lizlarkin/highland/client/src/Components/GeneralJumbotron/Images/Search.png

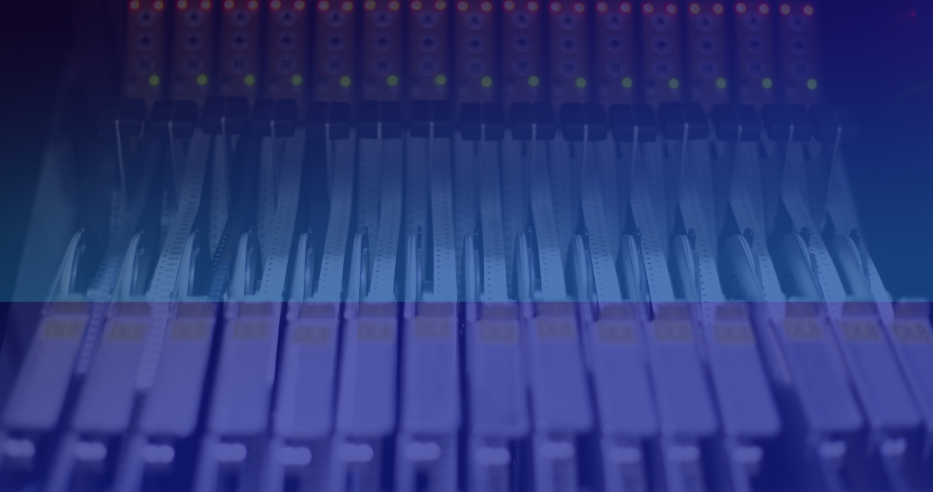
client/src/Components/GeneralJumbotron/Images/Search.png
