lizlarkin/highland/client/src/Components/CategoryJumbotron/img/Laser_Drivers_Controllers.png

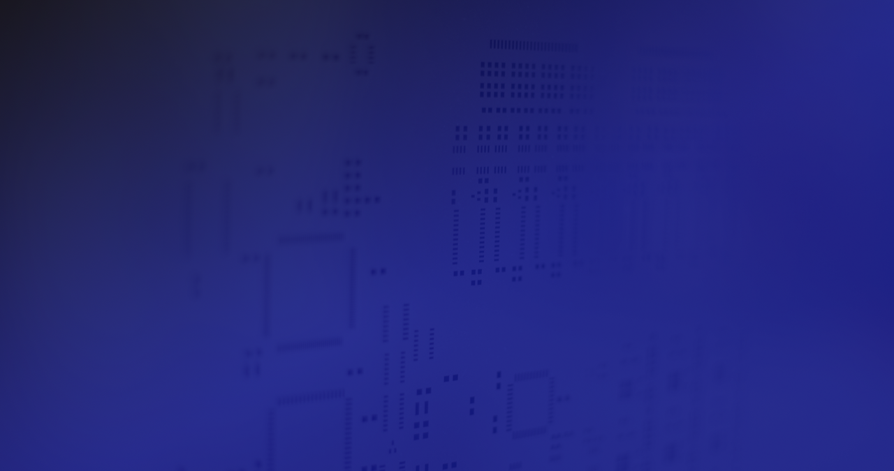
client/src/Components/CategoryJumbotron/img/Laser_Drivers_Controllers.png
