lizlarkin/highland/client/src/Pages/About/img/About_Products.png

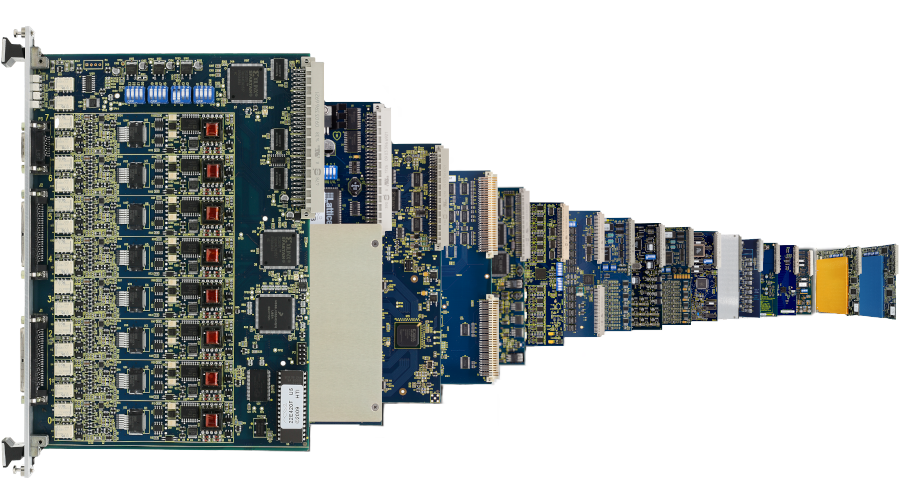
client/src/Pages/About/img/About_Products.png
