lizlarkin/highland/client/src/Pages/About/img/Highland_Front.png

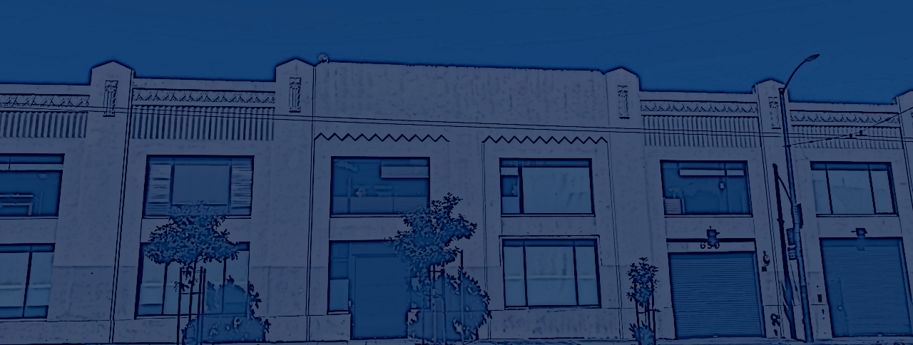
client/src/Pages/About/img/Highland_Front.png
