lizlarkin/highland/client/src/Pages/About/img/JohnLarkin.png

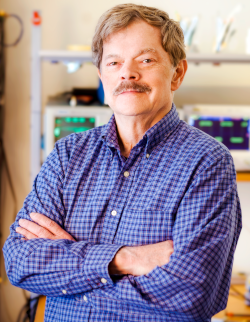
client/src/Pages/About/img/JohnLarkin.png
