lizlarkin/highland/client/src/Pages/About/img/Mission.jpeg

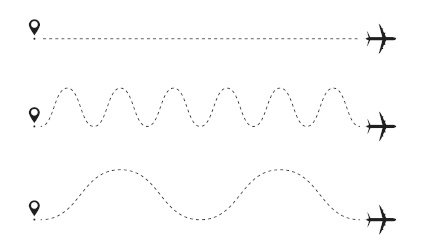
client/src/Pages/About/img/Mission.jpeg
