lizlarkin/highland/client/src/Pages/About/img/Our_Business.png

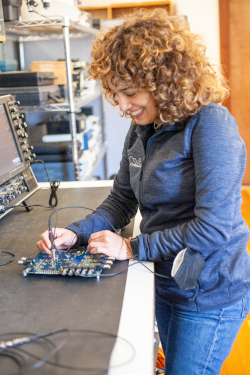
client/src/Pages/About/img/Our_Business.png
