lizlarkin/highland/client/src/Pages/About/img/Products.png

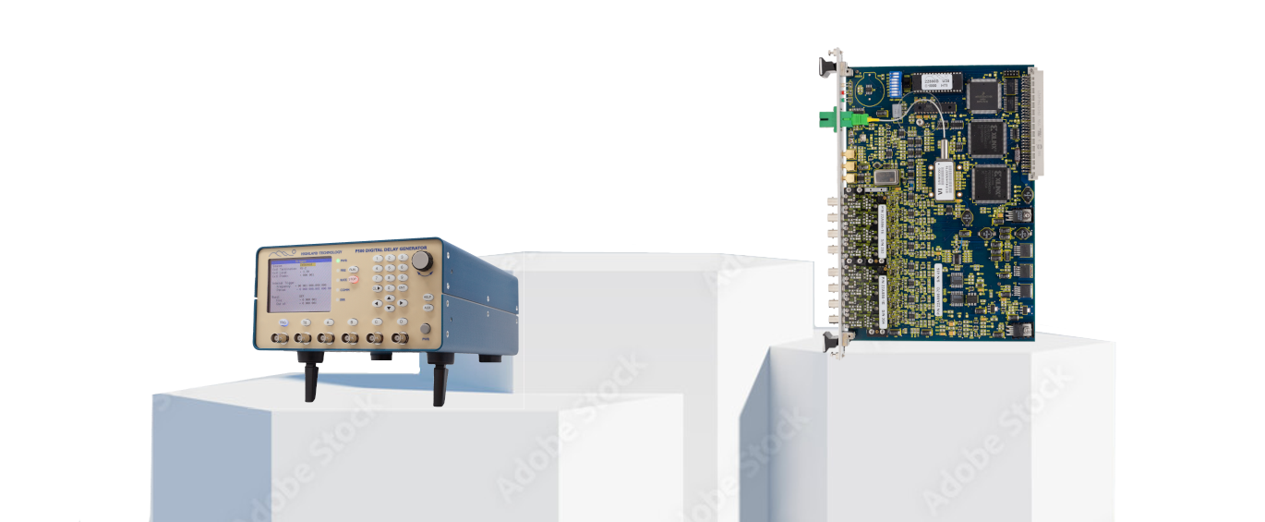
client/src/Pages/About/img/Products.png
