lizlarkin/highland/client/src/Pages/Customers/Images/Agilent.png

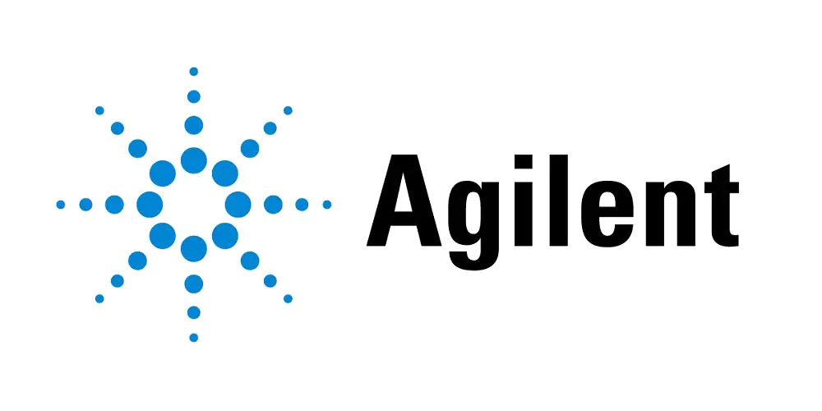
client/src/Pages/Customers/Images/Agilent.png
