lizlarkin/highland/client/src/Pages/Customers/Images/Andor.png

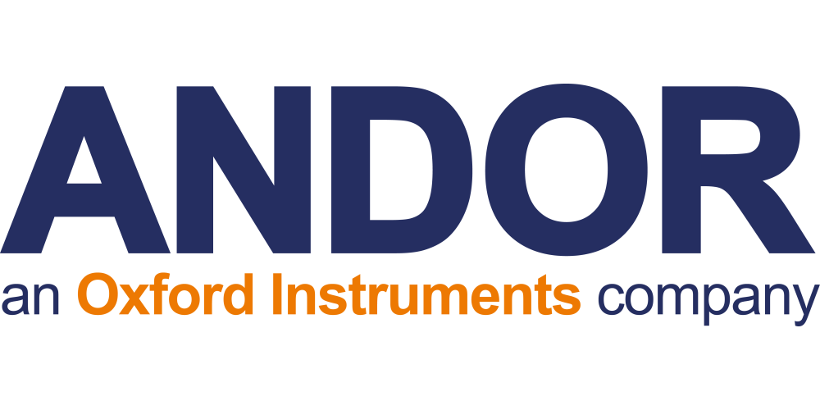
client/src/Pages/Customers/Images/Andor.png
