lizlarkin/highland/client/src/Pages/Customers/Images/BAE.png

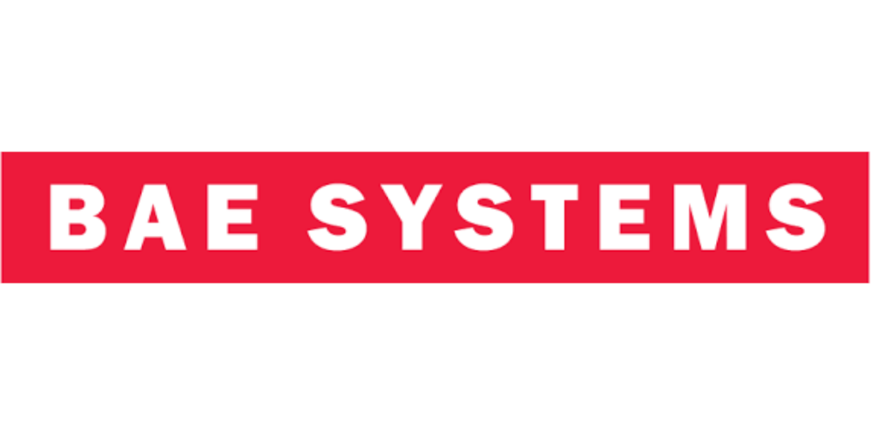
client/src/Pages/Customers/Images/BAE.png
