lizlarkin/highland/client/src/Pages/Customers/Images/Boeing.png

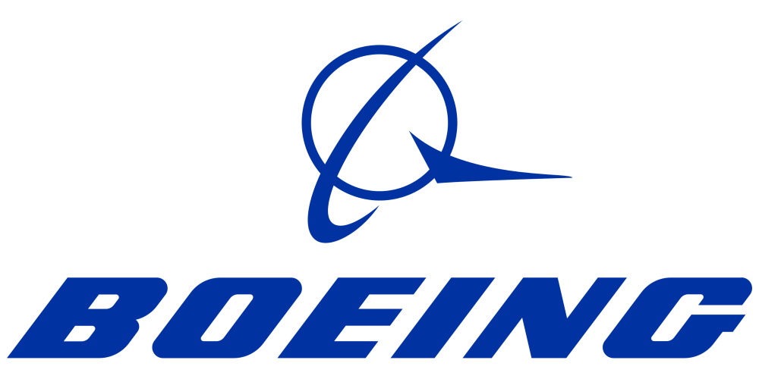
client/src/Pages/Customers/Images/Boeing.png
