lizlarkin/highland/client/src/Pages/Customers/Images/CERN.png

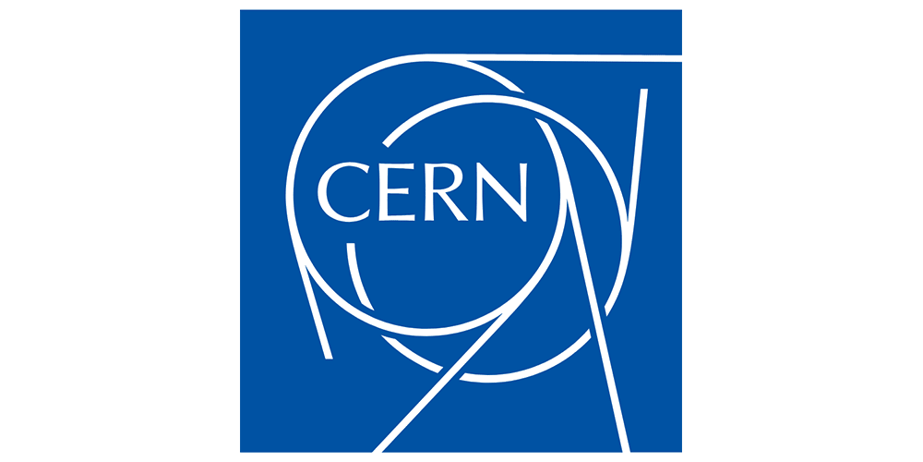
client/src/Pages/Customers/Images/CERN.png
