lizlarkin/highland/client/src/Pages/Customers/Images/EADS.png

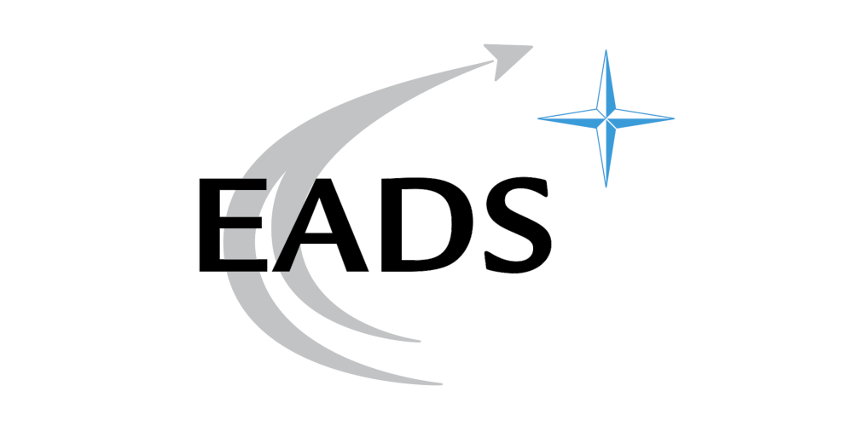
client/src/Pages/Customers/Images/EADS.png
