lizlarkin/highland/client/src/Pages/Customers/Images/General_Atomics.png

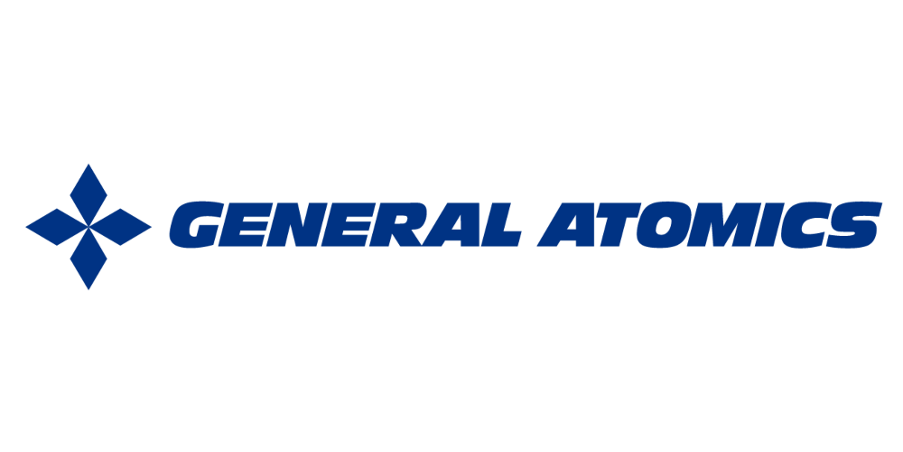
client/src/Pages/Customers/Images/General_Atomics.png
