lizlarkin/highland/client/src/Pages/Customers/Images/General_Dynamics.png

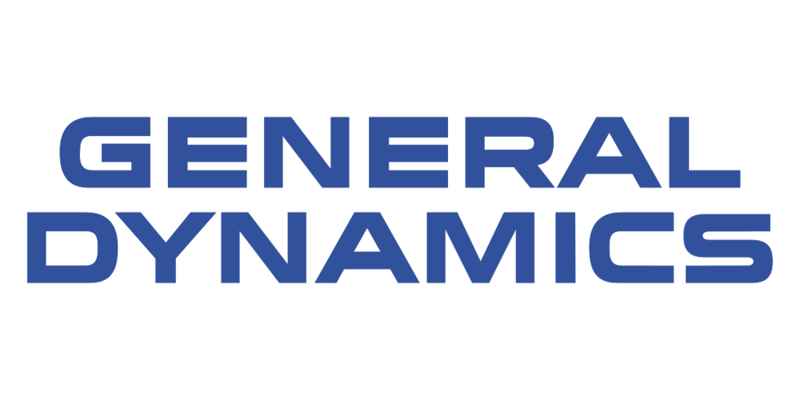
client/src/Pages/Customers/Images/General_Dynamics.png
