lizlarkin/highland/client/src/Pages/Customers/Images/General_Electric.png

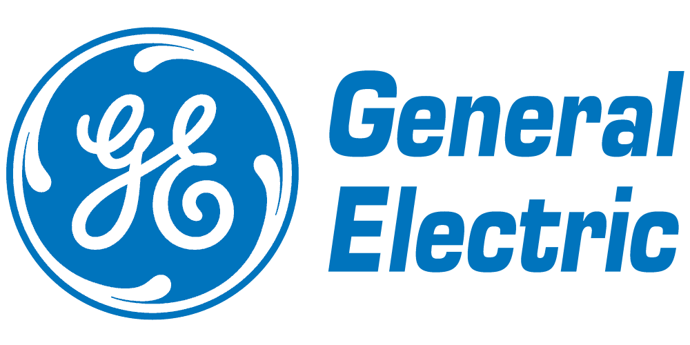
client/src/Pages/Customers/Images/General_Electric.png
