lizlarkin/highland/client/src/Pages/Customers/Images/Hamamatsu.png

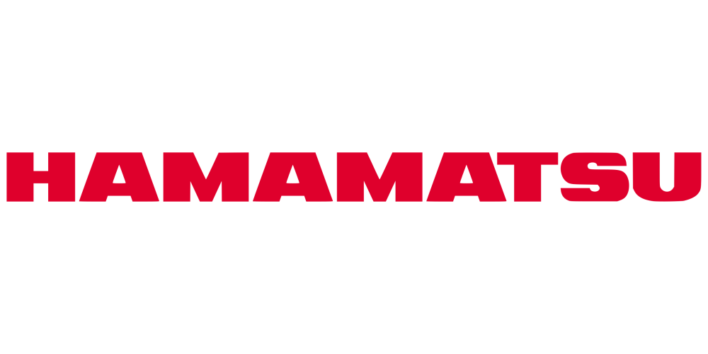
client/src/Pages/Customers/Images/Hamamatsu.png
