lizlarkin/highland/client/src/Pages/Customers/Images/Hamilton_Sundstrand.png

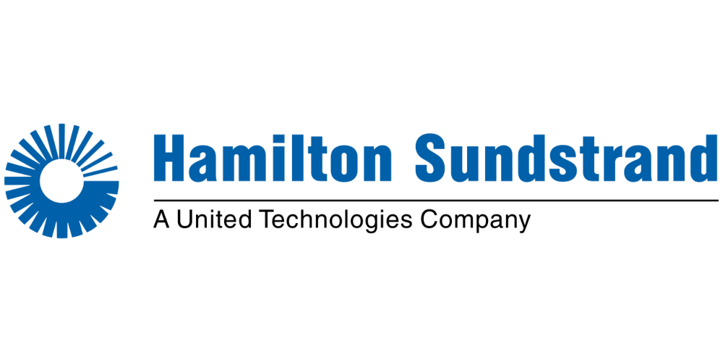
client/src/Pages/Customers/Images/Hamilton_Sundstrand.png
