lizlarkin/highland/client/src/Pages/Customers/Images/Honeywell.png

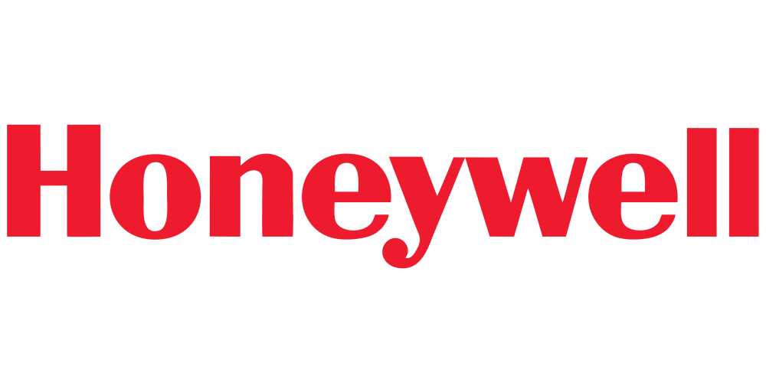
client/src/Pages/Customers/Images/Honeywell.png
