lizlarkin/highland/client/src/Pages/Customers/Images/Jefferson_Lab.png

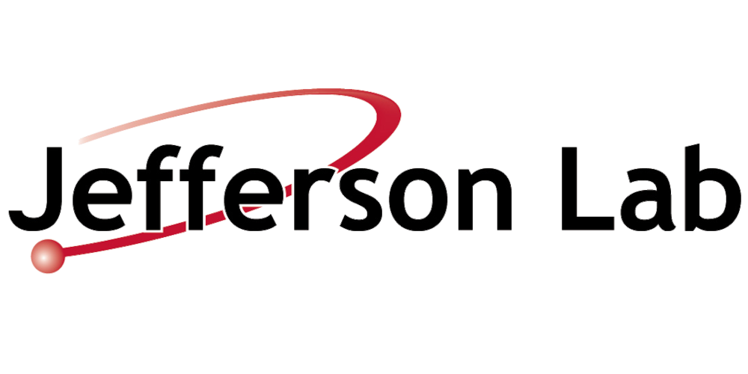
client/src/Pages/Customers/Images/Jefferson_Lab.png
