lizlarkin/highland/client/src/Pages/Customers/Images/Johns_Hopkins.png

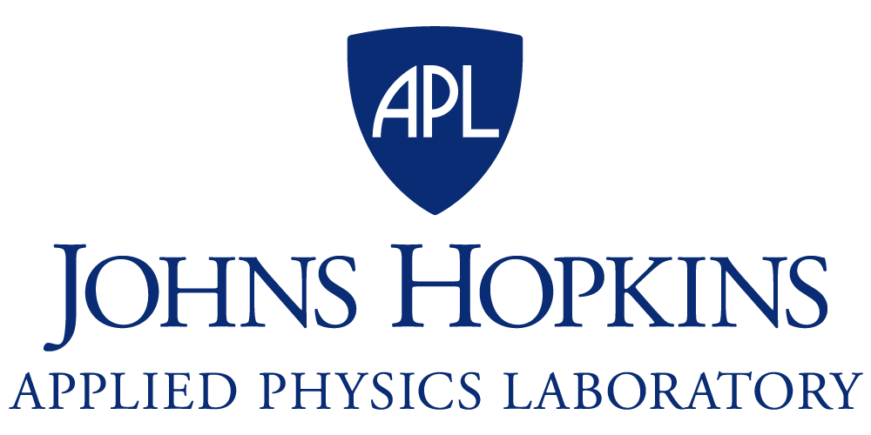
client/src/Pages/Customers/Images/Johns_Hopkins.png
