lizlarkin/highland/client/src/Pages/Customers/Images/L3Harris.png

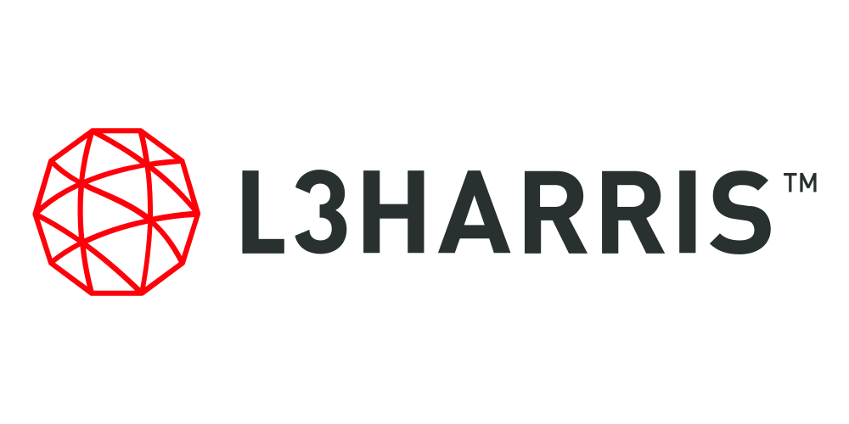
client/src/Pages/Customers/Images/L3Harris.png
