lizlarkin/highland/client/src/Pages/Customers/Images/LANL.png

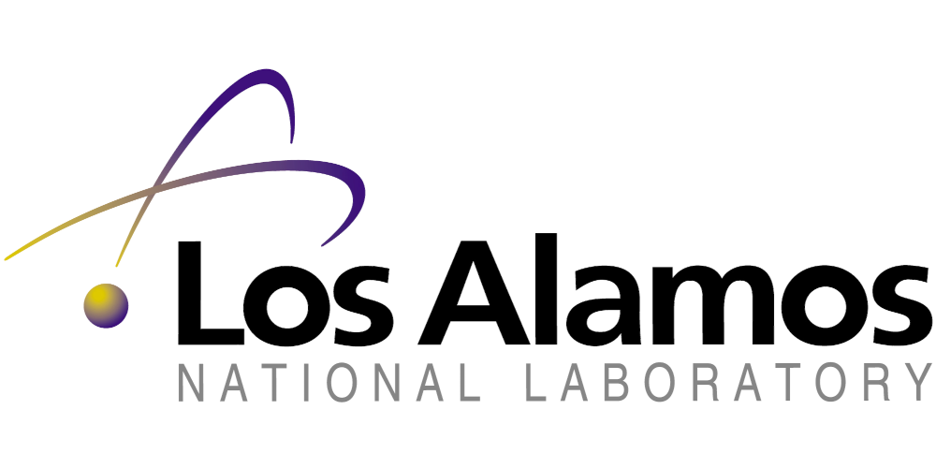
client/src/Pages/Customers/Images/LANL.png
