lizlarkin/highland/client/src/Pages/Customers/Images/LLNL.png

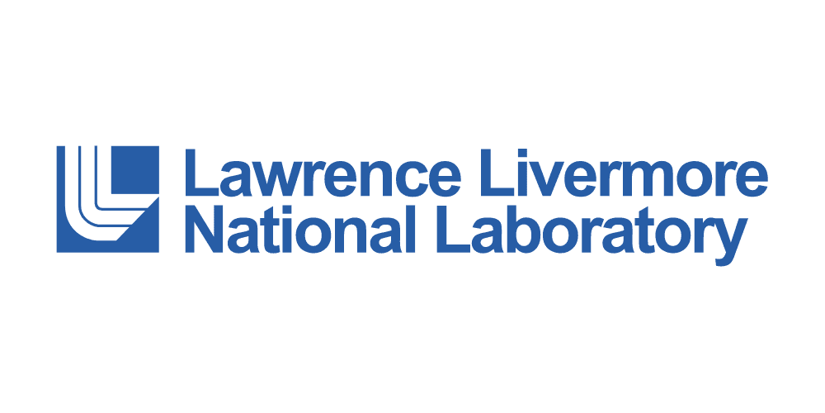
client/src/Pages/Customers/Images/LLNL.png
