lizlarkin/highland/client/src/Pages/Customers/Images/Lockheed_Martin.png

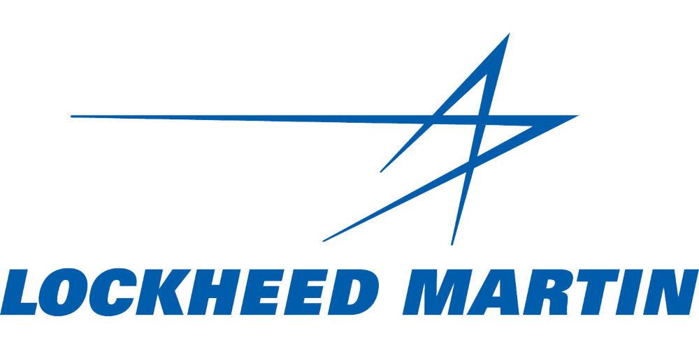
client/src/Pages/Customers/Images/Lockheed_Martin.png
