lizlarkin/highland/client/src/Pages/Customers/Images/MIT_LL.png

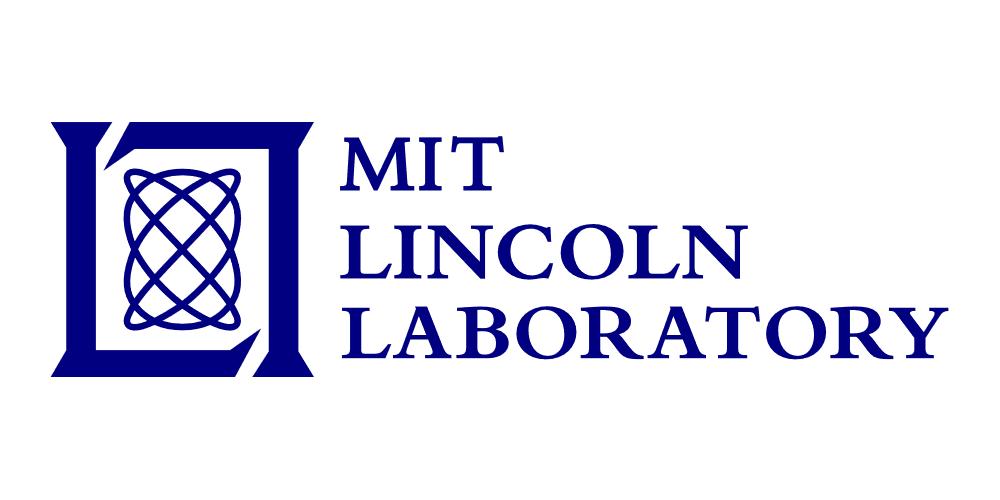
client/src/Pages/Customers/Images/MIT_LL.png
