lizlarkin/highland/client/src/Pages/Customers/Images/NASA_JPL.png

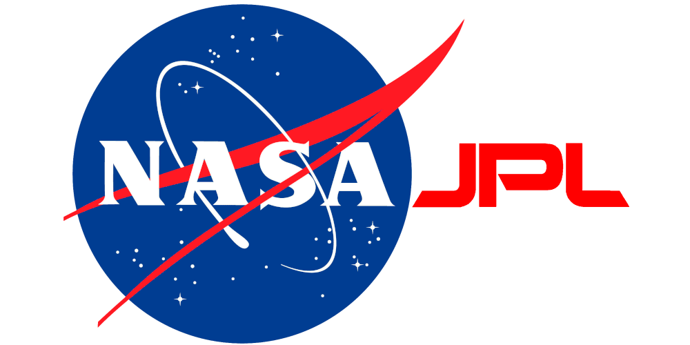
client/src/Pages/Customers/Images/NASA_JPL.png
