lizlarkin/highland/client/src/Pages/Customers/Images/NIST.png

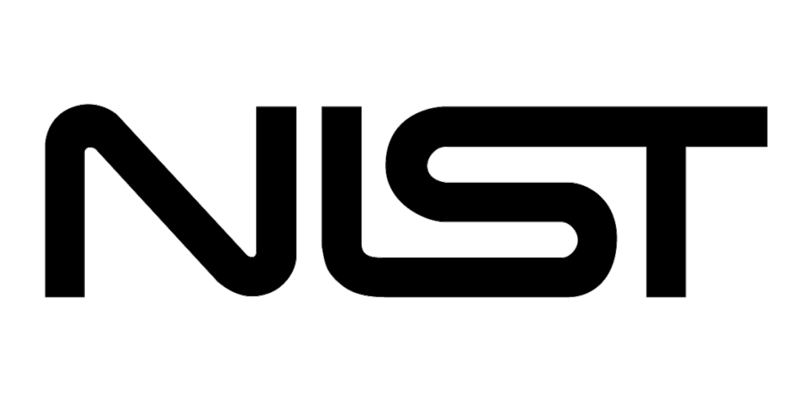
client/src/Pages/Customers/Images/NIST.png
