lizlarkin/highland/client/src/Pages/Customers/Images/Northrop_Grumman.png

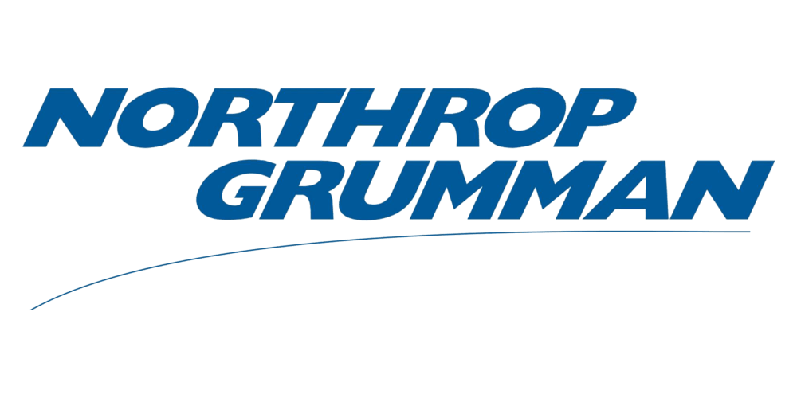
client/src/Pages/Customers/Images/Northrop_Grumman.png
