lizlarkin/highland/client/src/Pages/Customers/Images/Panasonic.png

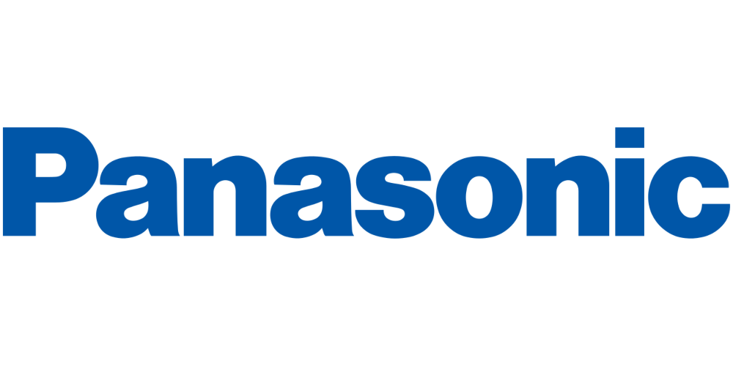
client/src/Pages/Customers/Images/Panasonic.png
