lizlarkin/highland/client/src/Pages/Customers/Images/PNNL_Battelle.png

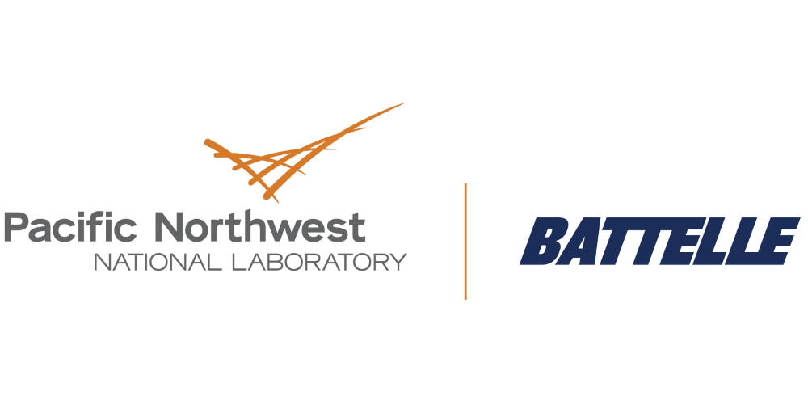
client/src/Pages/Customers/Images/PNNL_Battelle.png
