lizlarkin/highland/client/src/Pages/Customers/Images/Pratt_Whitney.png

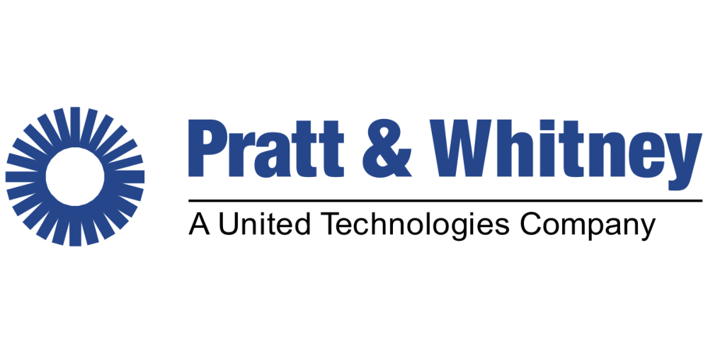
client/src/Pages/Customers/Images/Pratt_Whitney.png
