lizlarkin/highland/client/src/Pages/Customers/Images/Raytheon.png

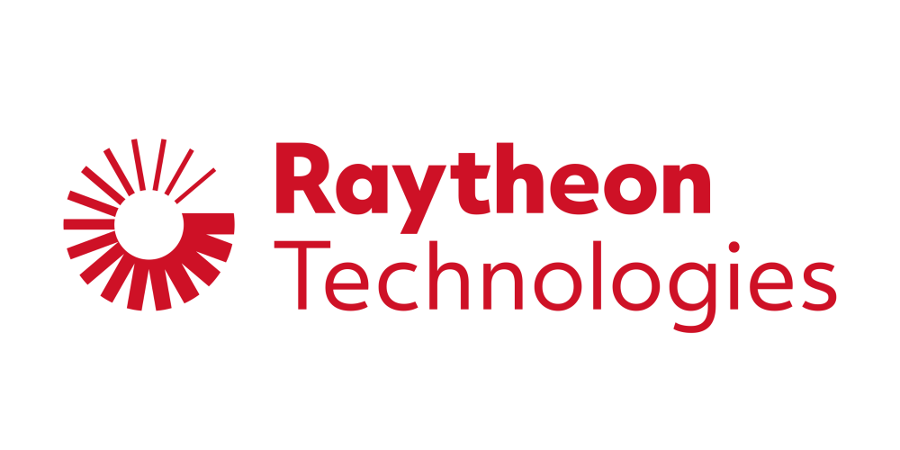
client/src/Pages/Customers/Images/Raytheon.png
