lizlarkin/highland/client/src/Pages/Customers/Images/Rolls_Royce.png

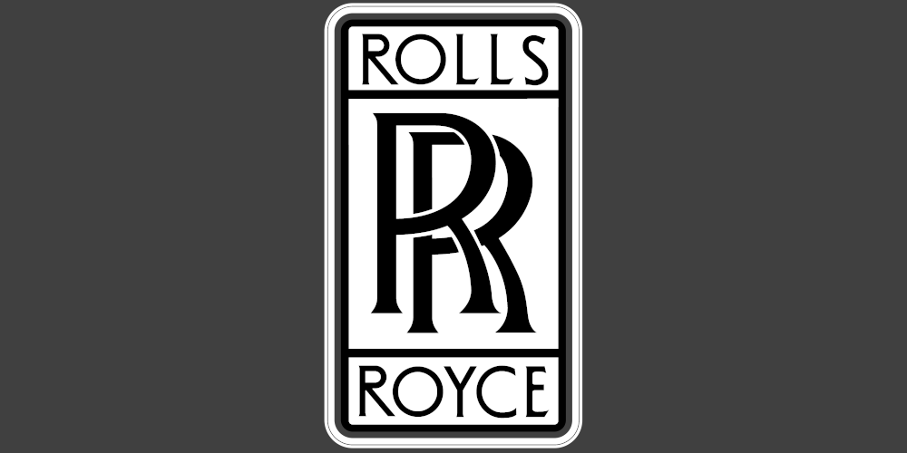
client/src/Pages/Customers/Images/Rolls_Royce.png
