lizlarkin/highland/client/src/Pages/Customers/Images/Saab.png

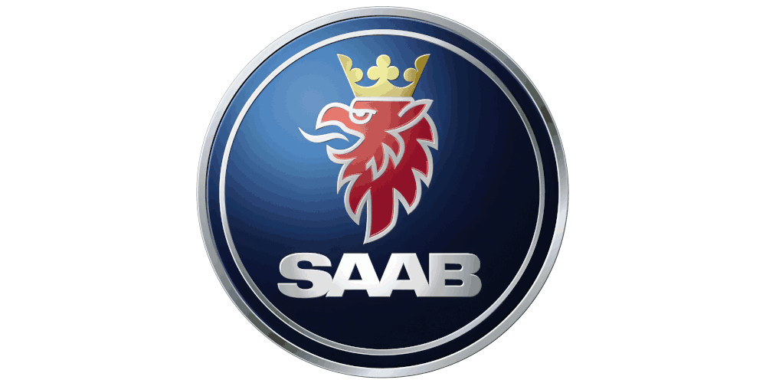
client/src/Pages/Customers/Images/Saab.png
