lizlarkin/highland/client/src/Pages/Customers/Images/SAIC.png

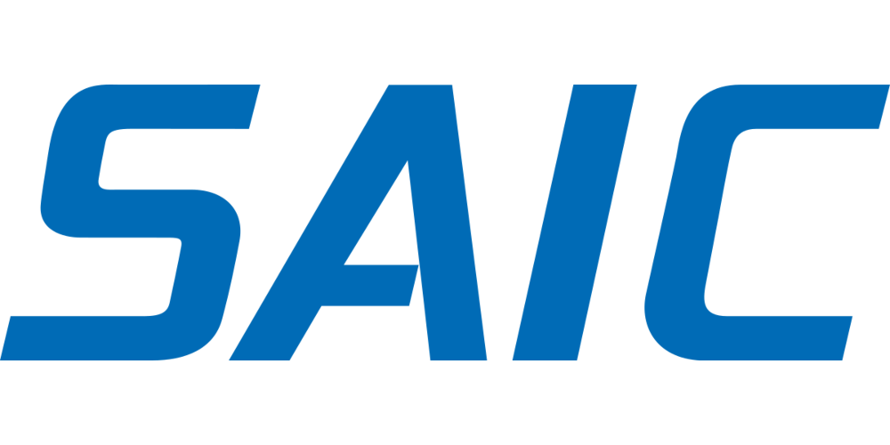
client/src/Pages/Customers/Images/SAIC.png
