lizlarkin/highland/client/src/Pages/Customers/Images/Sandia.png

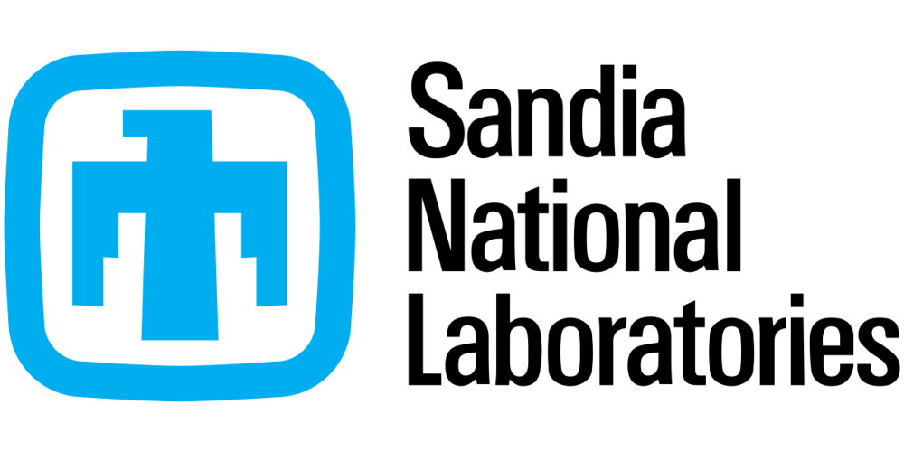
client/src/Pages/Customers/Images/Sandia.png
