lizlarkin/highland/client/src/Pages/Customers/Images/Thales.png

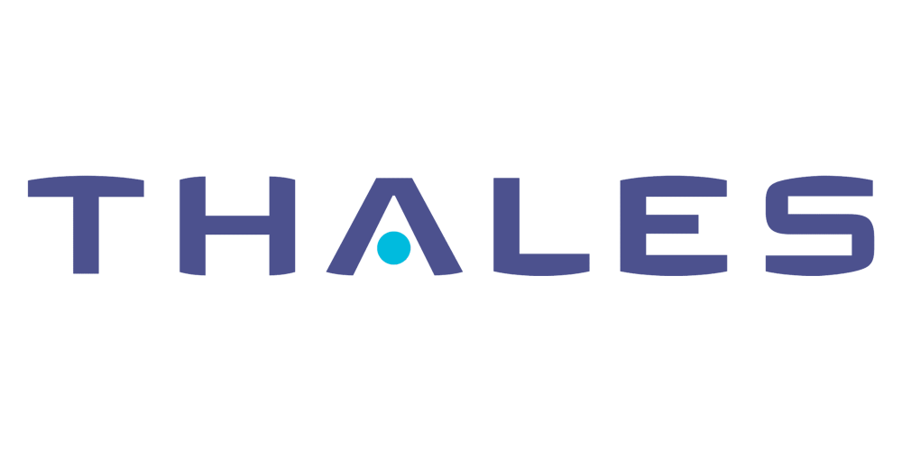
client/src/Pages/Customers/Images/Thales.png
