lizlarkin/highland/client/src/Pages/Customers/Images/Thorlabs.png

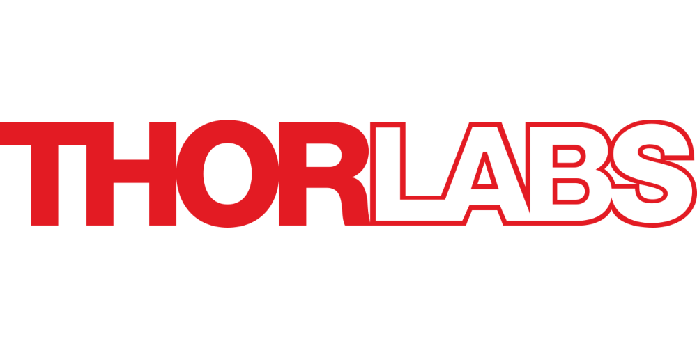
client/src/Pages/Customers/Images/Thorlabs.png
