lizlarkin/highland/client/src/Pages/Customers/Images/Trumpf.png

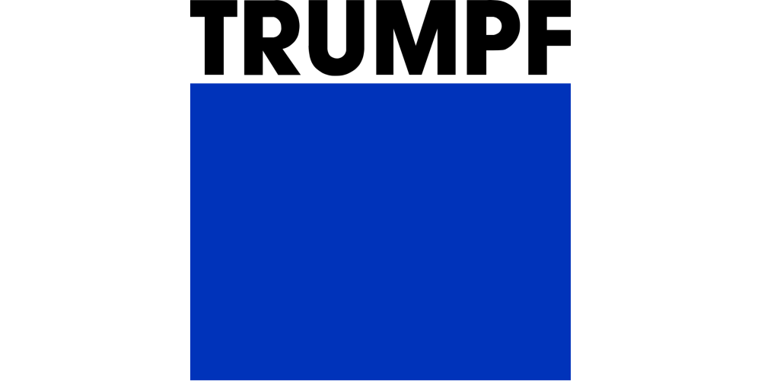
client/src/Pages/Customers/Images/Trumpf.png
