lizlarkin/highland/client/src/Pages/Customers/Images/United.png

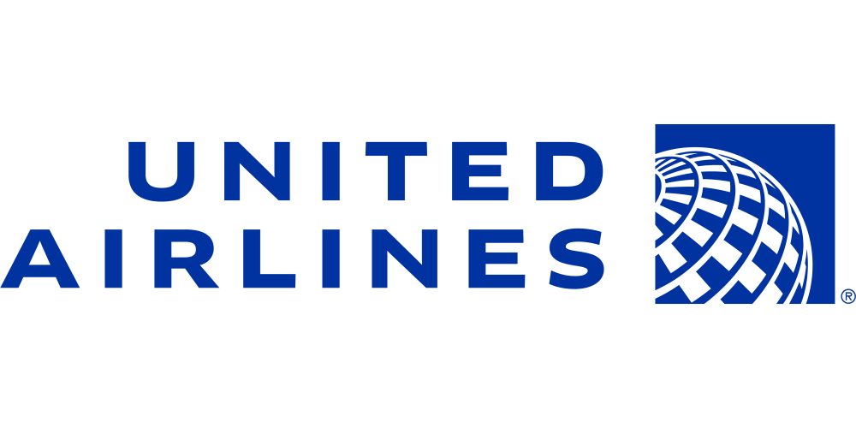
client/src/Pages/Customers/Images/United.png
