lizlarkin/highland/client/src/Pages/Home/assets/Custom_Home.jpeg

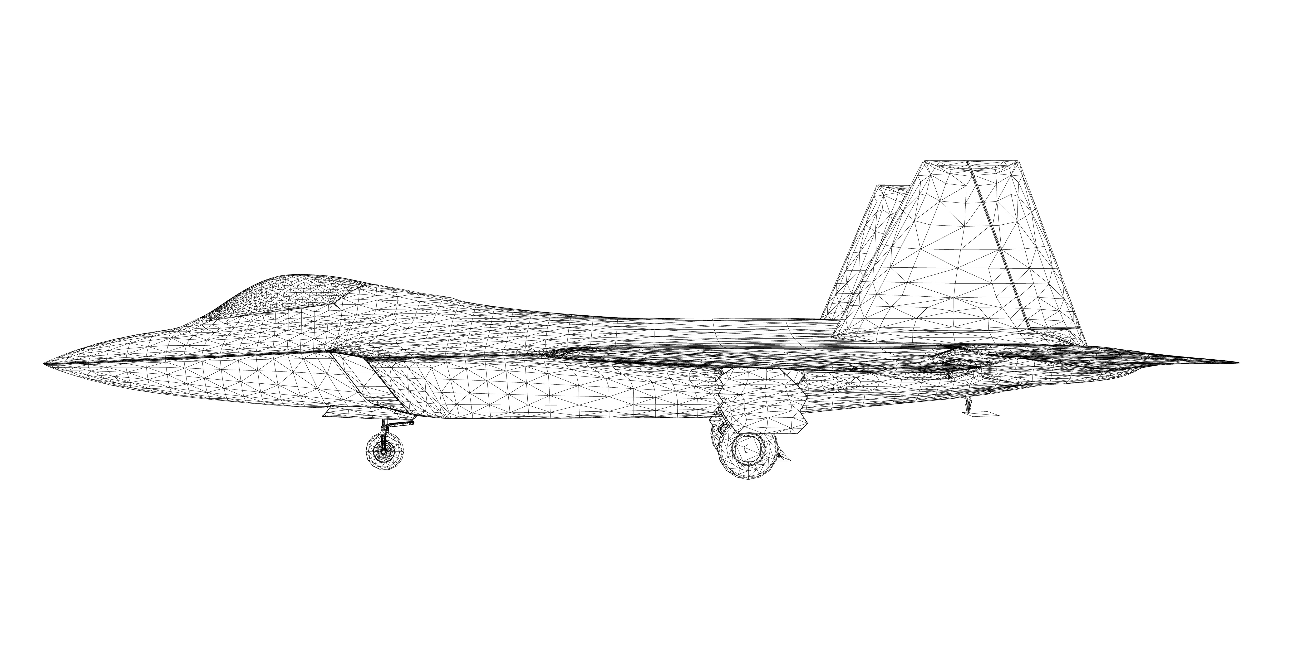
client/src/Pages/Home/assets/Custom_Home.jpeg
