lizlarkin/highland/client/src/Pages/Home/assets/home-background-1.jpeg

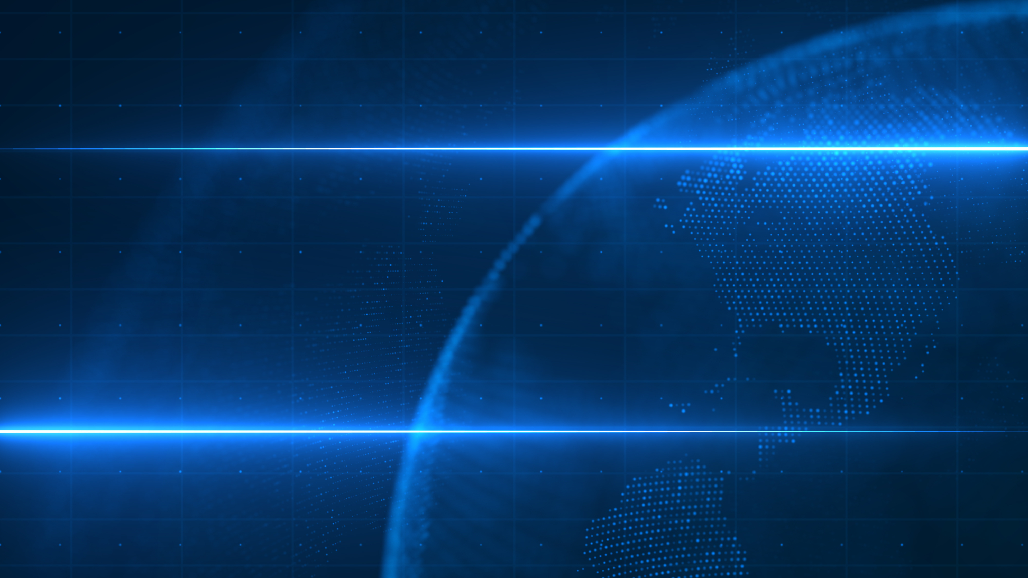
client/src/Pages/Home/assets/home-background-1.jpeg
