lizlarkin/highland/client/src/Pages/Home/assets/home-background-2.jpeg

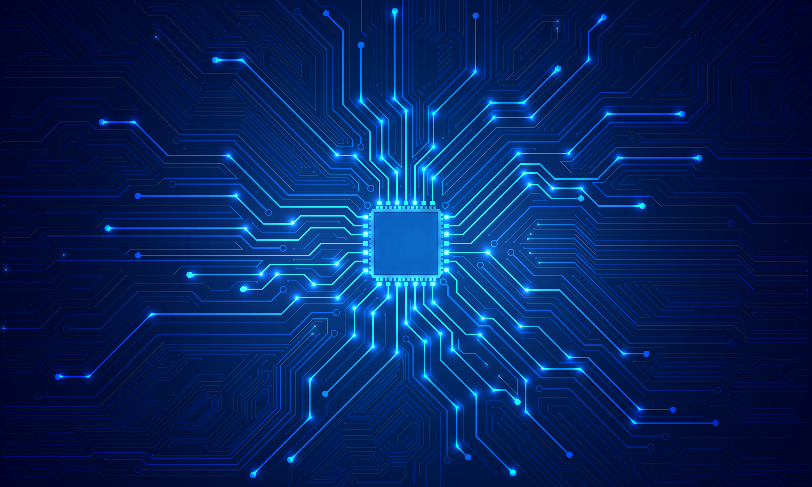
client/src/Pages/Home/assets/home-background-2.jpeg
