lizlarkin/highland/client/src/Pages/Home/assets/T680_Home.png

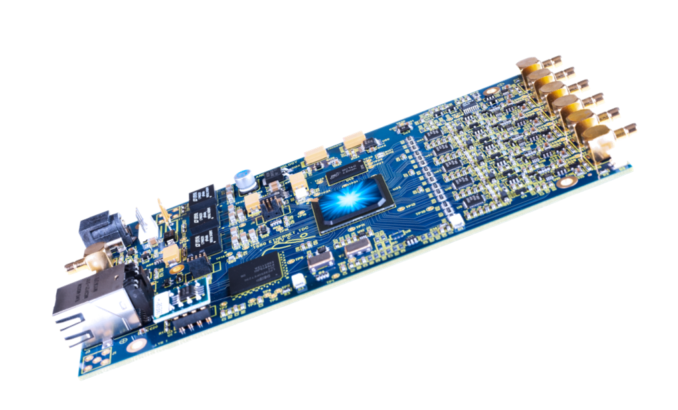
client/src/Pages/Home/assets/T680_Home.png
