lizlarkin/highland/client/src/Pages/Partners/images/DMD2.png

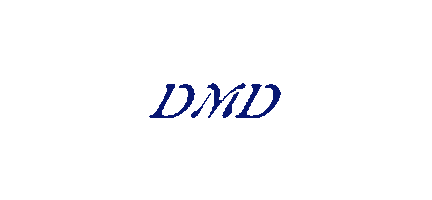
client/src/Pages/Partners/images/DMD2.png
