lizlarkin/highland/client/src/Pages/Partners/images/EEIPL.png

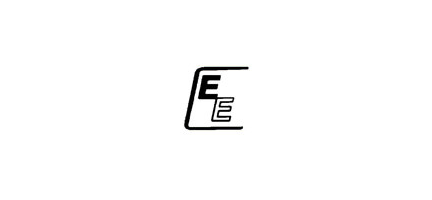
client/src/Pages/Partners/images/EEIPL.png
