lizlarkin/highland/client/src/Pages/Partners/images/Electro_Optical.png

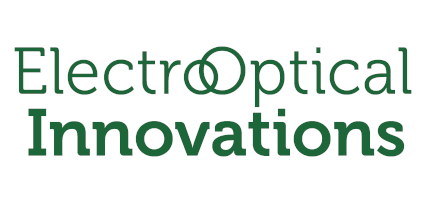
client/src/Pages/Partners/images/Electro_Optical.png
