lizlarkin/highland/client/src/Pages/Partners/images/Photodigm.png

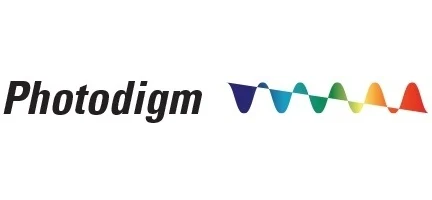
client/src/Pages/Partners/images/Photodigm.png
