lizlarkin/highland/client/src/Pages/Product/AccImages/463-1003_Phoenix_Connector.png

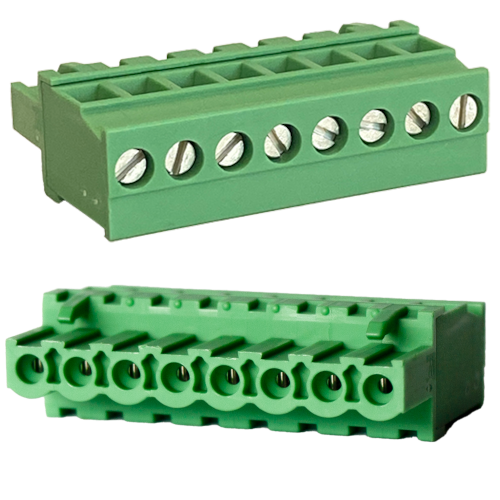
client/src/Pages/Product/AccImages/463-1003_Phoenix_Connector.png
