lizlarkin/highland/client/src/Pages/Product/AccImages/J4_PCIe_Cable.png

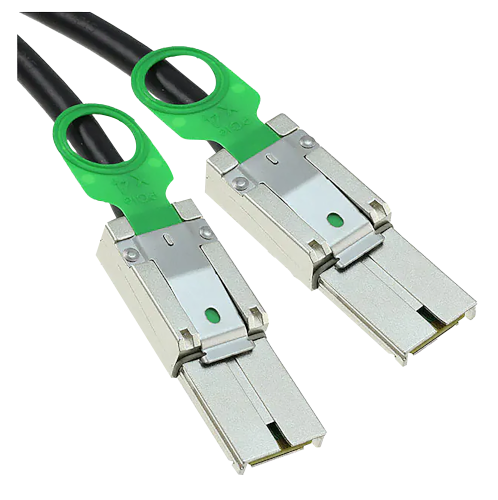
client/src/Pages/Product/AccImages/J4_PCIe_Cable.png
