lizlarkin/highland/client/src/Pages/Product/AccImages/J6_5V_USB_Power_Supply.png

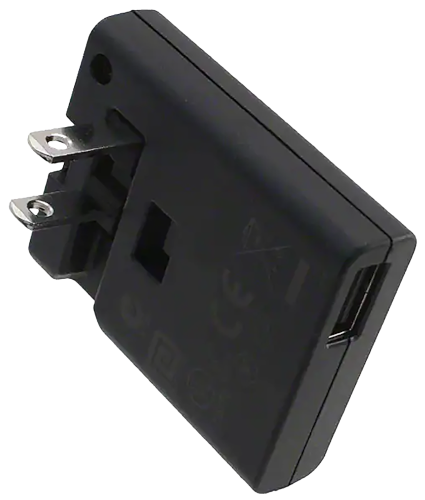
client/src/Pages/Product/AccImages/J6_5V_USB_Power_Supply.png
