lizlarkin/highland/client/src/Pages/Product/AccImages/J12_12V_Power_Supply.png

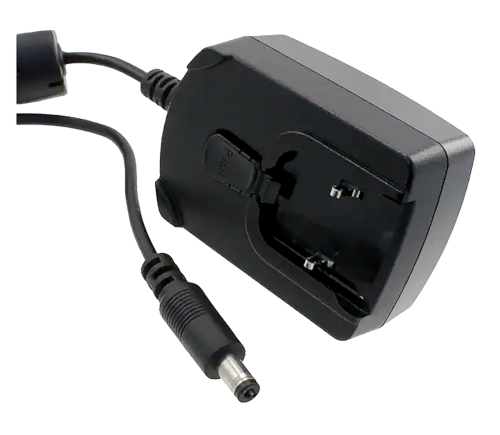
client/src/Pages/Product/AccImages/J12_12V_Power_Supply.png
