lizlarkin/highland/client/src/Pages/Product/AccImages/J25_24V_Power_Supply.png

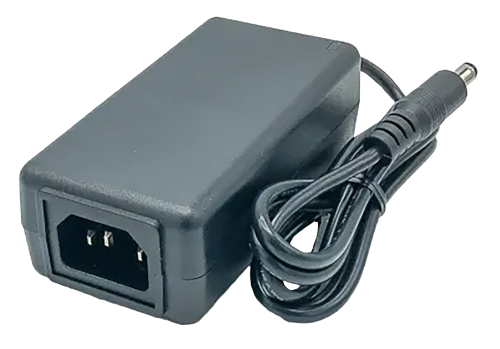
client/src/Pages/Product/AccImages/J25_24V_Power_Supply.png
