lizlarkin/highland/client/src/Pages/Product/AccImages/J27_Pigtail_Power_Cable.png

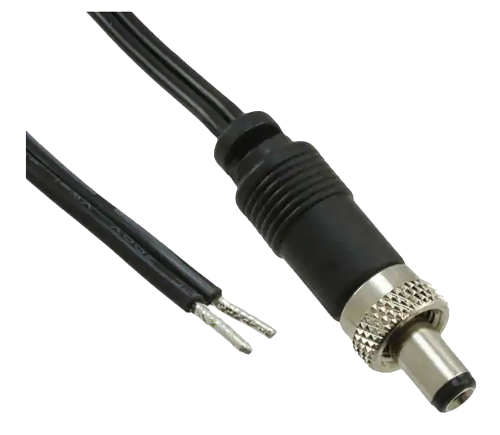
client/src/Pages/Product/AccImages/J27_Pigtail_Power_Cable.png
