lizlarkin/highland/client/src/Pages/Product/AccImages/J40_48V_Power_Supply.png

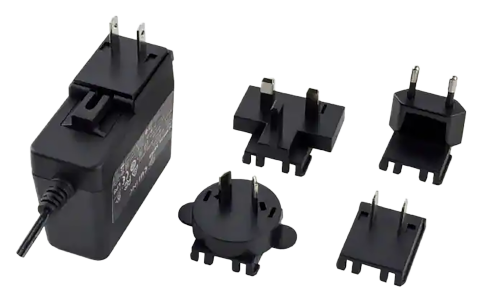
client/src/Pages/Product/AccImages/J40_48V_Power_Supply.png
