lizlarkin/highland/client/src/Pages/Product/AccImages/J41_SMB_SMB_Cable.png

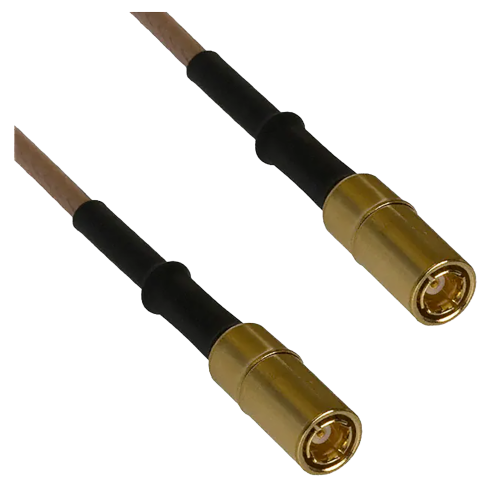
client/src/Pages/Product/AccImages/J41_SMB_SMB_Cable.png
