lizlarkin/highland/client/src/Pages/Product/AccImages/J42_SMB_SMA_Cable.png

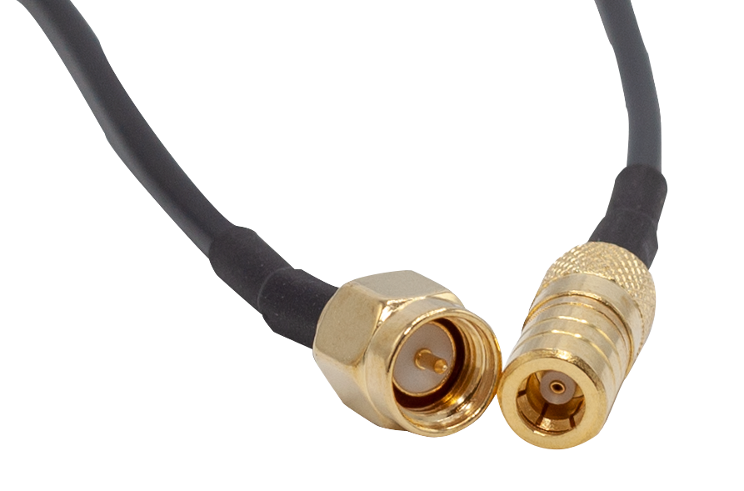
client/src/Pages/Product/AccImages/J42_SMB_SMA_Cable.png
