lizlarkin/highland/client/src/Pages/Product/AccImages/J43_BNC_BNC_Cable.png

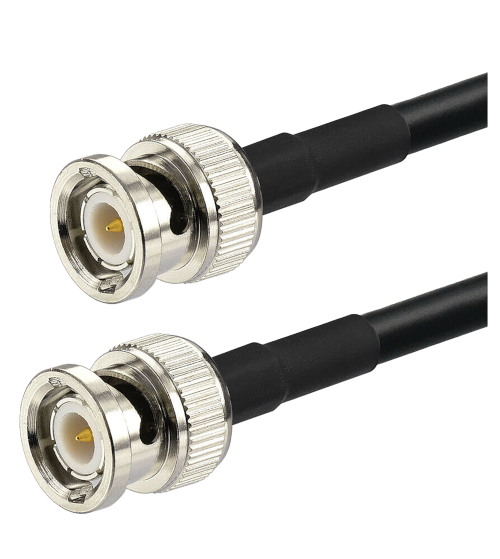
client/src/Pages/Product/AccImages/J43_BNC_BNC_Cable.png
