lizlarkin/highland/client/src/Pages/Product/AccImages/J44_SMA_SMA_Cable.png

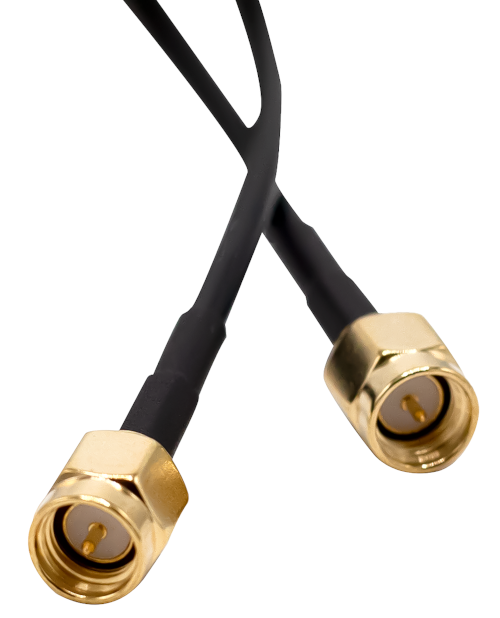
client/src/Pages/Product/AccImages/J44_SMA_SMA_Cable.png
