lizlarkin/highland/client/src/Pages/Product/AccImages/J47_BNC_Terminator.png

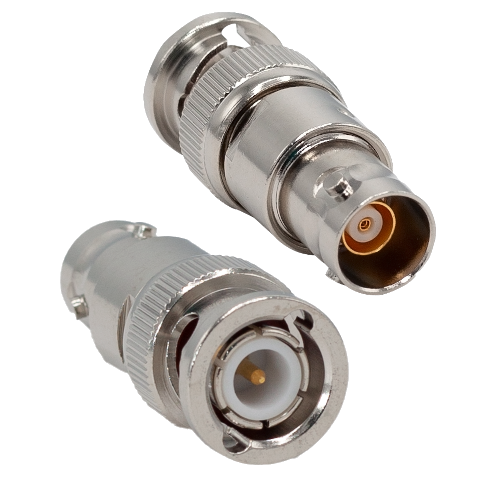
client/src/Pages/Product/AccImages/J47_BNC_Terminator.png
