lizlarkin/highland/client/src/Pages/Product/AccImages/J48_50_Ohm_SMA_Terminator.png

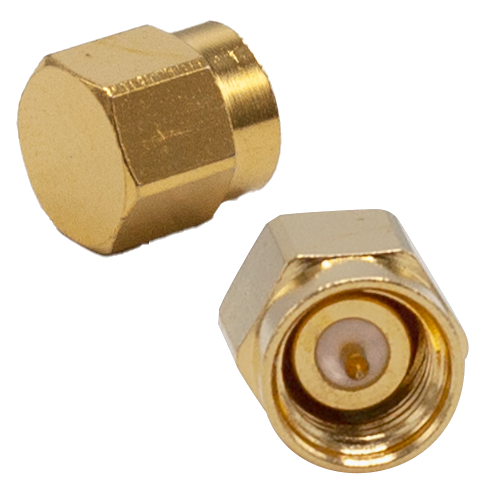
client/src/Pages/Product/AccImages/J48_50_Ohm_SMA_Terminator.png
