lizlarkin/highland/client/src/Pages/Product/AccImages/J50_50_Ohm_SMB_Terminator.png

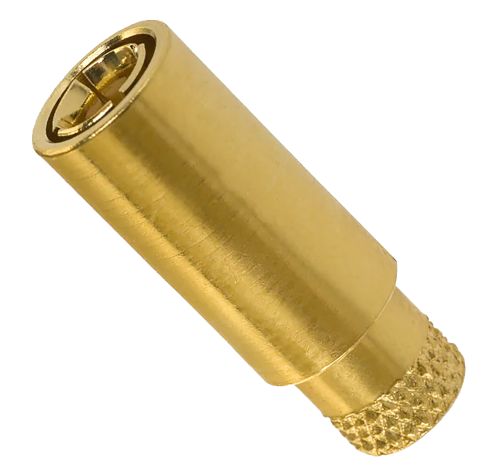
client/src/Pages/Product/AccImages/J50_50_Ohm_SMB_Terminator.png
