lizlarkin/highland/client/src/Pages/Product/AccImages/J51_Shielded_Pair_SCSI_cable.png

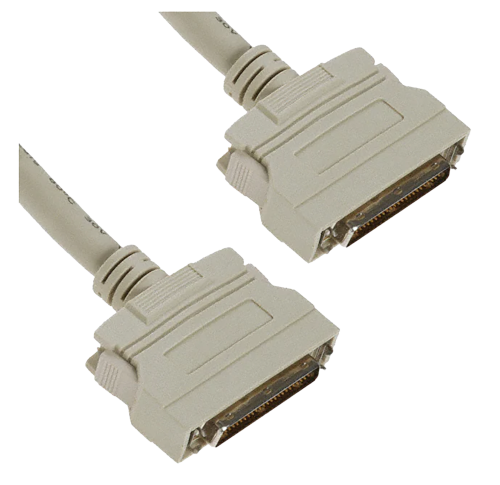
client/src/Pages/Product/AccImages/J51_Shielded_Pair_SCSI_cable.png
