lizlarkin/highland/client/src/Pages/Product/AccImages/J53_SMB_BNC_Cable.png

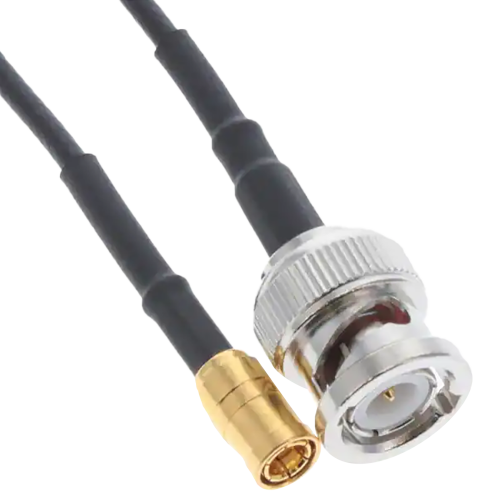
client/src/Pages/Product/AccImages/J53_SMB_BNC_Cable.png
