lizlarkin/highland/client/src/Pages/Product/AccImages/J55_DB25M_DB25M_Cable.png

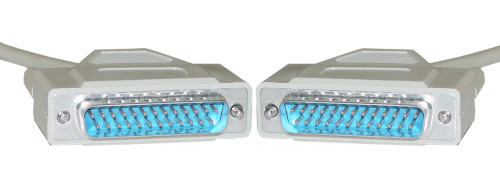
client/src/Pages/Product/AccImages/J55_DB25M_DB25M_Cable.png
