lizlarkin/highland/client/src/Pages/Product/AccImages/J57_D9_RS-232_Cable.png

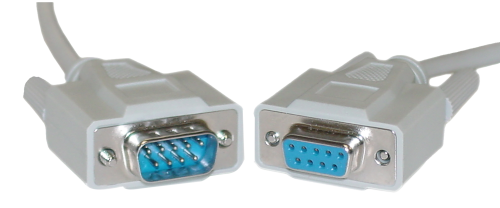
client/src/Pages/Product/AccImages/J57_D9_RS-232_Cable.png
