lizlarkin/highland/client/src/Pages/Product/AccImages/J58_SCSI_SCSI_Cable.png

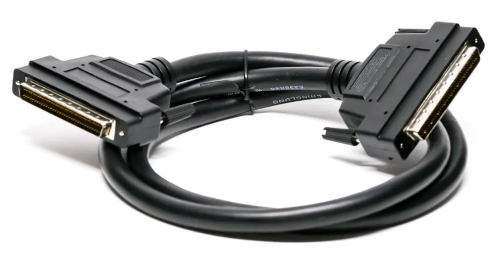
client/src/Pages/Product/AccImages/J58_SCSI_SCSI_Cable.png
