lizlarkin/highland/client/src/Pages/Product/AccImages/J59_ST_ST_Fiberoptic_Cable.png

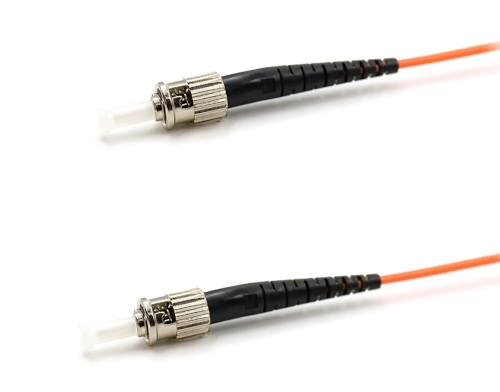
client/src/Pages/Product/AccImages/J59_ST_ST_Fiberoptic_Cable.png
