lizlarkin/highland/client/src/Pages/Product/AccImages/J60_FC_FC_Fiberoptic_Cable.png

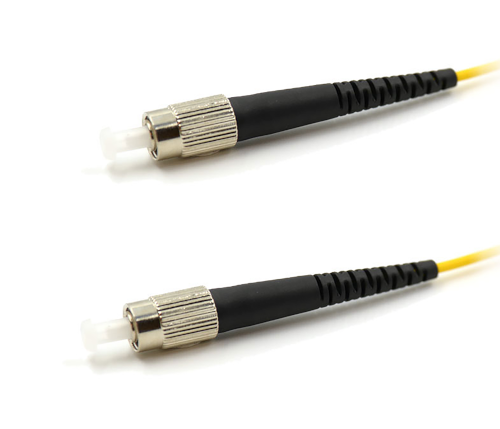
client/src/Pages/Product/AccImages/J60_FC_FC_Fiberoptic_Cable.png
