lizlarkin/highland/client/src/Pages/Product/AccImages/J61_ST_ST_Fiberoptic_Cable.png

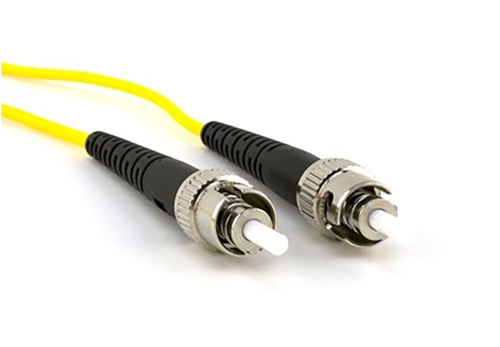
client/src/Pages/Product/AccImages/J61_ST_ST_Fiberoptic_Cable.png
