lizlarkin/highland/client/src/Pages/Product/AccImages/J62_Male_A_Male_B_USB_Cable.png

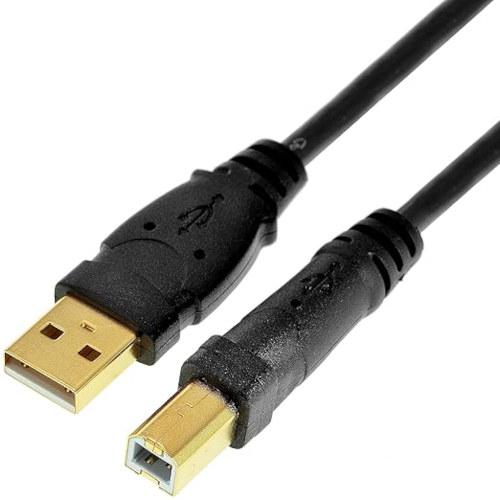
client/src/Pages/Product/AccImages/J62_Male_A_Male_B_USB_Cable.png
