lizlarkin/highland/client/src/Pages/Product/AccImages/J65_V365_Mating_Connector_Set.png

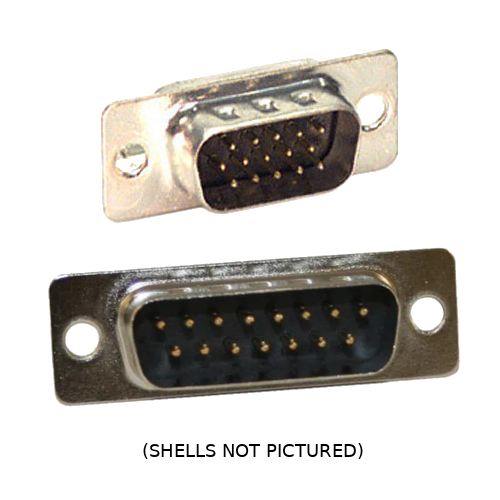
client/src/Pages/Product/AccImages/J65_V365_Mating_Connector_Set.png
