lizlarkin/highland/client/src/Pages/Product/AccImages/J71_Dual_DB9F_Agilent34104A_Cable.png

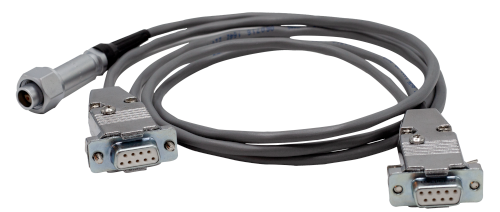
client/src/Pages/Product/AccImages/J71_Dual_DB9F_Agilent34104A_Cable.png
