lizlarkin/highland/client/src/Pages/Product/AccImages/J75_D9_Banana_Cable.png

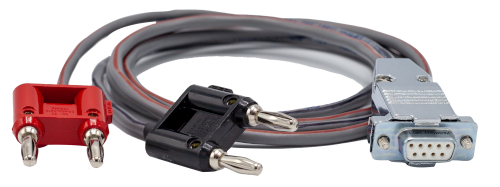
client/src/Pages/Product/AccImages/J75_D9_Banana_Cable.png
