lizlarkin/highland/client/src/Pages/Product/AccImages/J76_D9_OpenCVA_Busing_Cable.png

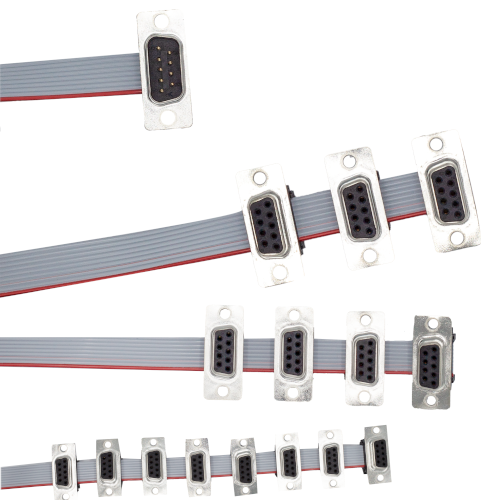
client/src/Pages/Product/AccImages/J76_D9_OpenCVA_Busing_Cable.png
