lizlarkin/highland/client/src/Pages/Product/AccImages/J90_P900_Phoenix_Terminal_Block.png

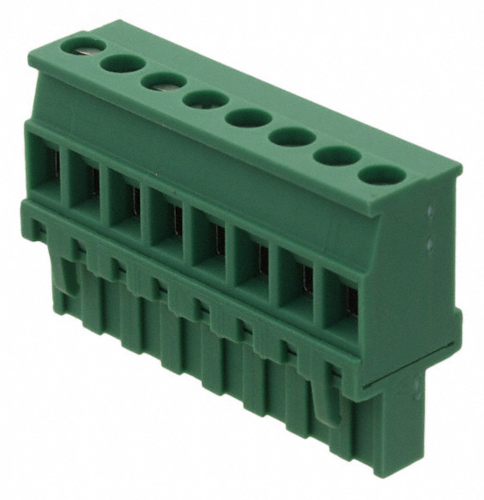
client/src/Pages/Product/AccImages/J90_P900_Phoenix_Terminal_Block.png
