lizlarkin/highland/client/src/Pages/Product/AccImages/J91_P940_Blank_Rear_Panel.png

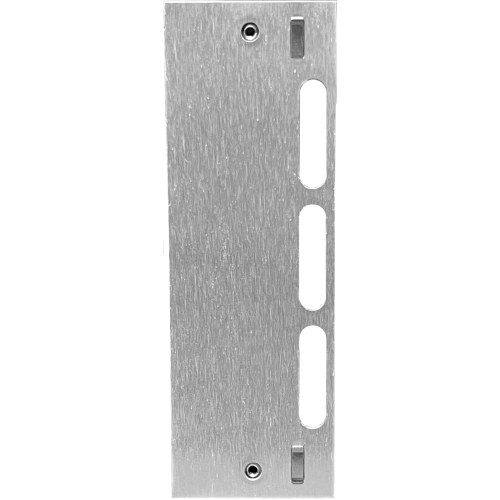
client/src/Pages/Product/AccImages/J91_P940_Blank_Rear_Panel.png
