lizlarkin/highland/client/src/Pages/Product/AccImages/J93_AC_Power_Cord.png

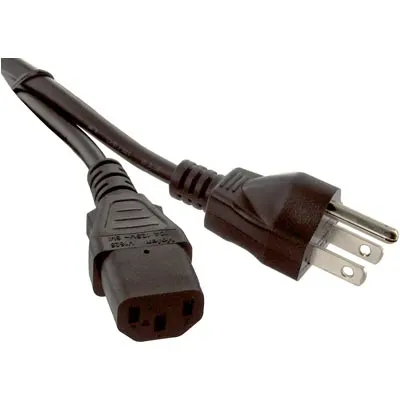
client/src/Pages/Product/AccImages/J93_AC_Power_Cord.png
