lizlarkin/highland/client/src/Pages/Product/AccImages/J94_Phoenix_Contact_Mating_Connector.png

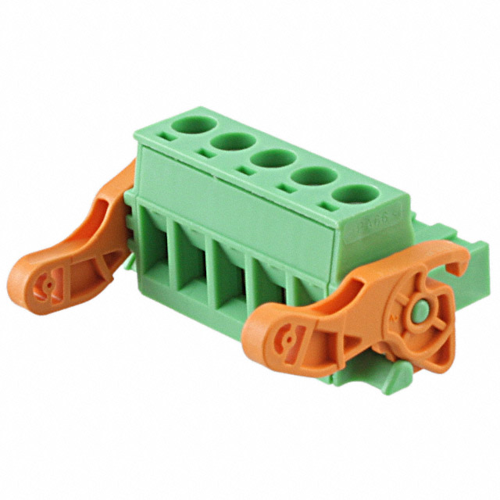
client/src/Pages/Product/AccImages/J94_Phoenix_Contact_Mating_Connector.png
