lizlarkin/highland/client/src/Pages/Product/AccImages/J95_3U_Rack_Slides.png

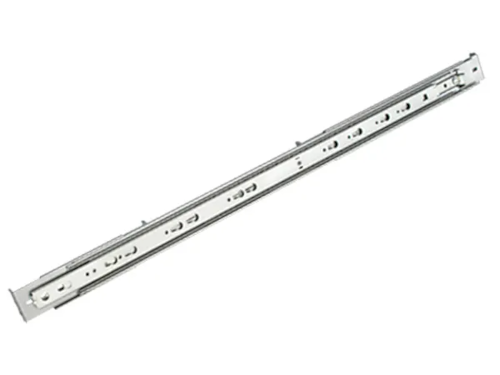
client/src/Pages/Product/AccImages/J95_3U_Rack_Slides.png
