lizlarkin/highland/client/src/Pages/Product/AccImages/J96_P945_Ribbon_Cable.png

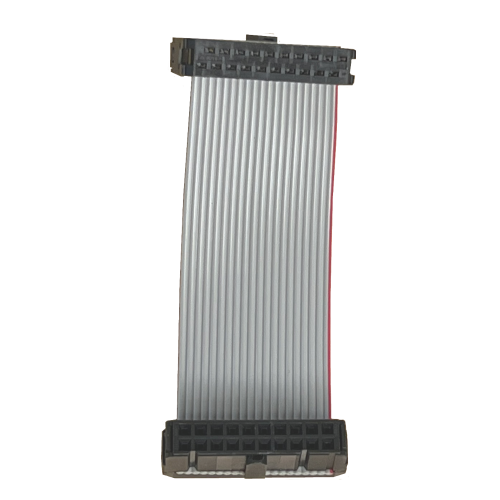
client/src/Pages/Product/AccImages/J96_P945_Ribbon_Cable.png
