lizlarkin/highland/client/src/Pages/Product/AccImages/J97_Slimline_D25_Cable.png

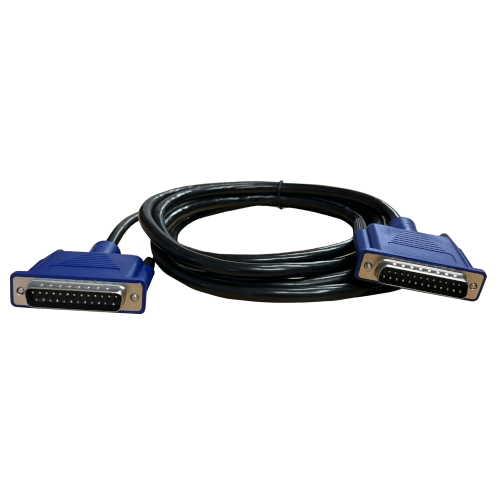
client/src/Pages/Product/AccImages/J97_Slimline_D25_Cable.png
