lizlarkin/highland/client/src/Pages/Product/AccImages/J121_PC_Cable_Driver_Board.png

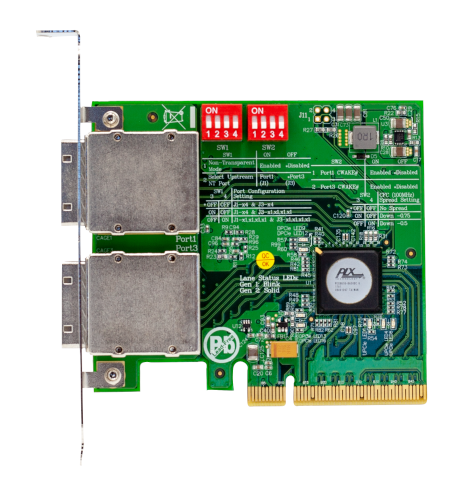
client/src/Pages/Product/AccImages/J121_PC_Cable_Driver_Board.png
