lizlarkin/highland/client/src/Pages/Product/AccImages/J192_Power_Supply.png

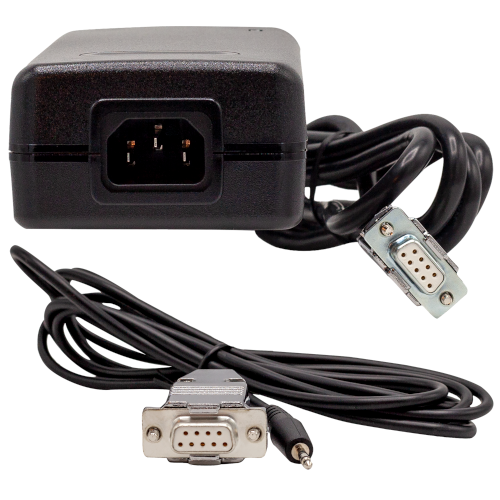
client/src/Pages/Product/AccImages/J192_Power_Supply.png
