lizlarkin/highland/client/src/Pages/Product/AccImages/J206_6V_Power_Supply.png

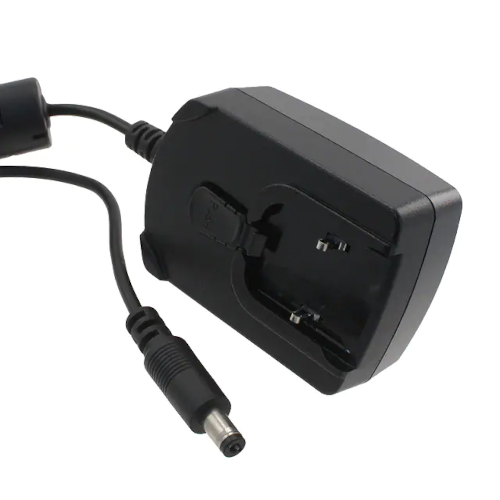
client/src/Pages/Product/AccImages/J206_6V_Power_Supply.png
