lizlarkin/highland/client/src/Pages/Product/AccImages/J280_SCSI_Breakout_Board.png

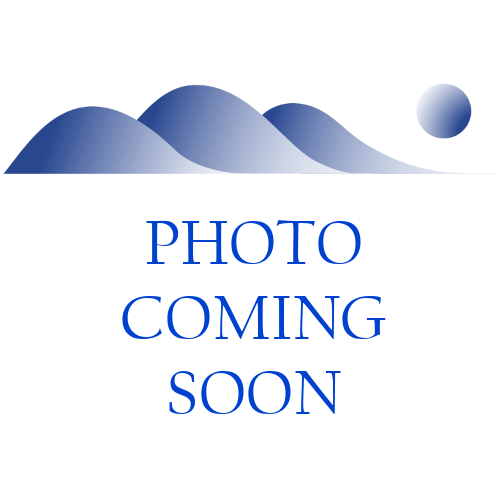
client/src/Pages/Product/AccImages/J280_SCSI_Breakout_Board.png
