lizlarkin/highland/client/src/Pages/Product/AccImages/J340_SCSI_BNC_Termination_Panel.png

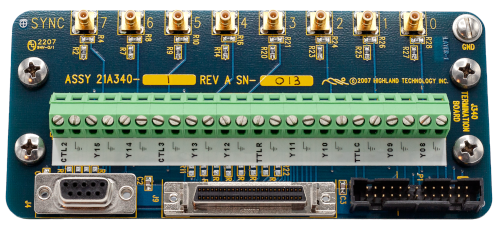
client/src/Pages/Product/AccImages/J340_SCSI_BNC_Termination_Panel.png
