lizlarkin/highland/client/src/Pages/Product/AccImages/J346_SMB_Trigger_Bus_Cable.png

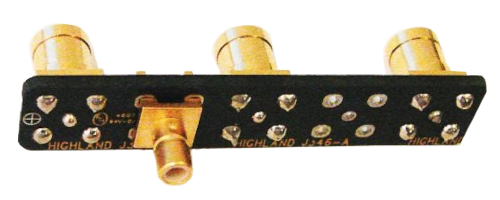
client/src/Pages/Product/AccImages/J346_SMB_Trigger_Bus_Cable.png
