lizlarkin/highland/client/src/Pages/Product/AccImages/J350_15V_Power_Supply.png

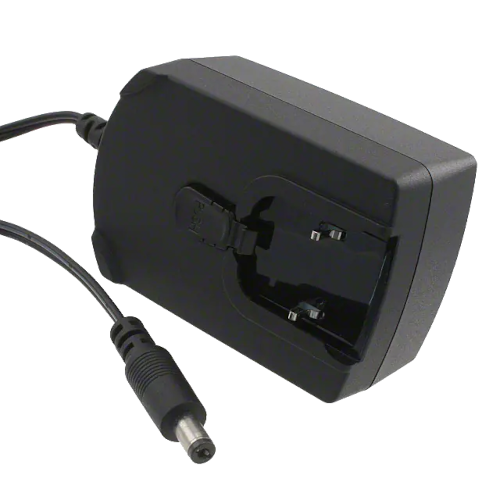
client/src/Pages/Product/AccImages/J350_15V_Power_Supply.png
