lizlarkin/highland/client/src/Pages/Product/AccImages/J470_DB25F_Isothermal_Termination_Box.png

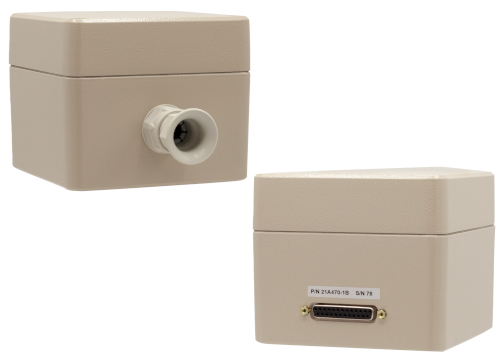
client/src/Pages/Product/AccImages/J470_DB25F_Isothermal_Termination_Box.png
