lizlarkin/highland/client/src/Pages/Product/AccImages/J475_DB25F_Din_Rail_Termination_Panel.png

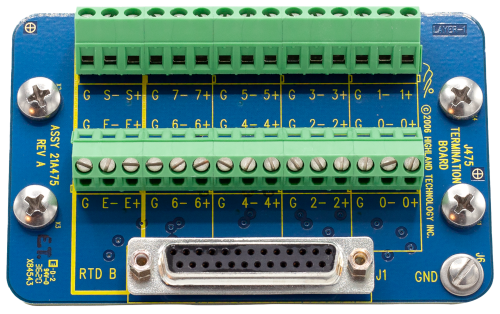
client/src/Pages/Product/AccImages/J475_DB25F_Din_Rail_Termination_Panel.png
