lizlarkin/highland/client/src/Pages/Product/AccImages/J732_Mounting_Flange.png

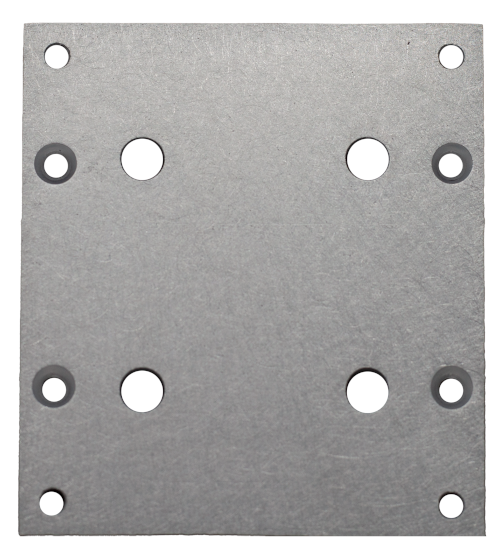
client/src/Pages/Product/AccImages/J732_Mounting_Flange.png
