lizlarkin/highland/client/src/Pages/Product/AccImages/P10_Rack_Mount_Shelf.png

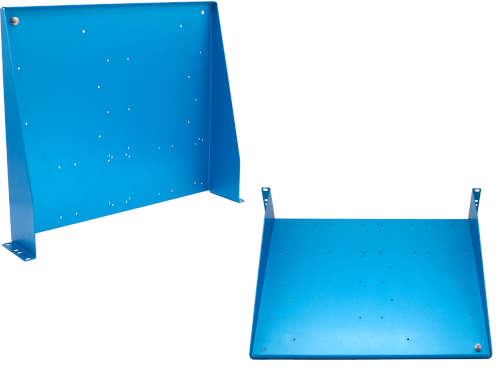
client/src/Pages/Product/AccImages/P10_Rack_Mount_Shelf.png
