lizlarkin/highland/client/src/Pages/Product/AccImages/P51_Mounting_Flange.png

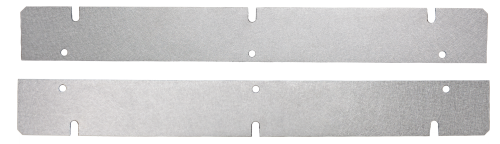
client/src/Pages/Product/AccImages/P51_Mounting_Flange.png
