lizlarkin/highland/client/src/Pages/Product/AccImages/P426_P400_Rack_Mount.png

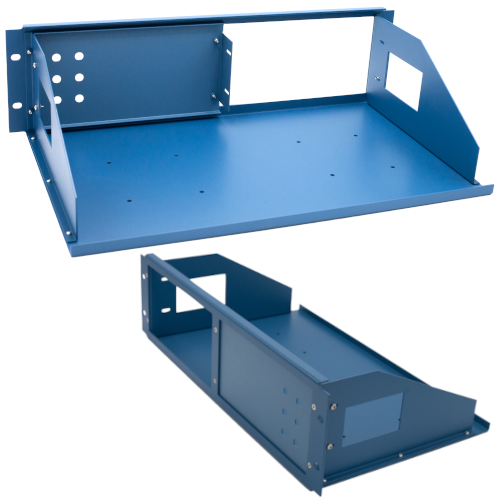
client/src/Pages/Product/AccImages/P426_P400_Rack_Mount.png
