lizlarkin/highland/client/src/Pages/Product/AccImages/P431_P400_External_Ethernet_Communication.png

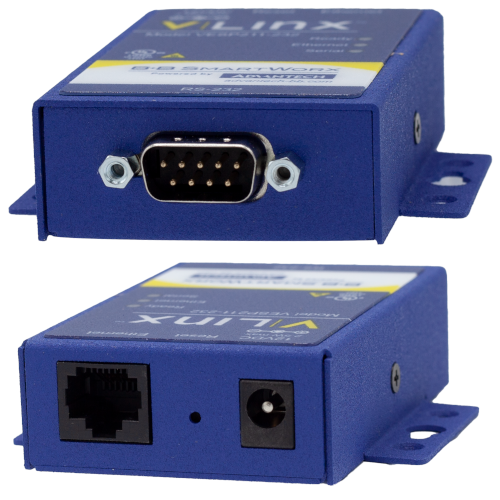
client/src/Pages/Product/AccImages/P431_P400_External_Ethernet_Communication.png
