lizlarkin/highland/client/src/Pages/Product/AccImages/P450_P400_HV_Outputs.png

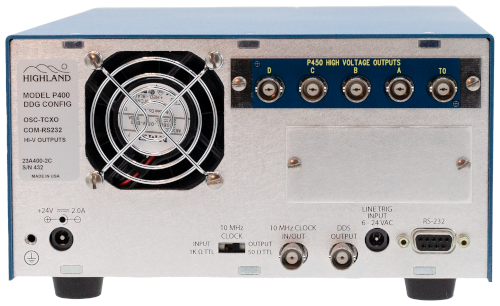
client/src/Pages/Product/AccImages/P450_P400_HV_Outputs.png
