lizlarkin/highland/client/src/Pages/Product/AccImages/P491_Power_Supply.png

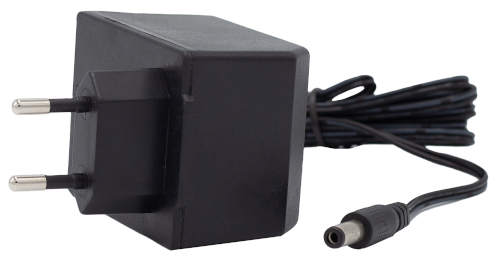
client/src/Pages/Product/AccImages/P491_Power_Supply.png
