lizlarkin/highland/client/src/Pages/Product/AccImages/T163_Butterfly_Mounting_Flange.png

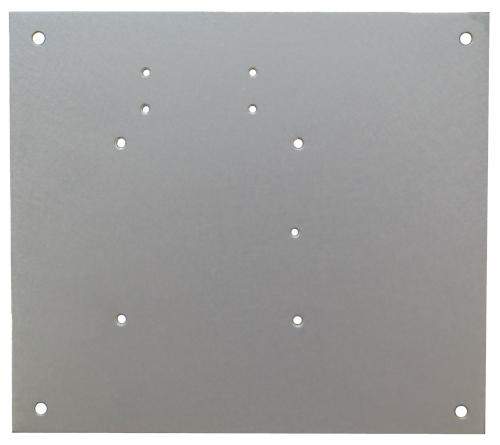
client/src/Pages/Product/AccImages/T163_Butterfly_Mounting_Flange.png
