lizlarkin/highland/client/src/Pages/Product/AccImages/T565_RS232_Cable.png

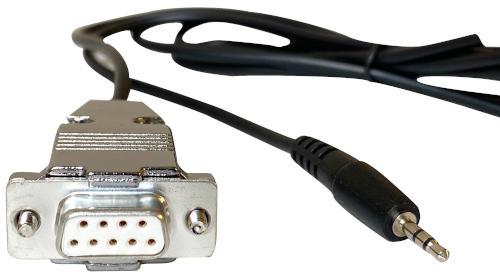
client/src/Pages/Product/AccImages/T565_RS232_Cable.png
