lizlarkin/highland/client/src/Pages/Product/AccImages/T566_Mounting_Flange.png

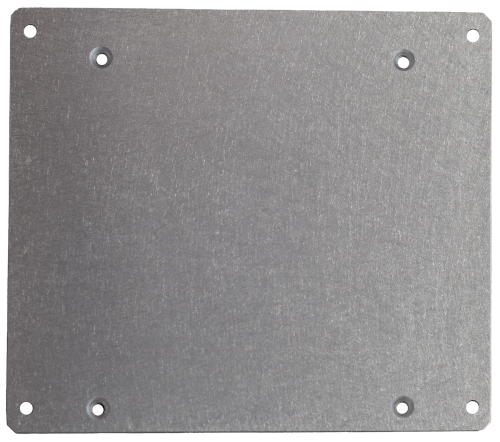
client/src/Pages/Product/AccImages/T566_Mounting_Flange.png
