lizlarkin/highland/client/src/Pages/Product/AccImages/T567_Mounting_Flange.png

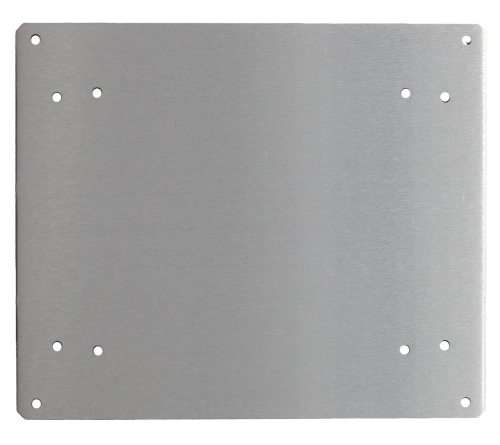
client/src/Pages/Product/AccImages/T567_Mounting_Flange.png
