lizlarkin/highland/client/src/Pages/Product/AccImages/V232_SCSI_DIN_Adapter.png

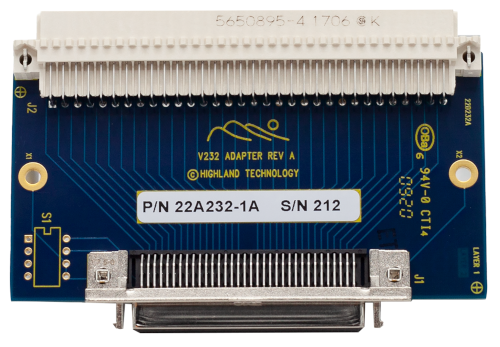
client/src/Pages/Product/AccImages/V232_SCSI_DIN_Adapter.png
