lizlarkin/highland/client/src/Pages/Product/AccImages/V233_SCSI_Termination_Panel.png

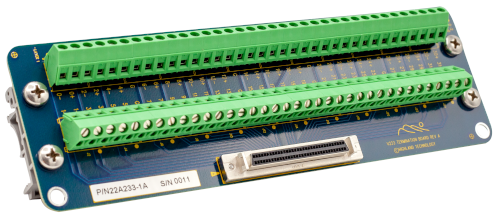
client/src/Pages/Product/AccImages/V233_SCSI_Termination_Panel.png
