lizlarkin/highland/client/src/Pages/Product/AccImages/V451_Bessel_Filter.png

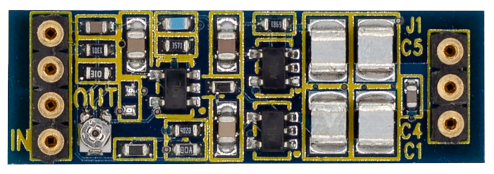
client/src/Pages/Product/AccImages/V451_Bessel_Filter.png
