lizlarkin/highland/client/src/Pages/Product/AccImages/V548_Small_Signal_Transformer.png

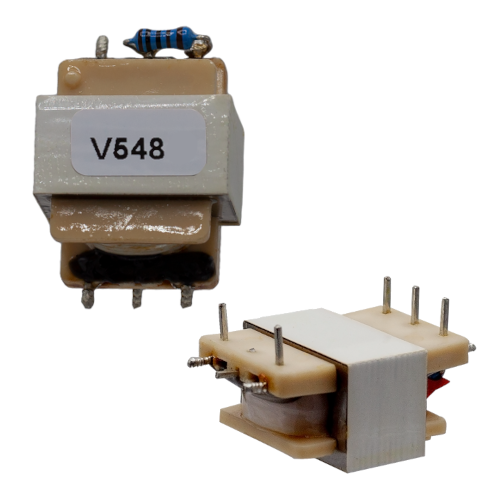
client/src/Pages/Product/AccImages/V548_Small_Signal_Transformer.png
