lizlarkin/highland/client/src/Pages/Product/AccImages/V780_Termination_Panel.jpg

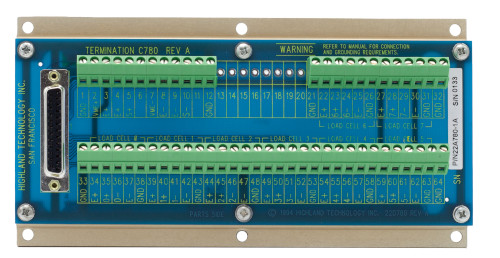
client/src/Pages/Product/AccImages/V780_Termination_Panel.jpg
