lizlarkin/highland/client/src/Components/ProductResources/assets/J724_SOV.pdf

## Statement of Volatility

The J724 single‐channel compact buffered electrical‐to‐fiberoptic converter is an analog‐based design that is comprised of discrete components. It doesn't contain any volatile or non‐volatile memory elements, programmable‐logic devices, or microprocessors.
