lizlarkin/highland/client/src/Components/ProductResources/assets/J730_SOV.pdf

## Statement of Volatility

The J730 single‐channel compact fiberoptic‐to‐electrical converter is an analog‐based design that is comprised of discrete components. It doesn't contain any volatile or non‐volatile memory elements, programmable‐logic devices, or microprocessors.
