lizlarkin/highland/client/src/Components/ProductResources/assets/P330_SOV.pdf

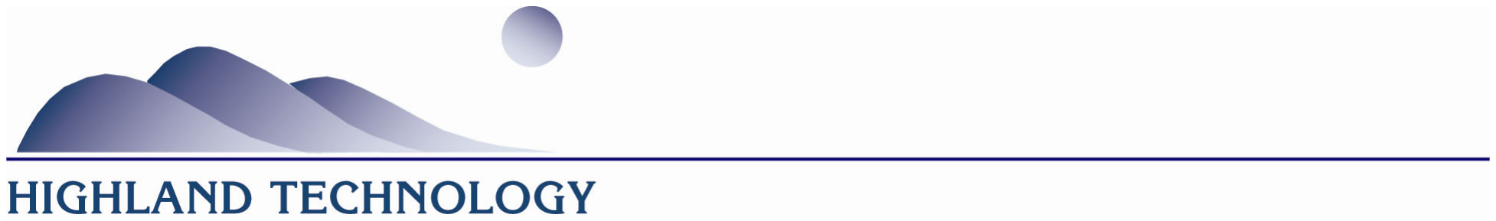
[picture p112: figure]

## Statement of Volatility

The following comprises the volatile and non‐volatile memories on the P330 Capacitive Level Sensor Simulator

Volatile

SRAM | 256 kB | Processor memory

Non‐Volatile

NOR Flash | 2 MB | Firmware. Field‐writable.
NOR Flash | 2 MB | Factory calibration. Password protected from user access
