lizlarkin/highland/client/src/Components/ProductResources/assets/P350_SOV.pdf

## Statement of Volatility

The following comprises the volatile and non‐volatile memories on the P350 Analog Signal Processor.

Volatile

DRAM | 1 GB | Processor memory
SRAM | 256 kB | Processor memory

Non-Volatile

NOR Flash | 16 MB | Unused, not accessible
NAND Flash | 32 GB (Micro‐SD) | Firmware, calibration, user data Removable if instrument cover is opened
