lizlarkin/highland/client/src/Components/ProductResources/assets/P940_CoC.pdf

## Certificate of Conformity

HIGHLAND TECHNOLOGY
650 Potrero Ave, San Francisco, CA 94110 phone: 415 551‐1700 fax: 415 551‐5129 www.highlandtechnology.com

Product Model: P940
Product Part Number: 23A940
Product Description: Modular Power System

This declaration of conformity is issued for the product listed herein, under the sole responsibility of Highland Technology, to certify that:

- Product design and specification are performed under the rigid quality requirements of Highland’s engineering standards.
- Direct, indirect, and associated processing materials and services are approved
for quality, ethical, and performance expectations.
- Product formulation, manufacturing, testing, and inspection are verified as acceptable by Quality Control prior to shipment, in conformance with the requirements of Highland’s Quality System Manual.

The product mentioned herein is certified to meet or exceed all general performance specifications stated in the current published product manual.
