lizlarkin/highland/client/src/Components/ProductResources/assets/P941_B_BD.pdf

23S941B.sch-1 - Mon Feb 05 14:50:28 2024

S.Y./L.L.

M.G. | 4/3/2023
| 6/23/2023

APPROVED

RELEASED

CHECKED

ENGINEER DATE

DRAWN

SHEET:

DRAWING NO: | REV:
1 | FILE: OF 14

HIGHLAND TECHNOLOGY INC.

CONFIDENTIAL PROPRIETARY INFORMATION COPYRIGHT HIGHLAND TECHNOLOGY ENGINEERING CHANGE ORDERS MAY APPLY

1_BLOCK_DIAGRAM

23S941B.sch

B

SCHEMATIC, P941
DUAL DC POWER SUPPLY

23S941

SHEETS

1 BLOCK DIAGRAM
2 BUS CONNECTOR
3 FPGA POWER CONFIG
4 FPGA IO NE
5 FPGA IO SW
6 BIST
7 POWER

9 ISOLATED POWER SUPPLY CH A 10 ISOLATED POWER SUPPLY CH B

13 SIGNAL PROCESSING CH A
14 SIGNAL PROCESSING CH B

11 BUCK CONVERTER CH A
12 BUCK CONVERTER CH B

## P2MOTHERBOARD CONNECTOR

PROCESSING

AND POWER

INVERTER | BUCK CONVERTER
SIGNAL ISOLATION | SIGNAL PROCESSING

CONNECTOR CH.A

CH.A

CHANNEL A

CH.A

CH.A | CH.A

8 CH A CH B DIGITAL CONTROL

> | >

>

>

< | < <
<

>

INVERTER | BUCK CONVERTER
SIGNAL ISOLATION | SIGNAL PROCESSING

CONNECTOR CH.B

CH.B

CHANNEL B

CH.B

CH.B | CH.B
> | >

>

>

<
<

<

^ | >

THIS SCHEMATIC IS BASED ON TEMPLATE 99S522B
