lizlarkin/highland/client/src/Components/ProductResources/assets/P348_SOV.pdf

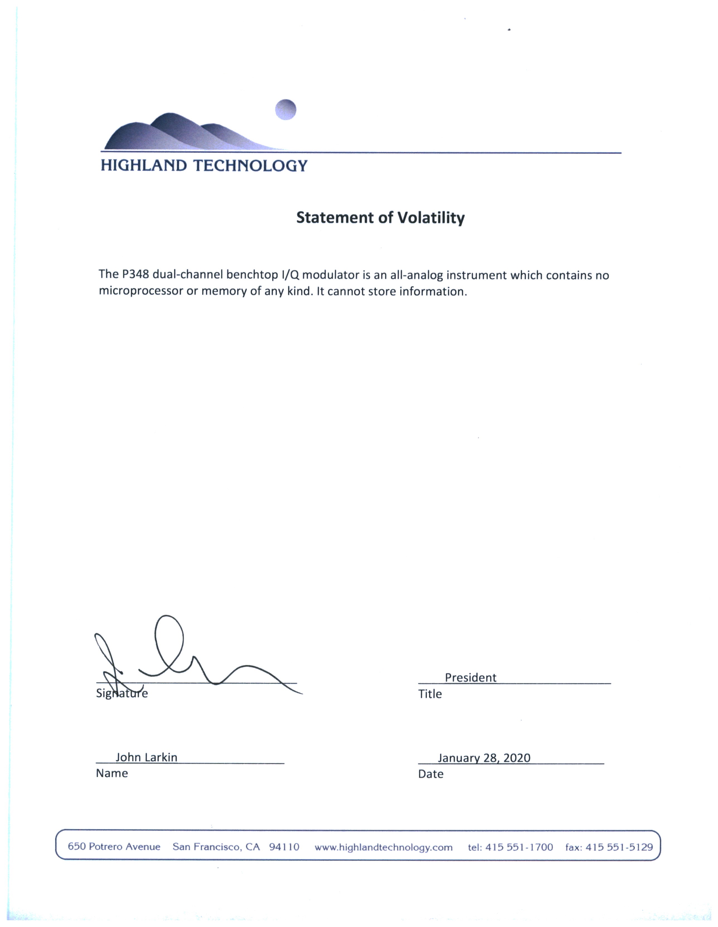
[picture p115: page 1]
