lizlarkin/highland/client/src/Components/ProductResources/assets/P500_CE.pdf

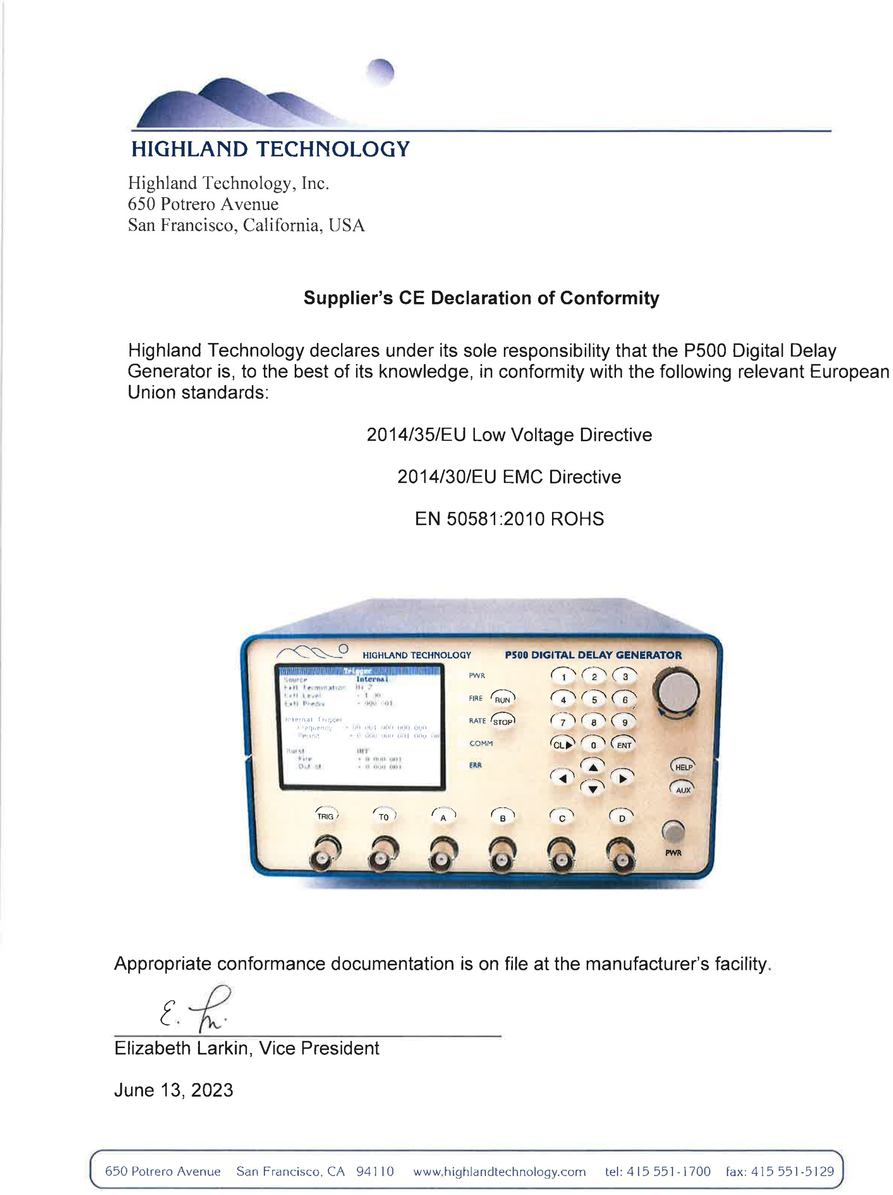
[picture p116: page 1]
