lizlarkin/highland/client/src/Components/ProductResources/assets/P545_CE.pdf

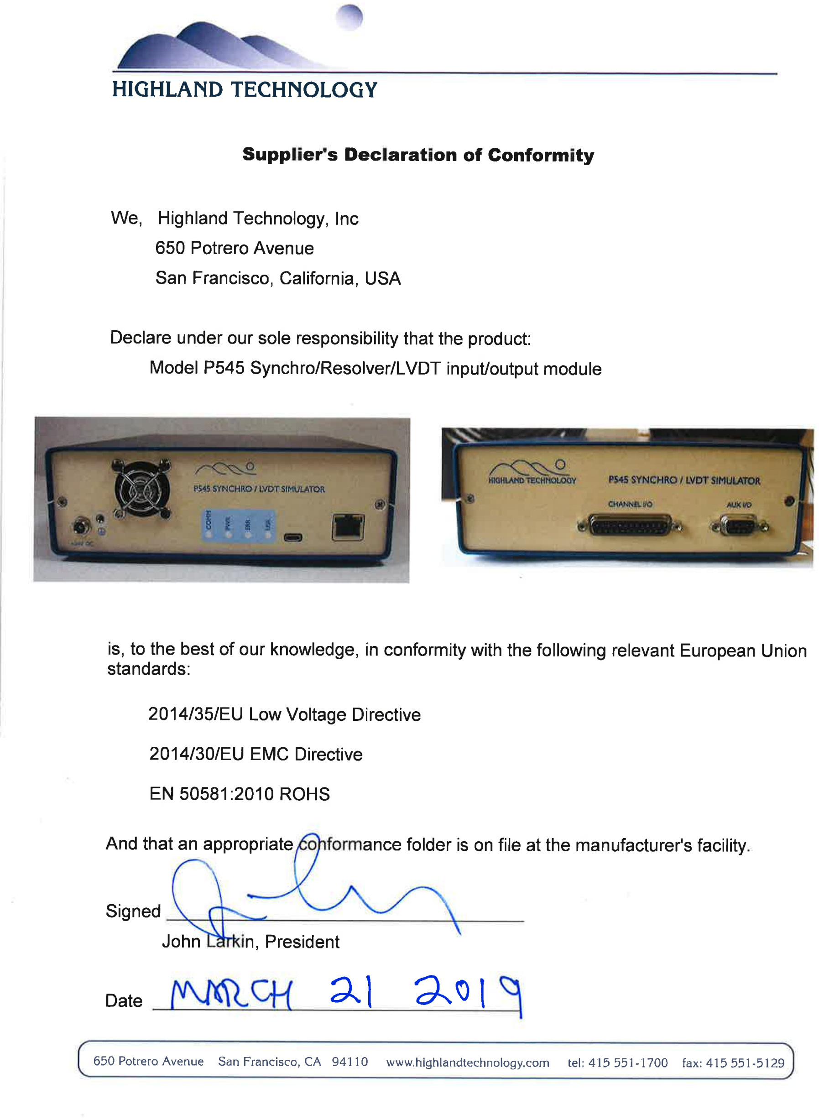
[picture p117: page 1]
