lizlarkin/highland/client/src/Components/CategoryJumbotron/img/All_Products.png

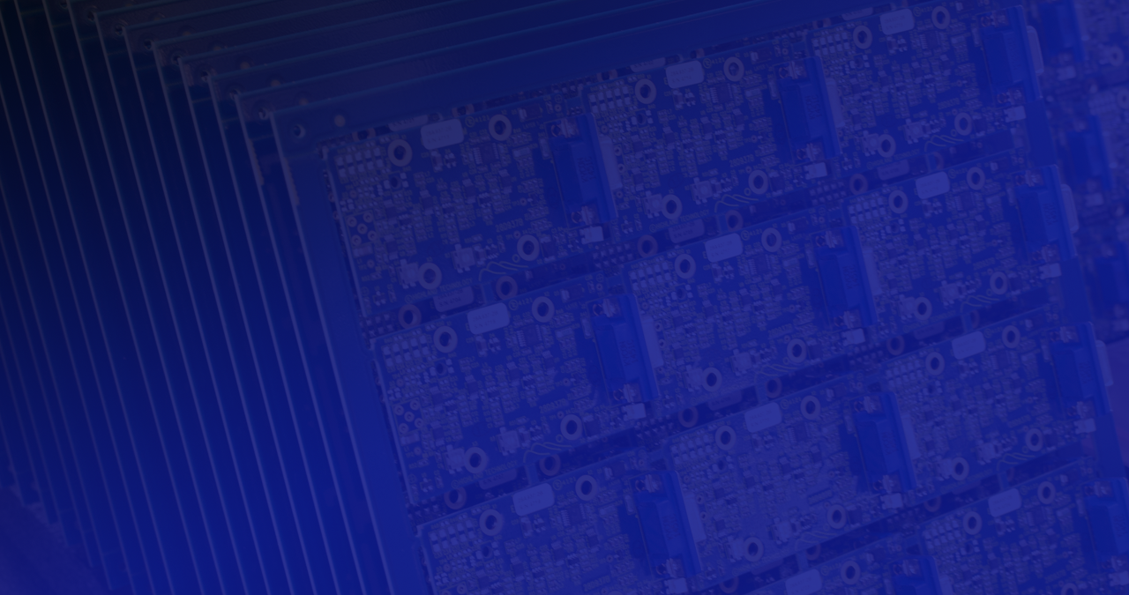
client/src/Components/CategoryJumbotron/img/All_Products.png
