lizlarkin/highland/client/src/Components/CategoryJumbotron/img/Digital_Delay_Generators.png

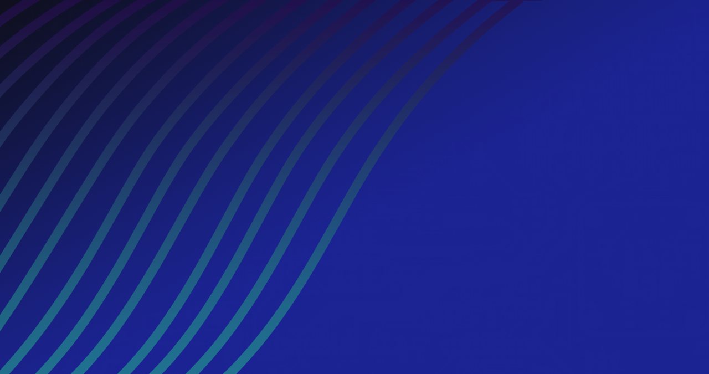
client/src/Components/CategoryJumbotron/img/Digital_Delay_Generators.png
