lizlarkin/highland/client/src/Components/CategoryJumbotron/img/Modular_Power_System.png

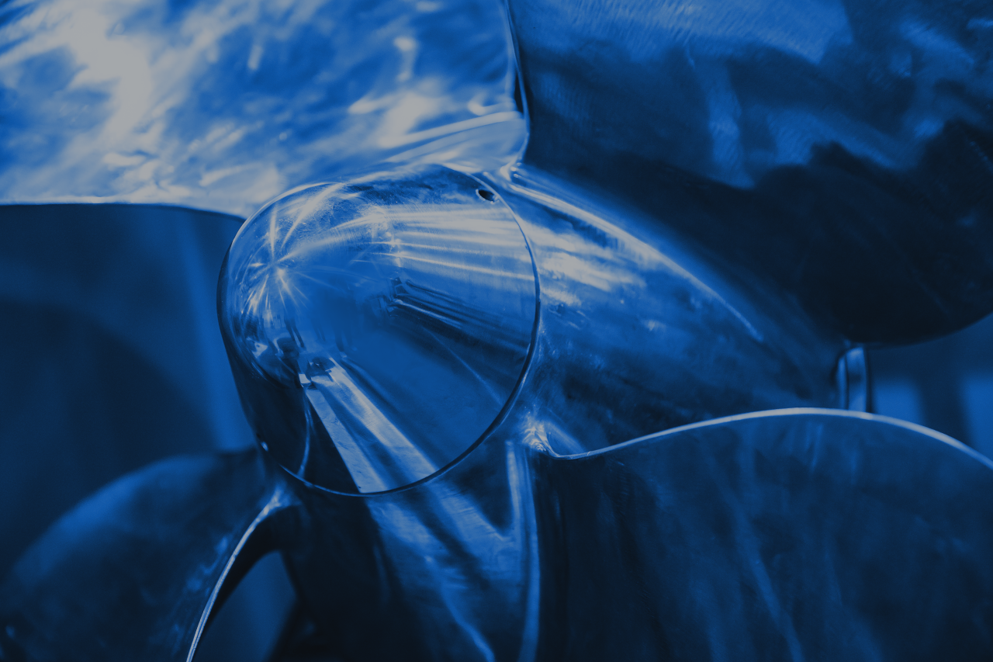
client/src/Components/CategoryJumbotron/img/Modular_Power_System.png
