lizlarkin/highland/client/src/Components/CategoryJumbotron/img/OEM.png

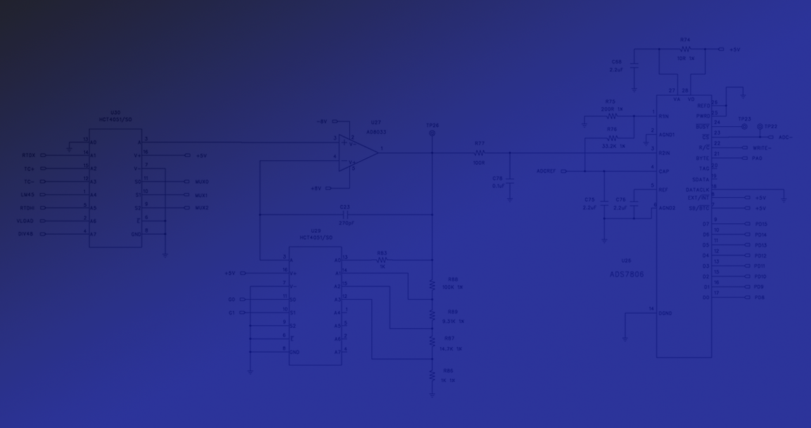
client/src/Components/CategoryJumbotron/img/OEM.png
