lizlarkin/highland/client/src/Components/CategoryJumbotron/img/Photonics.png

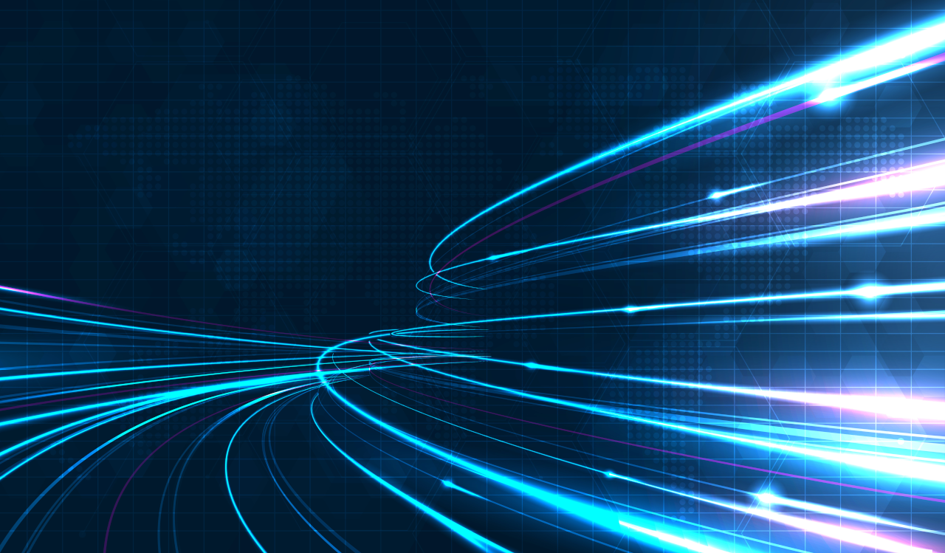
client/src/Components/CategoryJumbotron/img/Photonics.png
