lizlarkin/highland/client/src/Components/CategoryJumbotron/img/Pulse_Generators.png

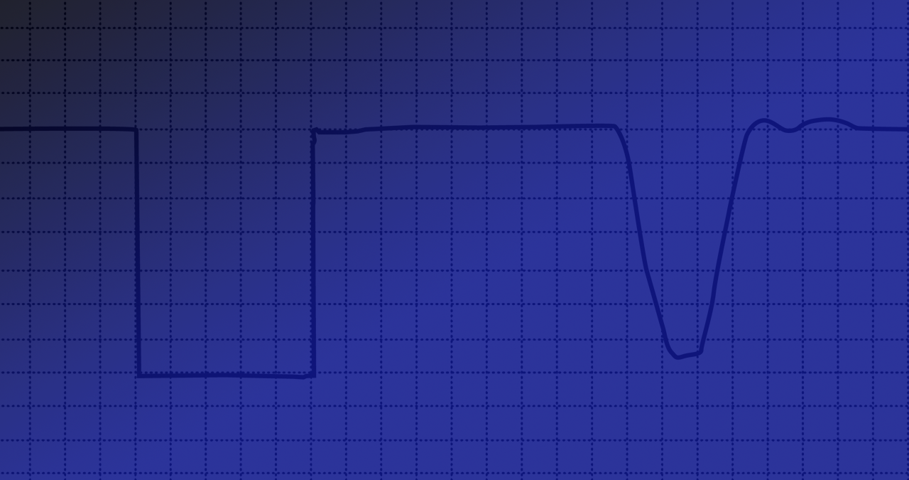
client/src/Components/CategoryJumbotron/img/Pulse_Generators.png
