lizlarkin/highland/client/src/Components/CategoryJumbotron/img/VME.png

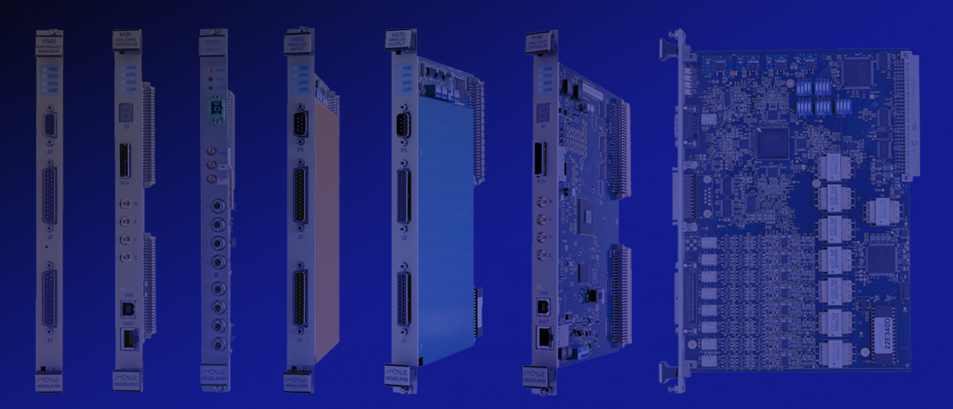
client/src/Components/CategoryJumbotron/img/VME.png
