lizlarkin/highland/client/src/Components/CategoryJumbotron/img/Waveform_Generators.png

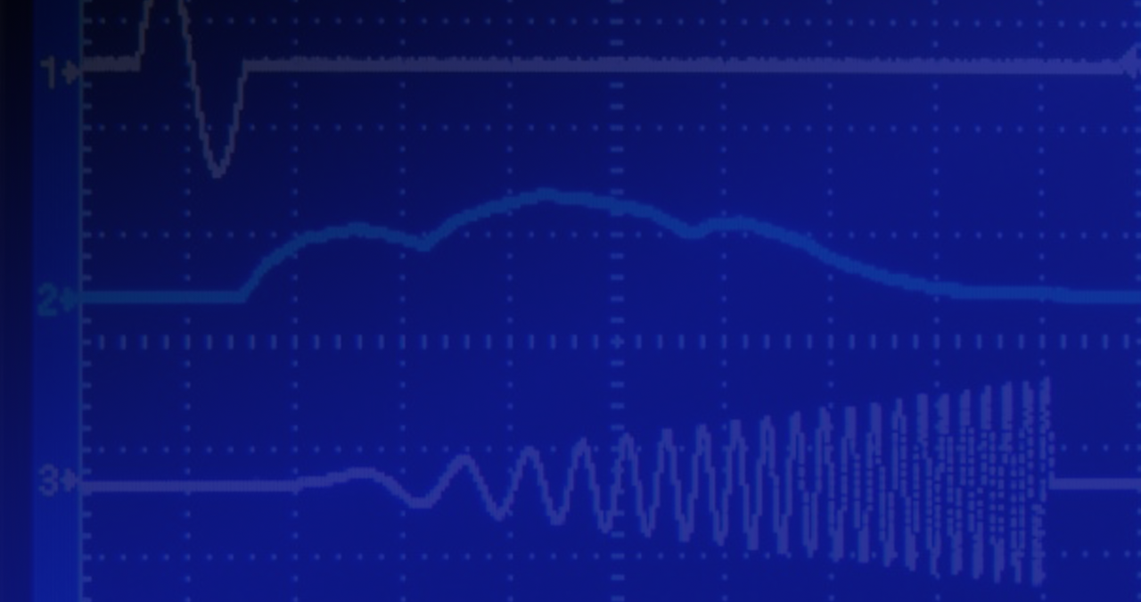
client/src/Components/CategoryJumbotron/img/Waveform_Generators.png
