lizlarkin/highland/client/src/Components/GeneralJumbotron/Images/About.jpeg

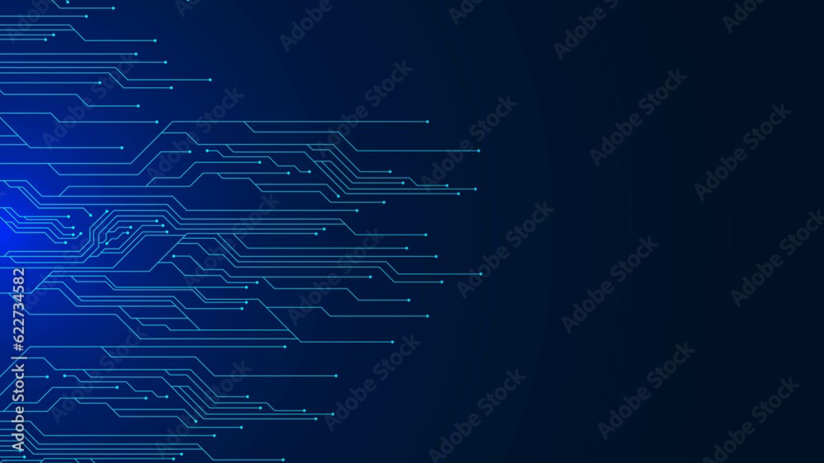
client/src/Components/GeneralJumbotron/Images/About.jpeg
