lizlarkin/highland/client/src/Components/GeneralJumbotron/Images/Account.png

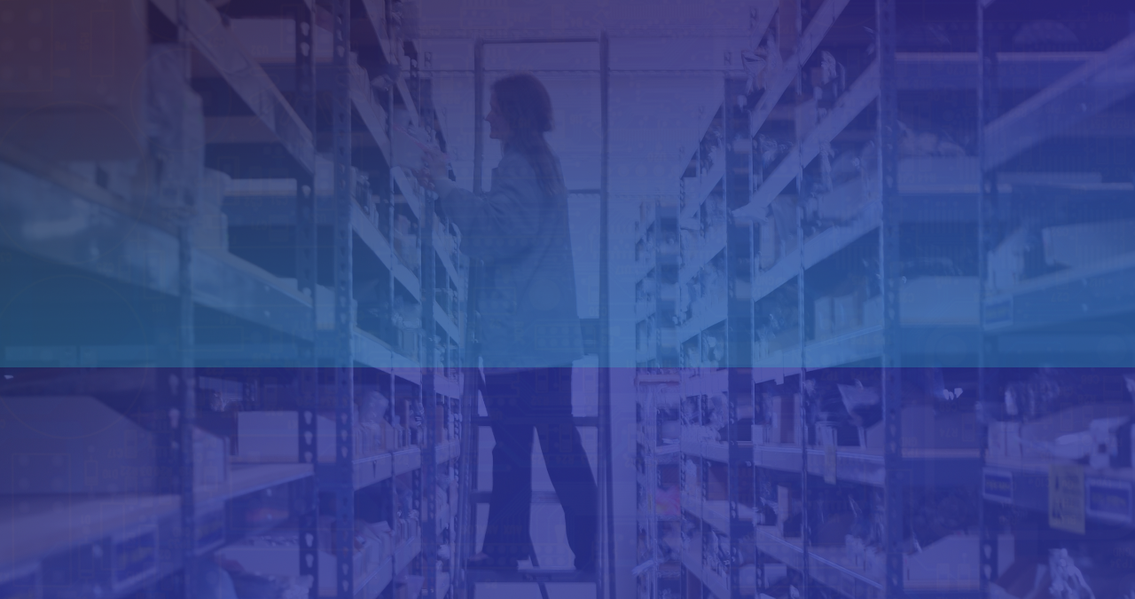
client/src/Components/GeneralJumbotron/Images/Account.png
