lizlarkin/highland/client/src/Components/GeneralJumbotron/Images/Careers.png

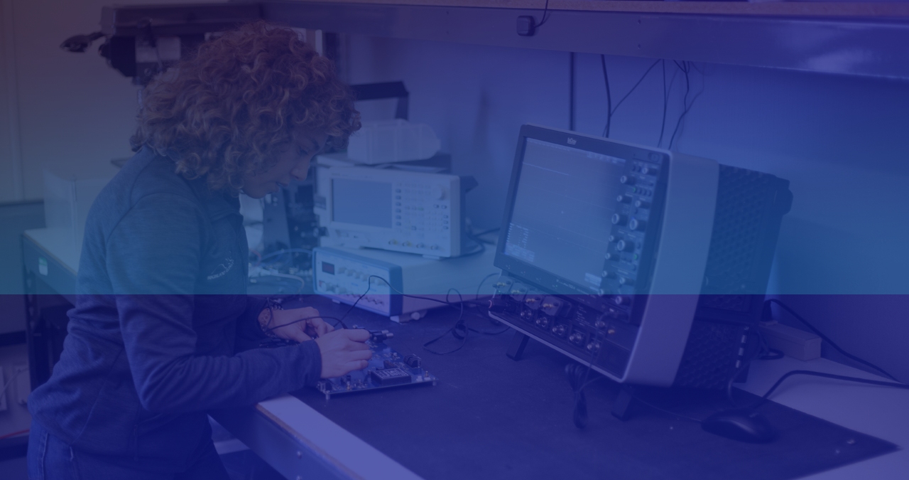
client/src/Components/GeneralJumbotron/Images/Careers.png
