lizlarkin/highland/client/src/Components/GeneralJumbotron/Images/Cart.png

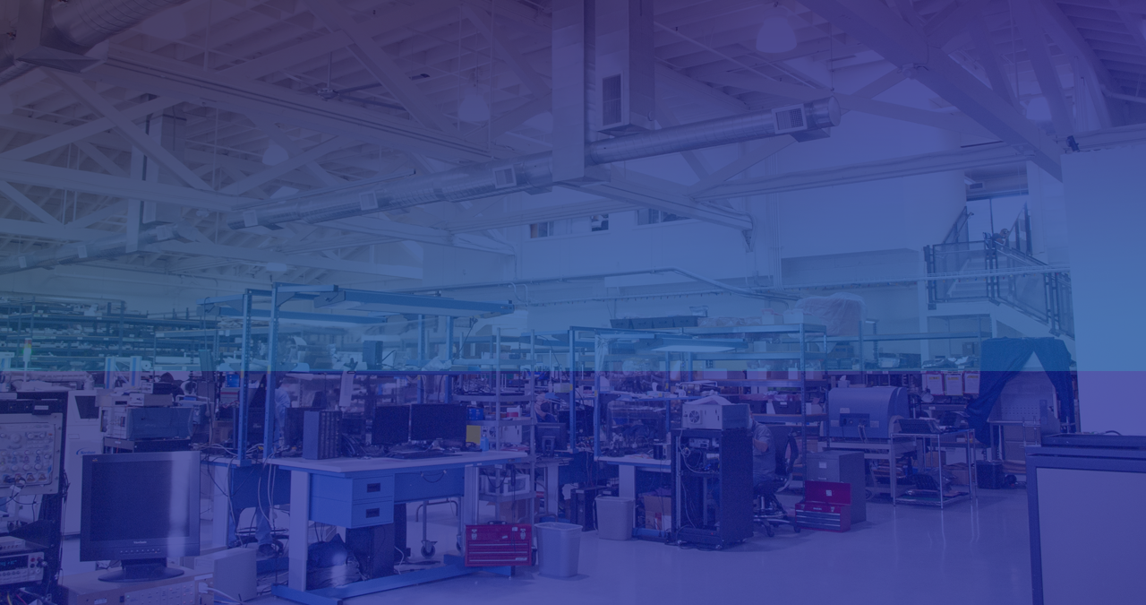
client/src/Components/GeneralJumbotron/Images/Cart.png
