lizlarkin/highland/client/src/Components/GeneralJumbotron/Images/Contact.jpg

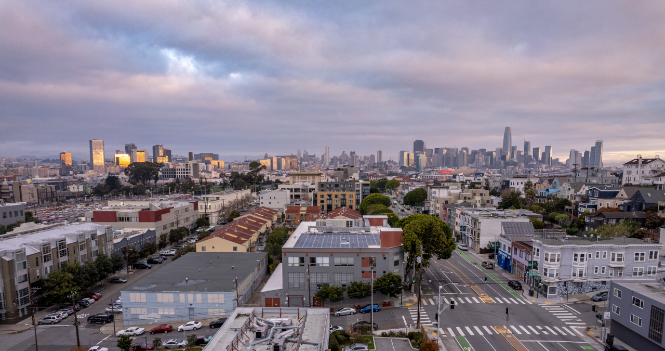
client/src/Components/GeneralJumbotron/Images/Contact.jpg
