lizlarkin/highland/client/src/Components/GeneralJumbotron/Images/Customers.png

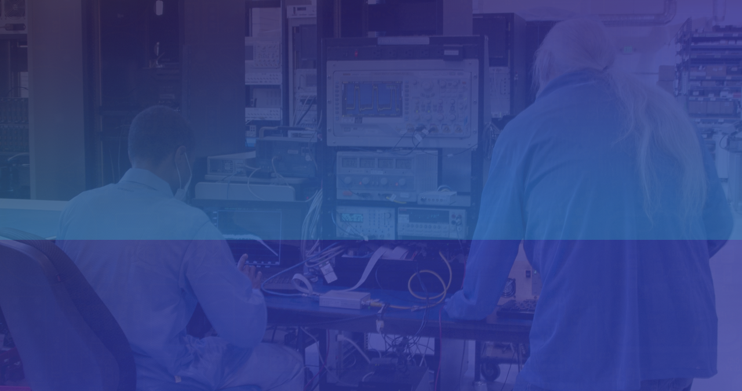
client/src/Components/GeneralJumbotron/Images/Customers.png
