lizlarkin/highland/client/src/Components/GeneralJumbotron/Images/Partners.png

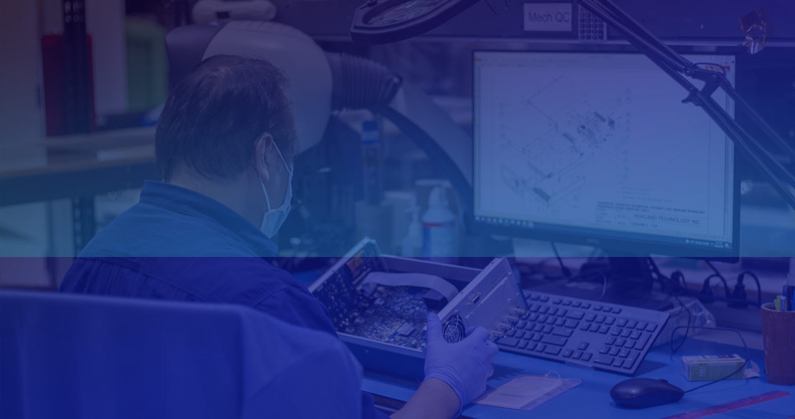
client/src/Components/GeneralJumbotron/Images/Partners.png
