lizlarkin/highland/client/src/Components/ProductResources/assets/D100_17A100C.STEP

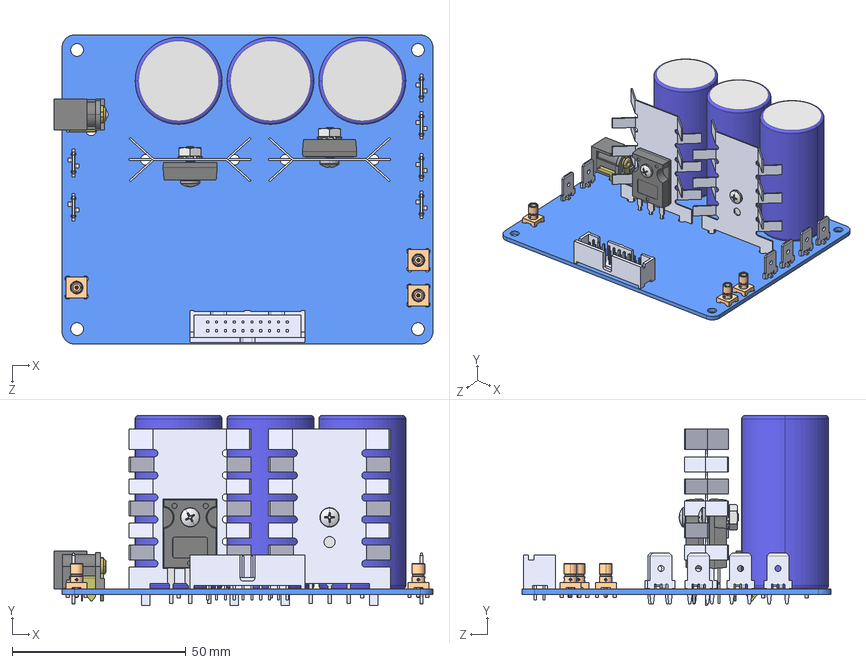
[picture p134: CAD file, 2024-02-08]
client/src/Components/ProductResources/assets/D100_17A100C.STEP
109.0 x 54.7 x 88.9 mm
17D100C
250 faston x 6
TO-220 heatsink x 2
TO-247_vertical_line x 2
91735A104_316 Stainless Steel Pan Head Phillips Screw_91735A104 x 2
4-40 HEX NUT WITH TOOTH WASHER_96278A005 x 2
SMB-vertical x 3
