lizlarkin/highland/client/src/Components/ProductResources/assets/P344_P348_P350_P730_23MXXXA_GENERIC_SMALL_.STEP

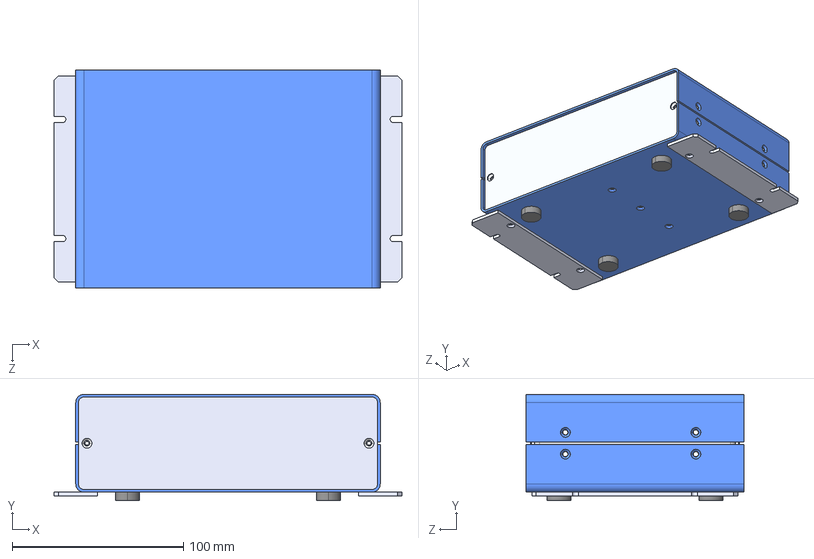
[picture p135: CAD file, 2024-02-08]
client/src/Components/ProductResources/assets/P344_P348_P350_P730_23MXXXA_GENERIC_SMALL_.STEP
203.2 x 62.1 x 127.0 mm
23m001a
23m002a
23M003A x 2
PCB2
Rubber feet x 4
23m005b x 2
Front Panel2 x 2
Overlay x 2
standoff x 5
