lizlarkin/highland/client/src/Components/ProductResources/assets/J240_J730_J750_21AXXXA_GENERIC_SILVER.STEP

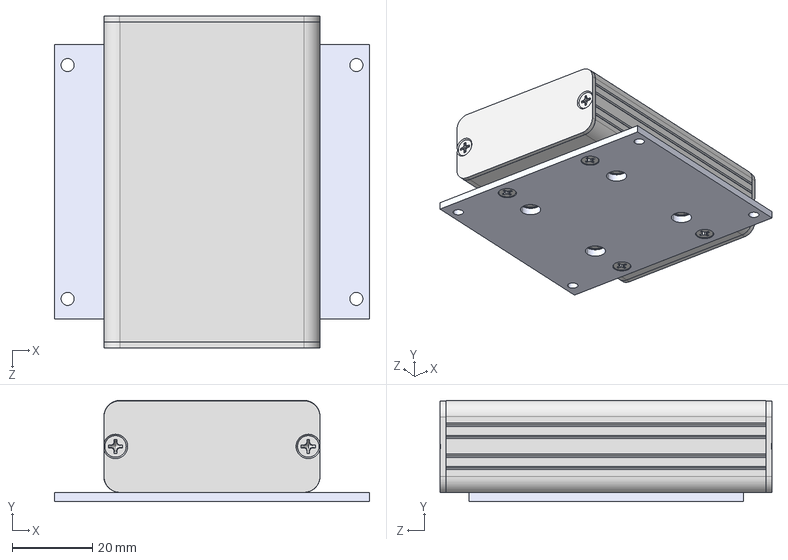
[picture p136: CAD file, 2024-02-08]
client/src/Components/ProductResources/assets/J240_J730_J750_21AXXXA_GENERIC_SILVER.STEP
78.7 x 25.3 x 82.9 mm
J730Box
Blank endplate x 2
4-40_313 Phillips Flat Head Screw_91771A107 x 4
Flange (new)
4-40 SS FLAT UNDERCUT HEAD PHIL MACHINE SCREW_91099A152 x 8
