lizlarkin/highland/client/src/Components/ProductResources/assets/J720_21M720H.STEP

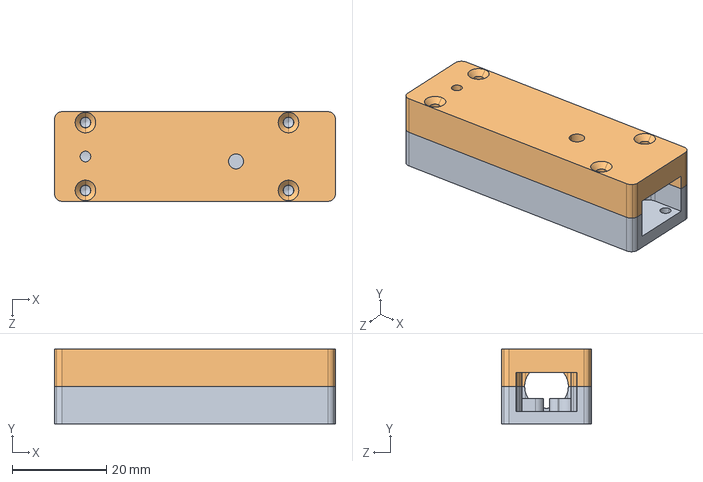
[picture p137: CAD file, 2024-02-08]
client/src/Components/ProductResources/assets/J720_21M720H.STEP
59.7 x 15.9 x 19.1 mm
Bottom.step
Top.step
