lizlarkin/highland/client/src/Components/ProductResources/assets/J724_21A724D.STEP

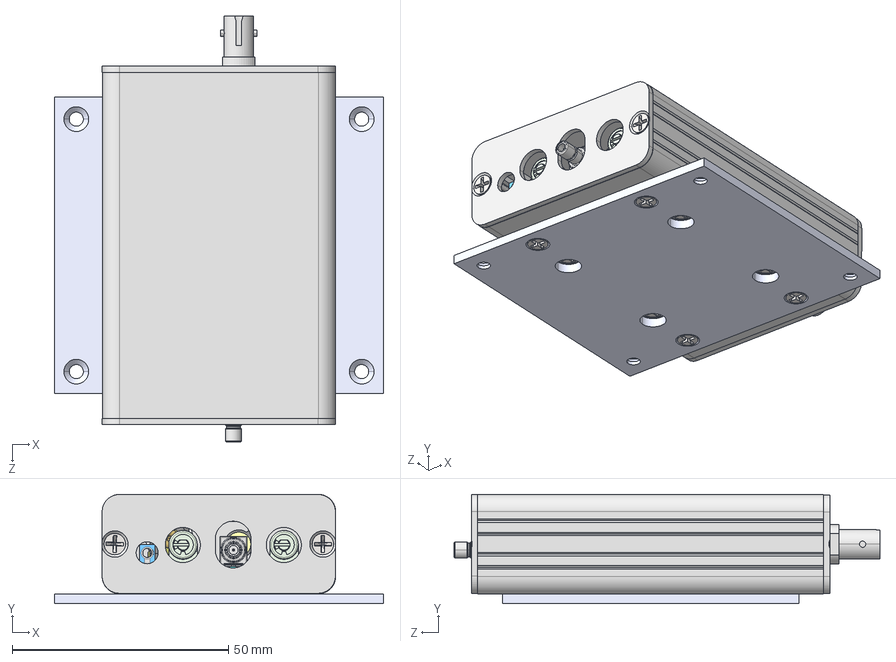
[picture p138: CAD file, 2024-02-08]
client/src/Components/ProductResources/assets/J724_21A724D.STEP
76.2 x 25.3 x 98.6 mm
J Box
21D724D
M3329_COVERFD1 x 2
flat head screw_ai_CR-FHMS 0.112-40x0.188x0.188-N x 4
21m732c
flat head screw_ai_CR-FHMS 0.112-40x0.125x0.125-N x 4
21M725D-1
21M725D-2
flat head screw_ai_CR-FHMS 0.112-40x0.3125x0.3125-N x 4
