lizlarkin/highland/client/src/Components/ProductResources/assets/T124_T240_T340_T344_T346_T750_T760_T860_28AXXXA_GENERIC_SILVER.STEP

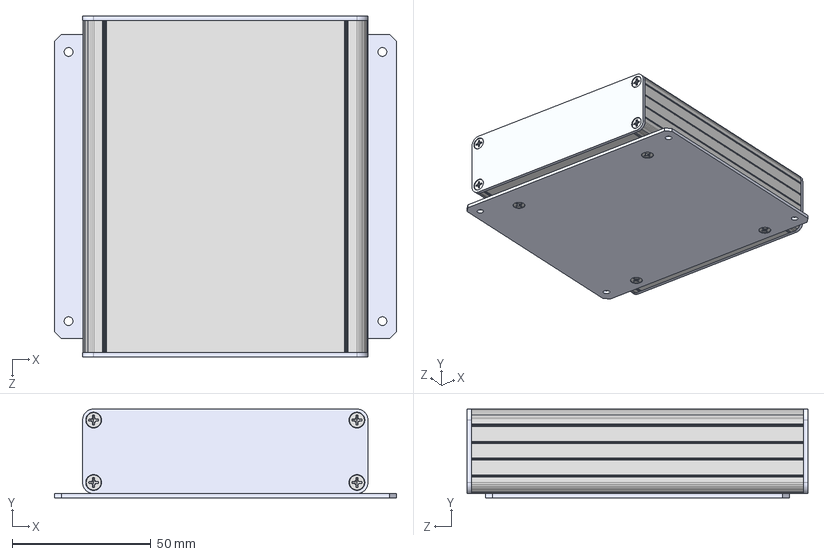
[picture p139: CAD file, 2024-02-08]
client/src/Components/ProductResources/assets/T124_T240_T340_T344_T346_T750_T760_T860_28AXXXA_GENERIC_SILVER.STEP
123.4 x 32.1 x 123.0 mm
T560 Box
Top cover
T Series Panel x 2
4-40_313 Phillips Flat Head Screw_91771A107 x 8
Flange
4-40 SS FLAT UNDERCUT HEAD PHIL MACHINE SCREW_91099A152 x 4
