lizlarkin/highland/client/src/Components/ProductResources/assets/T560_T564_28A560C.STEP

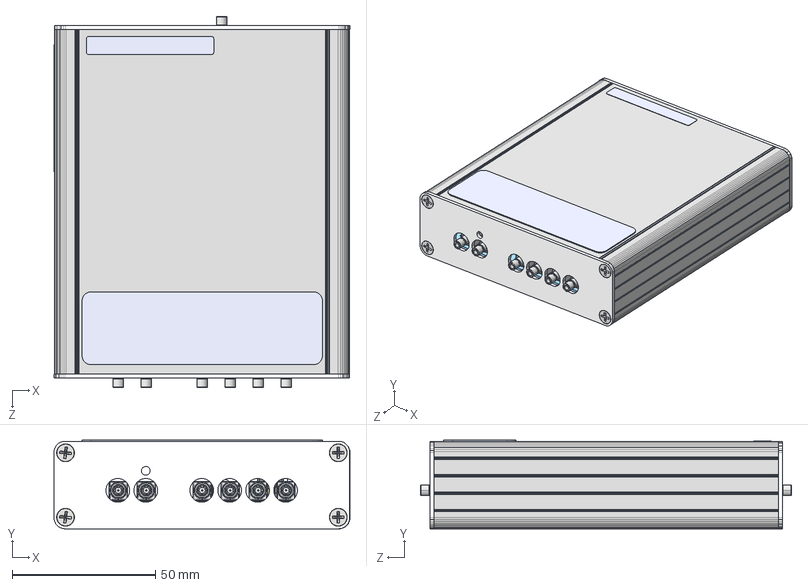
[picture p140: CAD file, 2024-02-08]
client/src/Components/ProductResources/assets/T560_T564_28A560C.STEP
103.2 x 30.9 x 129.4 mm
T560 Box
Top cover
Small label
28d562k
thru-hole standoff_pmi_PEM SOS-440-10 ---N x 4
28m562-1f
28m562-3f
flat head 100 screw_ai_CR-FHM1 0.138-32x0.375x0.375-N x 8
Serial number x 2
