lizlarkin/highland/client/src/Components/CategoryJumbotron/img/Measurement_Simulation.png

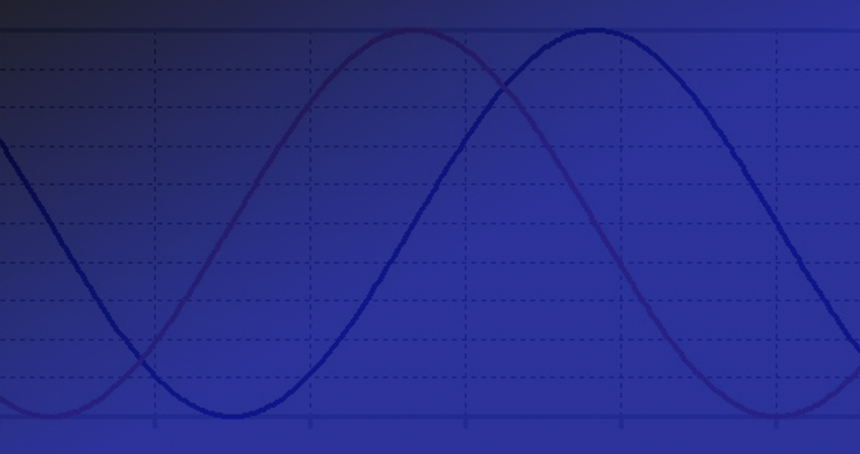
client/src/Components/CategoryJumbotron/img/Measurement_Simulation.png
