lizlarkin/highland/client/src/Components/GeneralJumbotron/Images/Testimonials.png

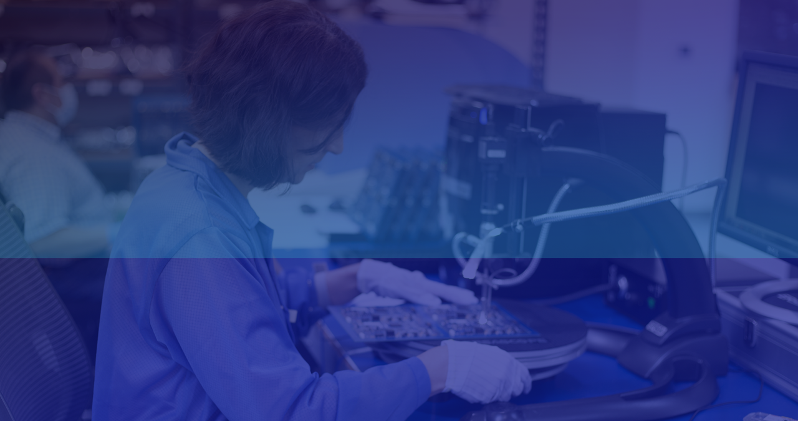
client/src/Components/GeneralJumbotron/Images/Testimonials.png
