lizlarkin/highland/client/src/Pages/Testimonials/images/Aerospace_Defense_Award.png

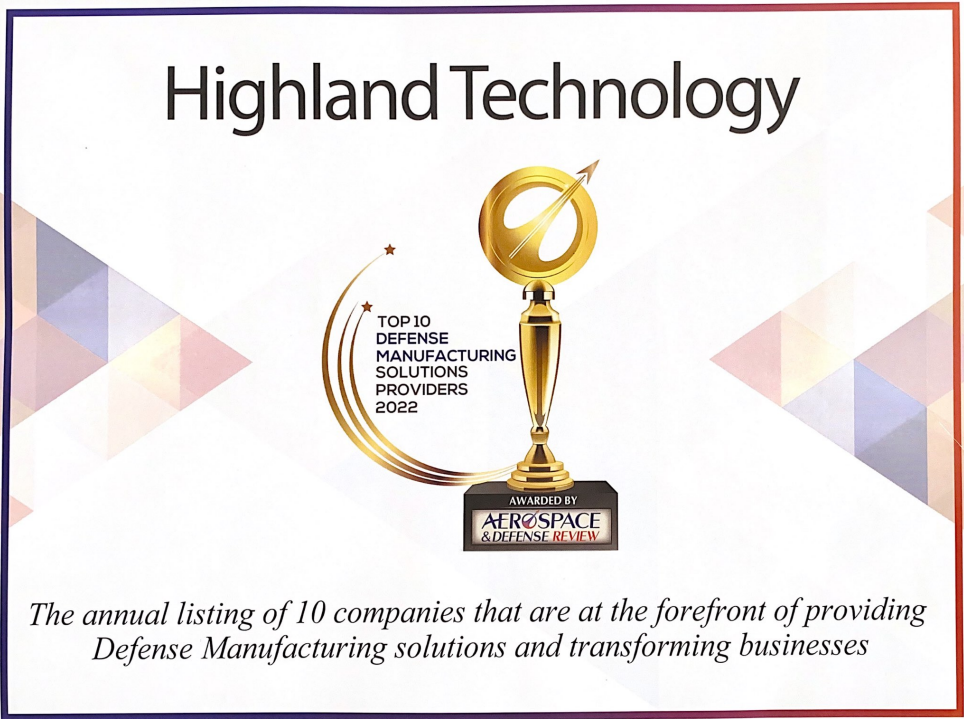
client/src/Pages/Testimonials/images/Aerospace_Defense_Award.png
