lizlarkin/highland/client/src/Pages/Testimonials/images/LLNL_Award.png

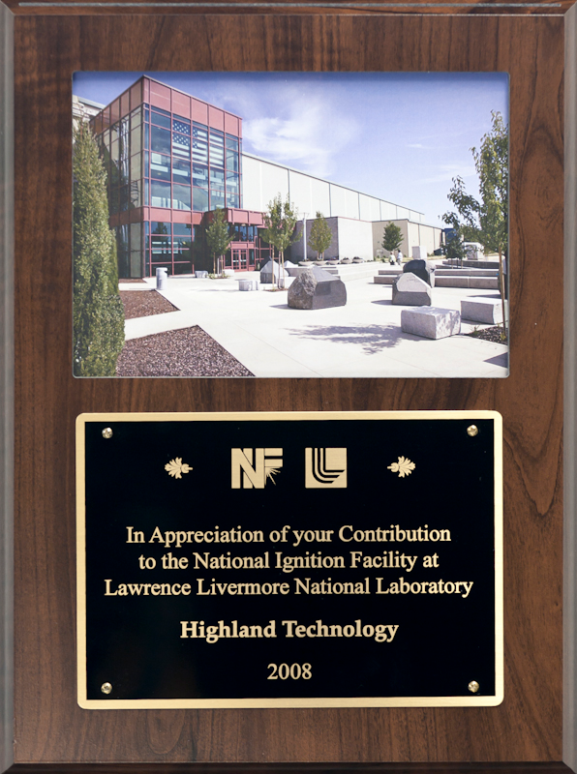
client/src/Pages/Testimonials/images/LLNL_Award.png
