lizlarkin/highland/client/src/Pages/Testimonials/images/NIF_Award.png

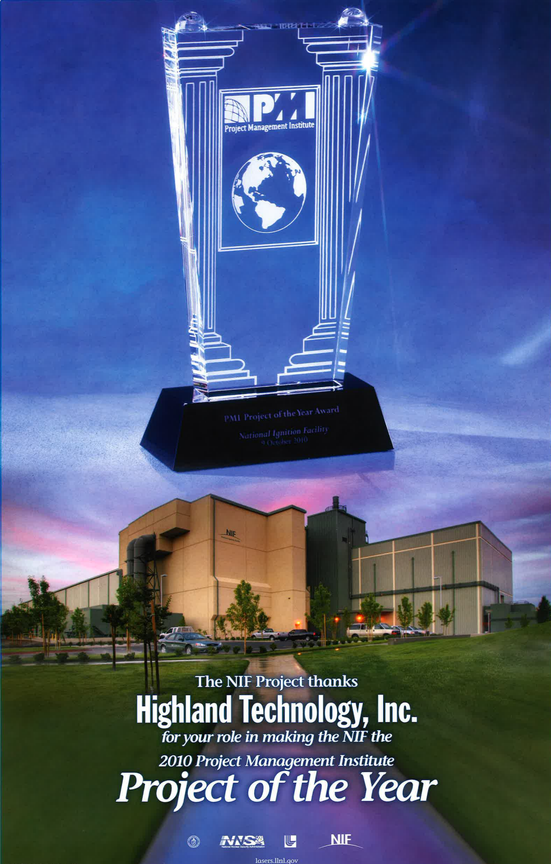
client/src/Pages/Testimonials/images/NIF_Award.png
