lizlarkin/highland/client/src/Pages/FAQ/End User Statement.pdf

*** The Ultimate Consignee needs to complete this form. The Ultimate Consignee should copy this form onto their letterhead prior to completing and return to the party requesting this form.

End User Statement

Ultimate Consignee:

Who will be using the product? Please give a detailed description. Please include full name, address and contact information.

Company Name:

Address:

Country:

Phone:

Fax:

Email:

Responsible Party:

Intermediate Consignee:

Who is purchasing the product for the Ultimate Consignee if applicable? Complete if a party is buying for the Ultimate Consignee. Please include full name, address and contact information.

Company Name:

Address:

Country:

Phone:

Fax:

Email:

Responsible Party:

** If any other parties will be involved in this project or application please list them as well.

Item(s) Purchased:

End Use Description:

What is the exact nature of the business activity and application? Example: This requirement is for high voltage capacitors. We will use the capacitors to build a high voltage pulser to drive a lightning simulation for testing aircraft against lightning strikes. Please do not simply state that this is a capacitor for a HV Pulser without specific information concerning what the End Use application is.

Customer agrees to comply with export laws of the United States and obtain any license, permit, or authorization required to transfer, sell, export, or re‐export the products purchased from Highland Technology, Inc.

For the individual authorized by the Ultimate End User to complete this form, please provide the following information:

___________________________________________ | _____________________
Signature | Title
___________________________________________ | _____________________
Company | Date
