lizlarkin/highland/client/src/Components/GeneralJumbotron/Images/FAQs.png

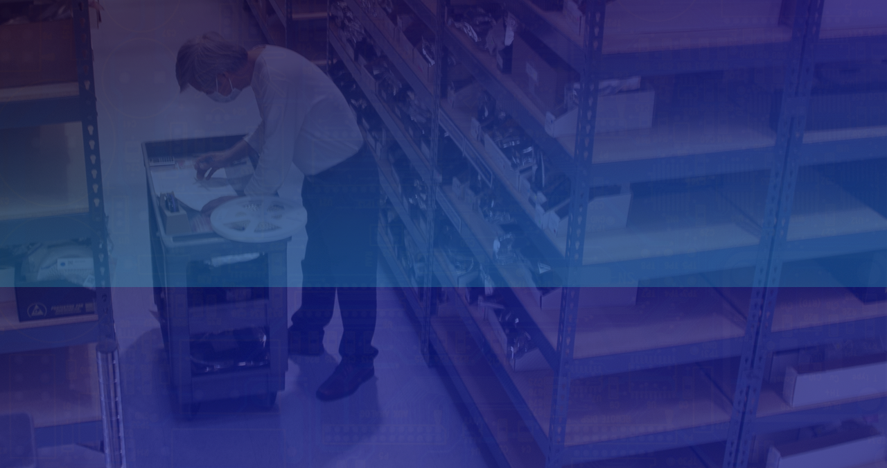
client/src/Components/GeneralJumbotron/Images/FAQs.png
