lizlarkin/highland/client/src/Components/ProductResources/assets/P330_A_BD.pdf

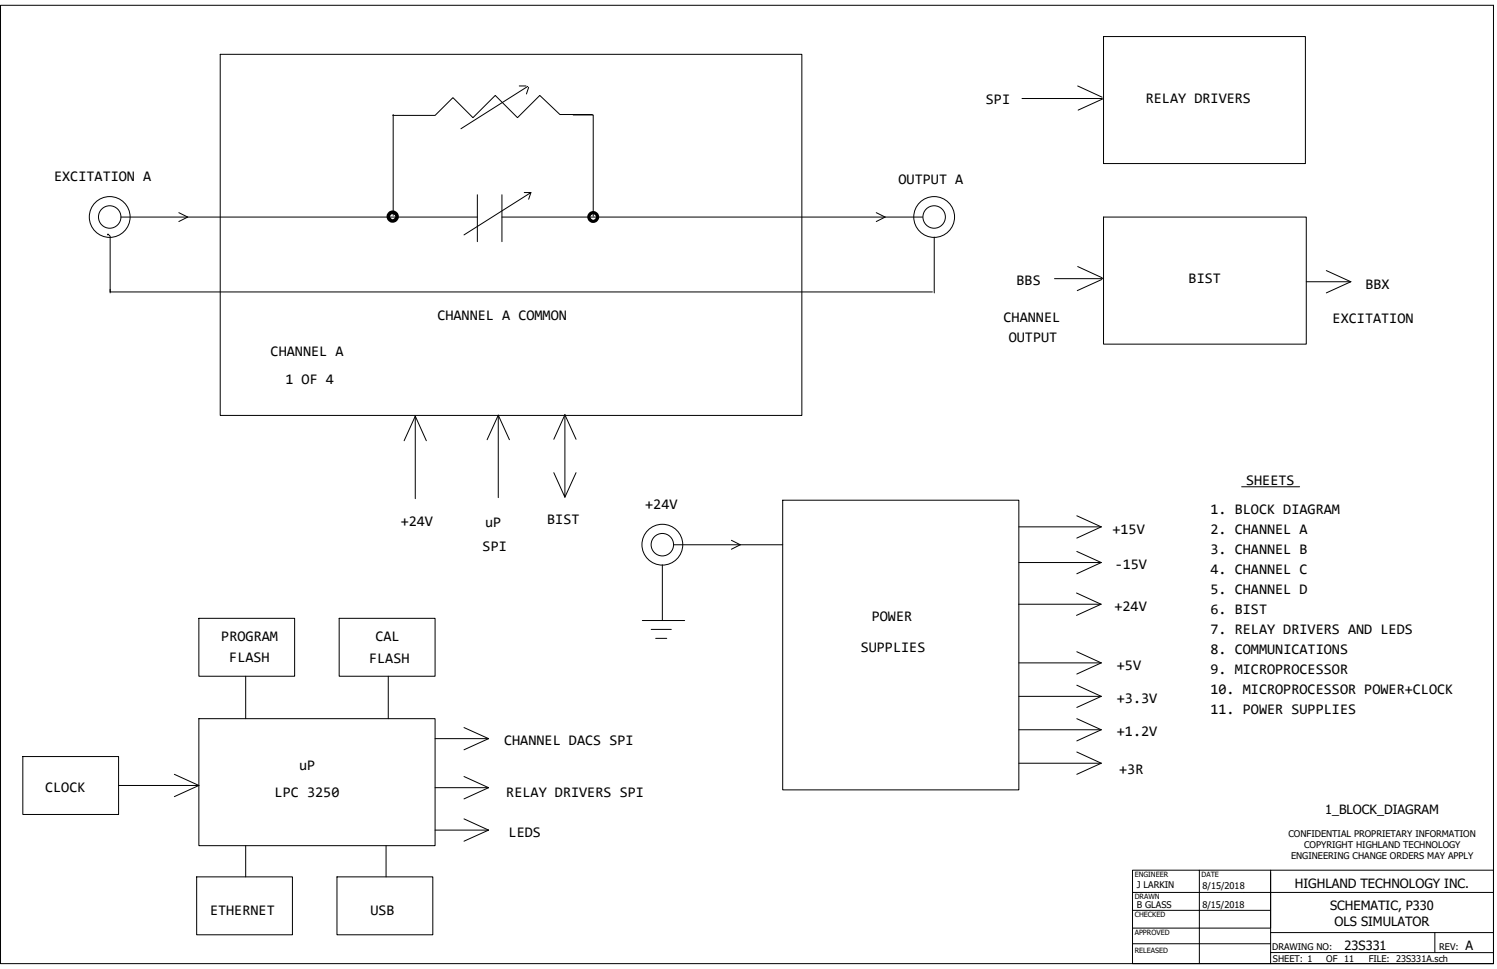
[picture p147: page 1]
OLS SIMULATOR; B GLASS; SCHEMATIC, P330; J LARKIN; CHECKED; ENGINEER; DATE; DRAWN; SHEET:; FILE: OF 11; 23S331A.sch; 1_BLOCK_DIAGRAM; EXCITATION A; SPI; BIST; CHANNEL A; OUTPUT A; LPC 3250; PROGRAM FLASH; CLOCK; CAL; FLASH; ETHERNET; USB; LEDS; RELAY DRIVERS; BBS; EXCITATION; BBX; POWER; SUPPLIES; SHEETS; CHANNEL A COMMON; OUTPUT; CHANNEL

1. BLOCK DIAGRAM
2. CHANNEL A
3. CHANNEL B
4. CHANNEL C
5. CHANNEL D
6. BIST
7. RELAY DRIVERS AND LEDS
8. COMMUNICATIONS
9. MICROPROCESSOR
10. MICROPROCESSOR POWER+CLOCK
11. POWER SUPPLIES

CHANNEL DACS SPI

RELAY DRIVERS SPI

CONFIDENTIAL PROPRIETARY INFORMATION
COPYRIGHT HIGHLAND TECHNOLOGY
ENGINEERING CHANGE ORDERS MAY APPLY
HIGHLAND TECHNOLOGY INC.

APPROVED

23S331 DRAWING NO: | A REV:

RELEASED
