lizlarkin/highland/client/src/Components/ProductResources/assets/P348_B_BD.pdf

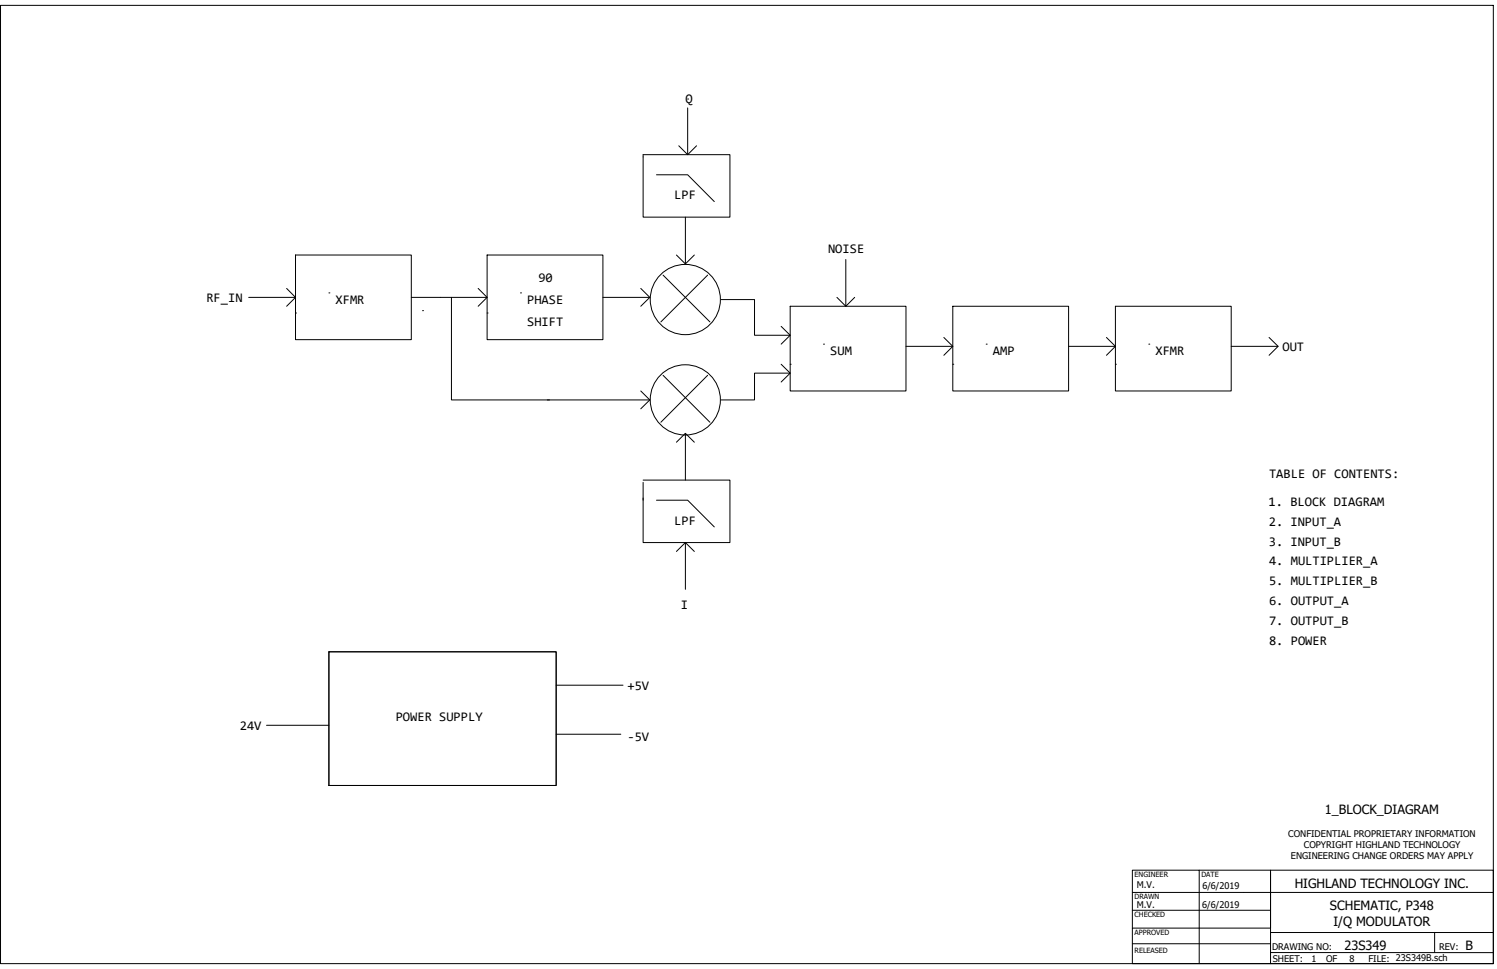
[picture p148: page 1]
FILE: 23S349B.sch; SHEET:; DRAWN; DATE; CHECKED; ENGINEER; 1_BLOCK_DIAGRAM; POWER SUPPLY; LPF; SUM; NOISE; AMP; XFMR; SHIFT; OUT; 1. BLOCK DIAGRAM 2. INPUT_A; 4. MULTIPLIER_A; 6. OUTPUT_A; 8. POWER; 3. INPUT_B; 5. MULTIPLIER_B; 7. OUTPUT_B; PHASE

TABLE OF CONTENTS:

CONFIDENTIAL PROPRIETARY INFORMATION
COPYRIGHT HIGHLAND TECHNOLOGY
ENGINEERING CHANGE ORDERS MAY APPLY
HIGHLAND TECHNOLOGY INC.
SCHEMATIC, P348
I/Q MODULATOR

APPROVED

23S349 DRAWING NO: | B REV:

RELEASED
