lizlarkin/highland/client/src/Components/ProductResources/assets/P470_C_BD.pdf

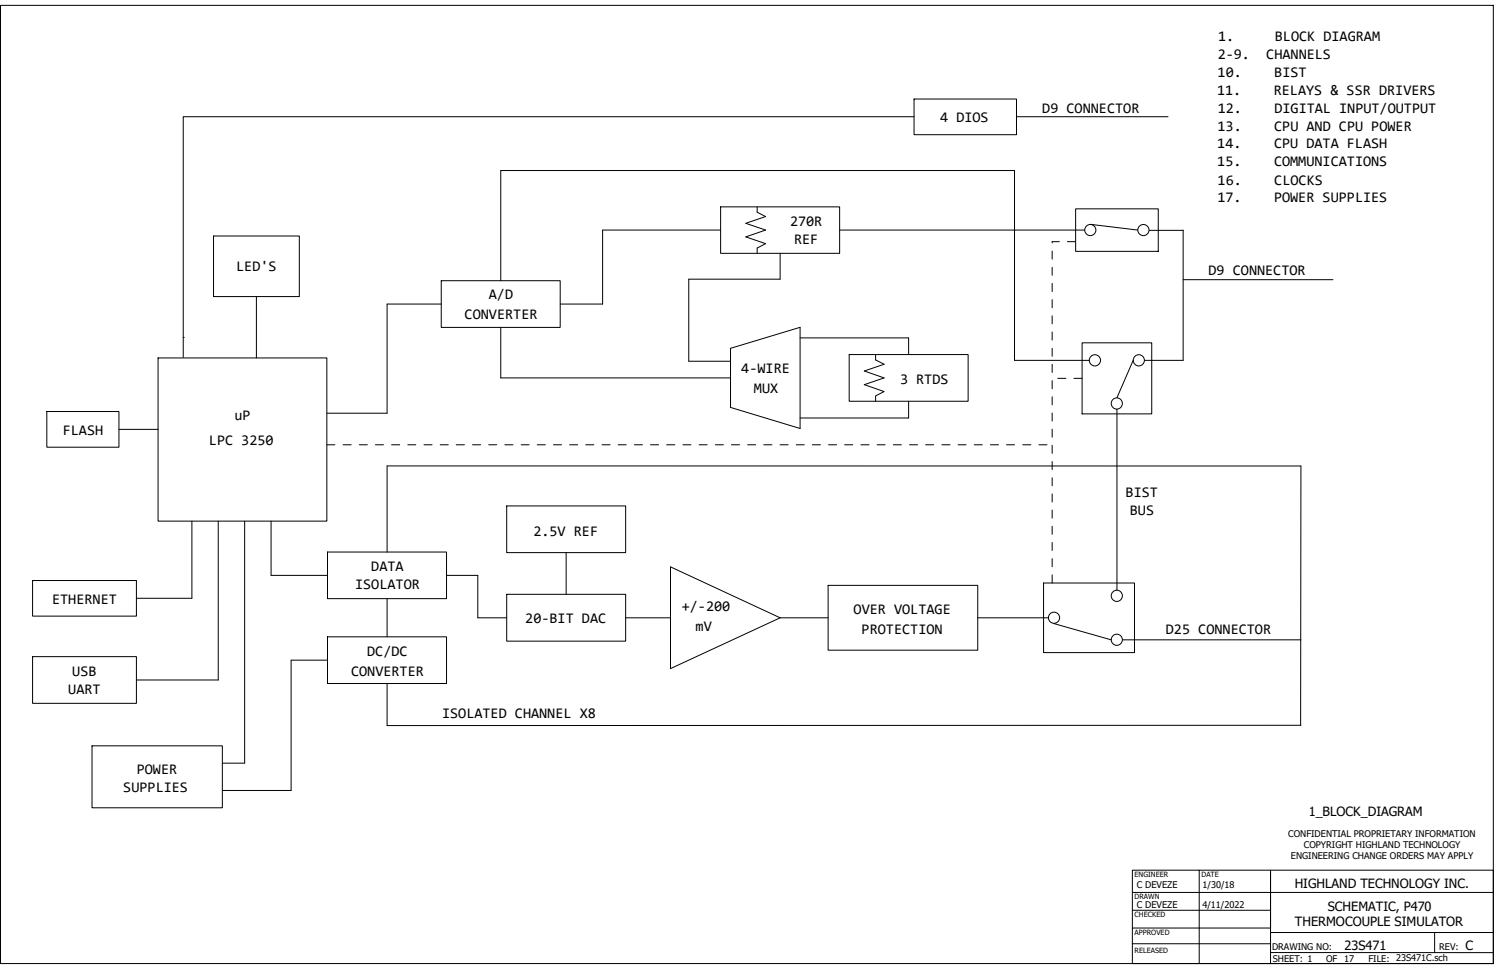
[picture p149: page 1]
1_BLOCK_DIAGRAM; 23S471C.sch; FILE:; SHEET:; C DEVEZE; DRAWN; ENGINEER; DATE; CHECKED; FLASH; ETHERNET; USB UART; POWER SUPPLIES; DATA ISOLATOR; LPC 3250; CONVERTER; 2.5V REF; 20‐BIT DAC; ISOLATED CHANNEL X8; D25 CONNECTOR; D9 CONNECTOR; PROTECTION; OVER VOLTAGE; BIST BUS; A/D CONVERTER; REF; MUX; 4‐WIRE; 3 RTDS; LED'S; 4 DIOS

1. BLOCK DIAGRAM
2‐9. CHANNELS
10. BIST
11. RELAYS & SSR DRIVERS
12. DIGITAL INPUT/OUTPUT
13. CPU AND CPU POWER
14. CPU DATA FLASH
15. COMMUNICATIONS
16. CLOCKS
17. POWER SUPPLIES

CONFIDENTIAL PROPRIETARY INFORMATION
COPYRIGHT HIGHLAND TECHNOLOGY
ENGINEERING CHANGE ORDERS MAY APPLY
HIGHLAND TECHNOLOGY INC.
SCHEMATIC, P470
THERMOCOUPLE SIMULATOR

APPROVED

23S471 DRAWING NO: | C REV:

RELEASED
