lizlarkin/highland/client/src/Components/ProductResources/assets/P500_E_BD.pdf

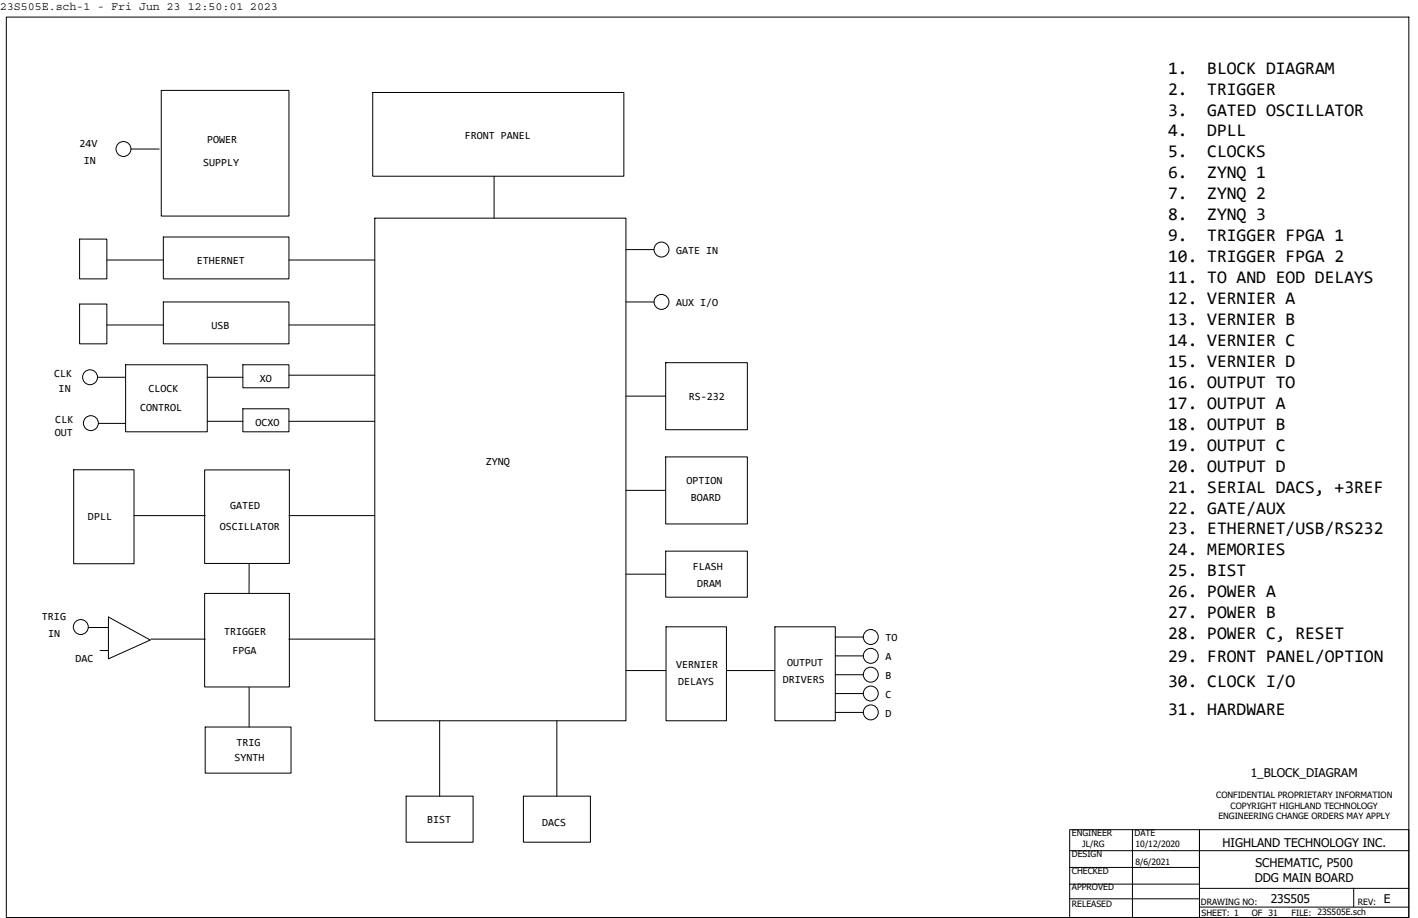
[picture p150: page 1]
DESIGN; ENGINEER; SCHEMATIC, P500; CHECKED; DATE; SHEET:; FILE: OF 31; 23S505E.sch; 1_BLOCK_DIAGRAM; OPTION; BOARD; POWER; SUPPLY; ETHERNET; USB; CLK IN; CLK OUT; CLOCK; CONTROL; OCXO; DPLL; GATED; OSCILLATOR; TRIGGER; FPGA; TRIG; DAC; TRIG SYNTH; BIST; DACS; FRONT PANEL; ZYNQ; AUX I/O; VERNIER; DELAYS; OUTPUT; DRIVERS; FLASH; DRAM; TOABCD; 1. BLOCK DIAGRAM 2. TRIGGER 3. GATED OSCILLATOR; 5. CLOCKS 6. ZYNQ; 7. ZYNQ; 11. TO AND EOD DELAYS 12. VERNIER; 13. VERNIER; 14. VERNIER; 15. VERNIER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

23S505E.sch-1 - Fri Jun 23 12:50:01 2023

CONFIDENTIAL PROPRIETARY INFORMATION
COPYRIGHT HIGHLAND TECHNOLOGY
ENGINEERING CHANGE ORDERS MAY APPLY
HIGHLAND TECHNOLOGY INC.

DDG MAIN BOARD

APPROVED
RELEASED

23S505 DRAWING NO: | E REV:
