lizlarkin/highland/client/src/Components/ProductResources/assets/P545_B_BD.pdf

> | >

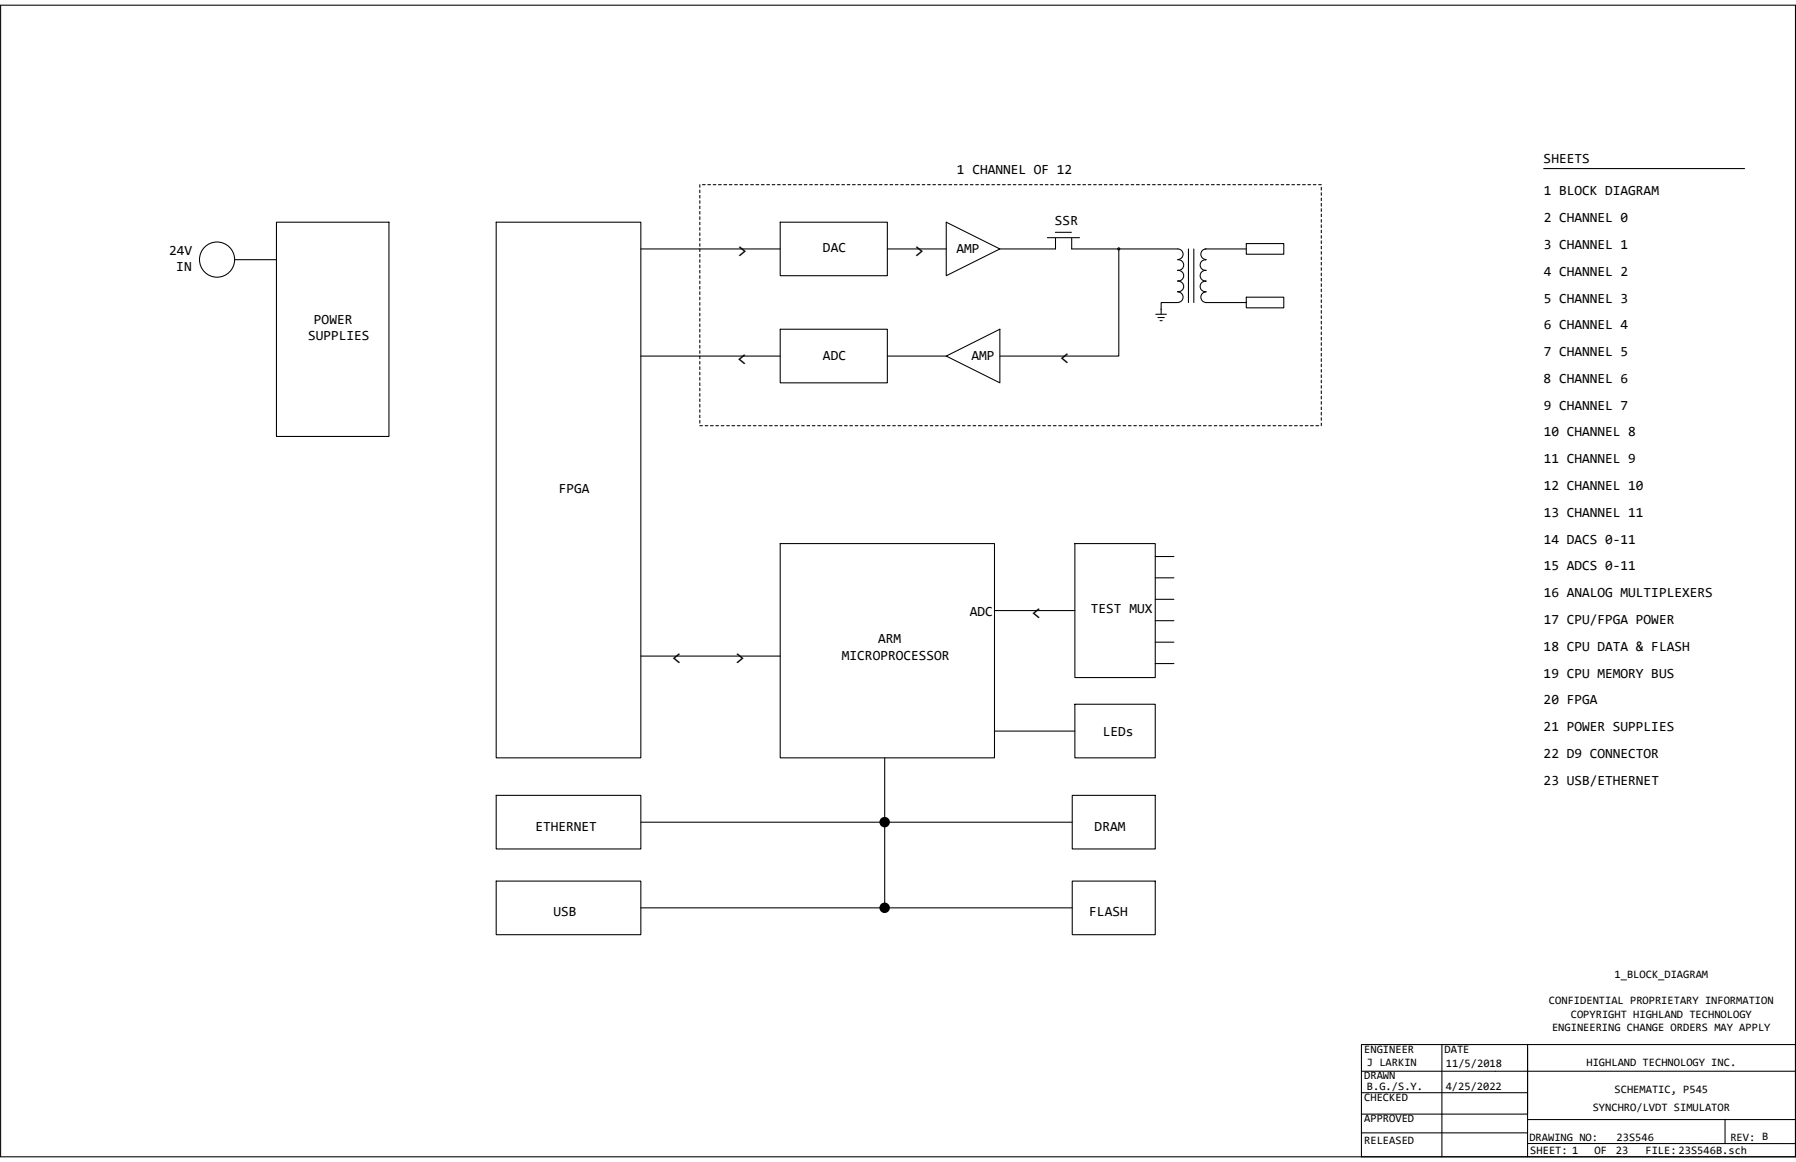
[picture p151: page 1]
J LARKIN; RELEASED; APPROVED; CHECKED; ENGINEER; DATE; DRAWN; SHEET:; DRAWING NO:; REV:; FILE: OF 23; 23S546B.sch; 1_BLOCK_DIAGRAM; AMP; SSR; ARM MICROPROCESSOR; ADC; TEST MUX; LEDs; FPGA; POWER SUPPLIES; DAC; 1 CHANNEL OF 12; 1 BLOCK DIAGRAM; 2 CHANNEL 0; 3 CHANNEL 1; 4 CHANNEL 2; 5 CHANNEL 3; 6 CHANNEL 4; 7 CHANNEL 5; 14 DACS 0‐11; 15 ADCS 0‐11; 16 ANALOG MULTIPLEXERS; 20 FPGA; 21 POWER SUPPLIES; SHEETS; 22 D9 CONNECTOR; ETHERNET; USB; DRAM; FLASH; 23 USB/ETHERNET; 8 CHANNEL 6; 9 CHANNEL 7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

17 CPU/FPGA POWER

18 CPU DATA & FLASH

19 CPU MEMORY BUS

CONFIDENTIAL PROPRIETARY INFORMATION
COPYRIGHT HIGHLAND TECHNOLOGY
ENGINEERING CHANGE ORDERS MAY APPLY

HIGHLAND TECHNOLOGY INC.

SCHEMATIC, P545
SYNCHRO/LVDT SIMULATOR
