lizlarkin/highland/client/src/Components/ProductResources/assets/P620_C_BD.pdf

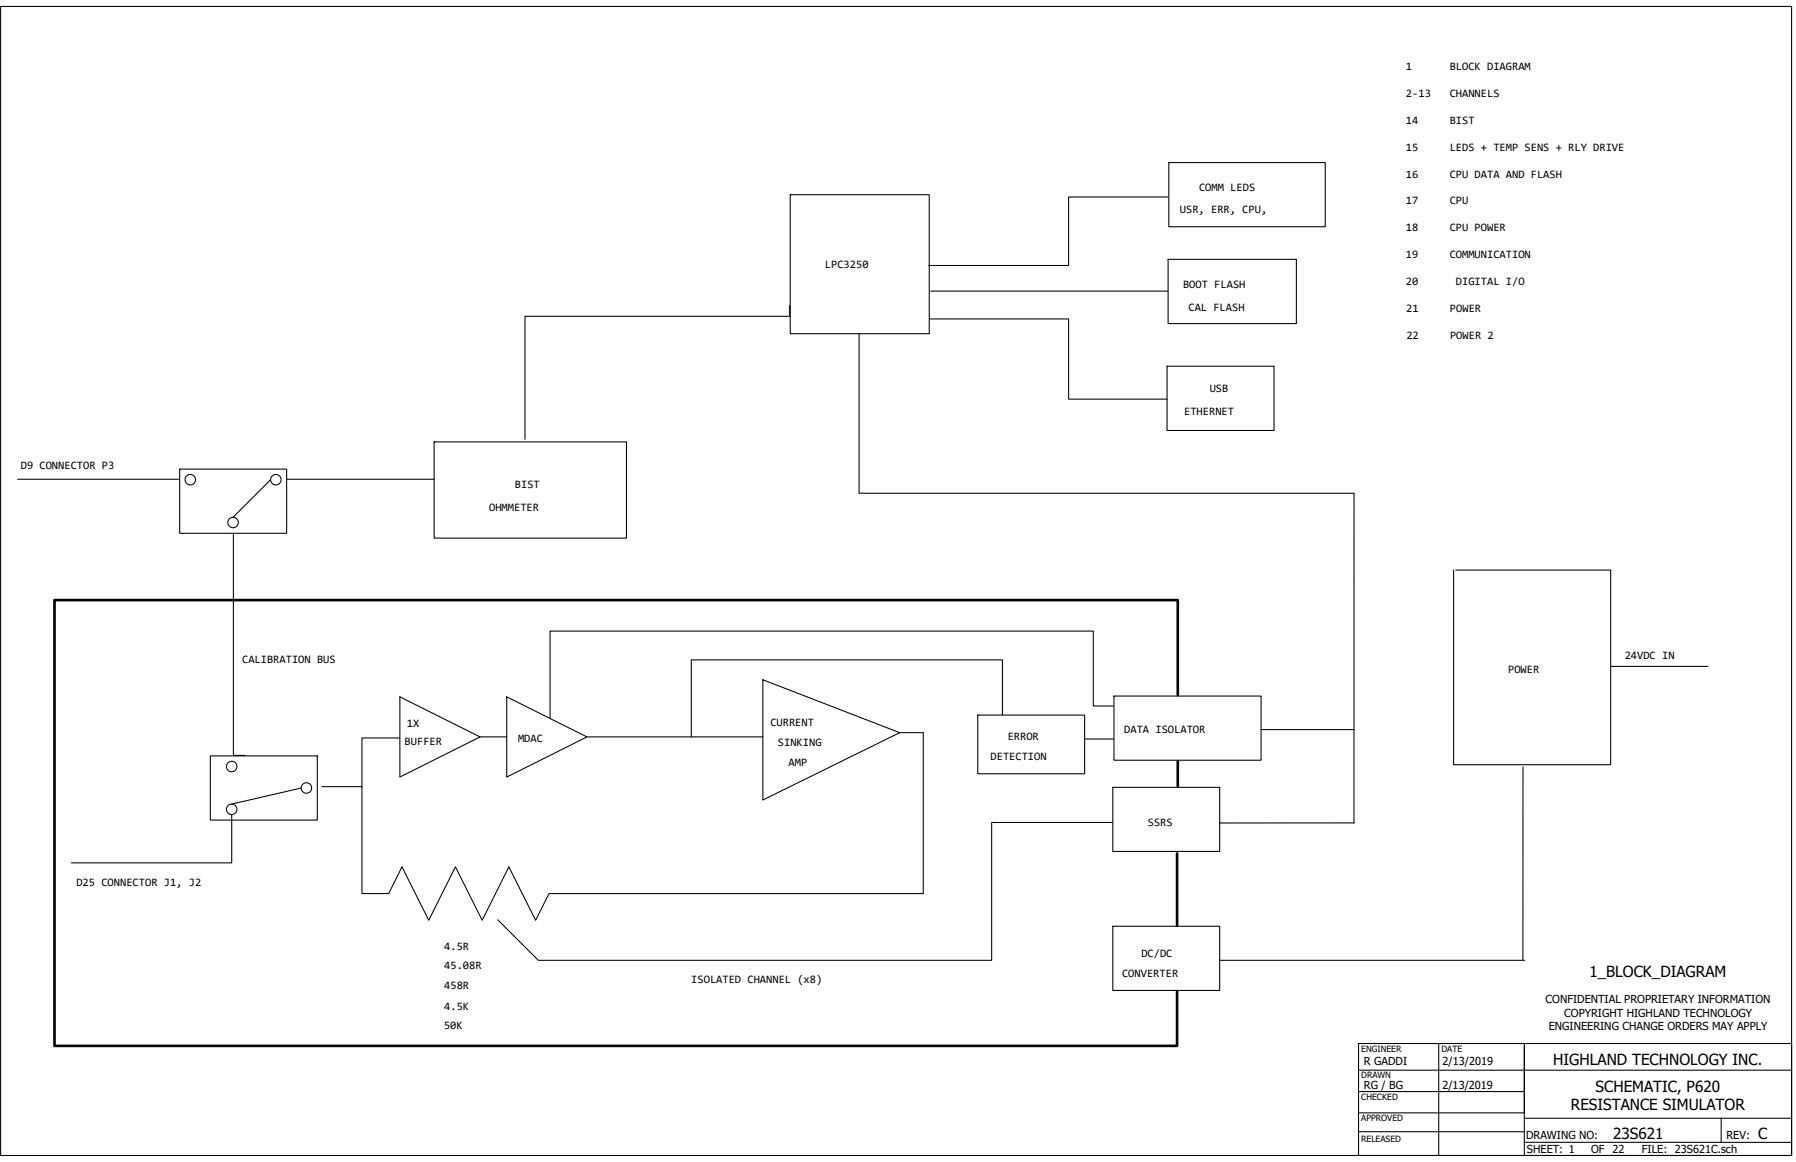
[picture p152: page 1]
USB; ETHERNET; R GADDI; CHECKED; ENGINEER; DATE; DRAWN; SHEET:; FILE: OF 22; 23S621C.sch; 1_BLOCK_DIAGRAM; BLOCK DIAGRAM; CHANNELS; BIST; CPU DATA AND FLASH; LEDS + TEMP SENS + RLY DRIVE; DIGITAL I/O; COMMUNICATION; CPU POWER; CPU; LPC3250; DATA ISOLATOR; BOOT FLASH; CAL FLASH; COMM LEDS; D25 CONNECTOR J1, J2; D9 CONNECTOR P3; CALIBRATION BUS; MDAC; CURRENT; SINKING; AMP; ERROR; DETECTION; BUFFER; SSRS; OHMMETER; POWER; 24VDC IN; POWER 2

USR, ERR, CPU,

CONVERTER ISOLATED CHANNEL (x8)

CONFIDENTIAL PROPRIETARY INFORMATION
COPYRIGHT HIGHLAND TECHNOLOGY
ENGINEERING CHANGE ORDERS MAY APPLY
HIGHLAND TECHNOLOGY INC.
SCHEMATIC, P620
RESISTANCE SIMULATOR

APPROVED

23S621 DRAWING NO: | C REV:

RELEASED
