lizlarkin/highland/client/src/Components/ProductResources/assets/P900_A_BD.pdf

# TO AMP BOARDS ABC

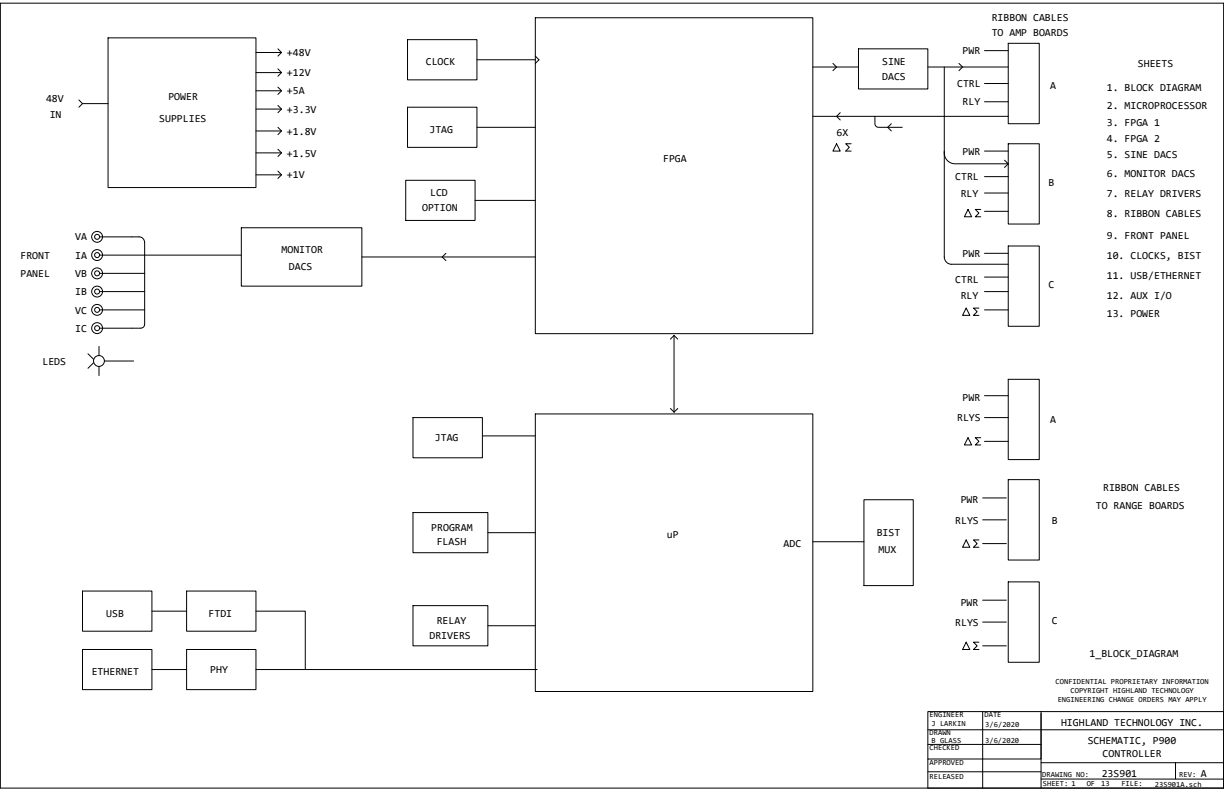
[picture p153: page 1]
1_BLOCK_DIAGRAM; CONTROLLER; SCHEMATIC, P900; B GLASS; 3/6/2020 J LARKIN; 23S901A.sch; HIGHLAND TECHNOLOGY INC.; FILE:; DRAWING NO:; REV:; SHEET:; DRAWN; ENGINEER; DATE; CHECKED; APPROVED; RELEASED; POWER; SUPPLIES; FRONT; PANEL; LEDS; MONITOR DACS; USB; ETHERNET; FTDI; PHY; CLOCK; PROGRAM FLASH; JTAG; FPGA; BIST MUX ADC; SINE DACS; PWR; CTRL; RLY; ABC; CTRL RLY; RIBBON CABLES; 1. BLOCK DIAGRAM; 2. MICROPROCESSOR 3. FPGA; 4. FPGA; SHEETS; RLYS; 5. SINE DACS; 6. MONITOR DACS; 7. RELAY DRIVERS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

RIBBON CABLES
TO RANGE BOARDS

CONFIDENTIAL PROPRIETARY INFORMATION
COPYRIGHT HIGHLAND TECHNOLOGY
ENGINEERING CHANGE ORDERS MAY APPLY
