lizlarkin/highland/client/src/Components/ProductResources/assets/P940_B_BD.pdf

## Power supplies

## Connectors to module boards

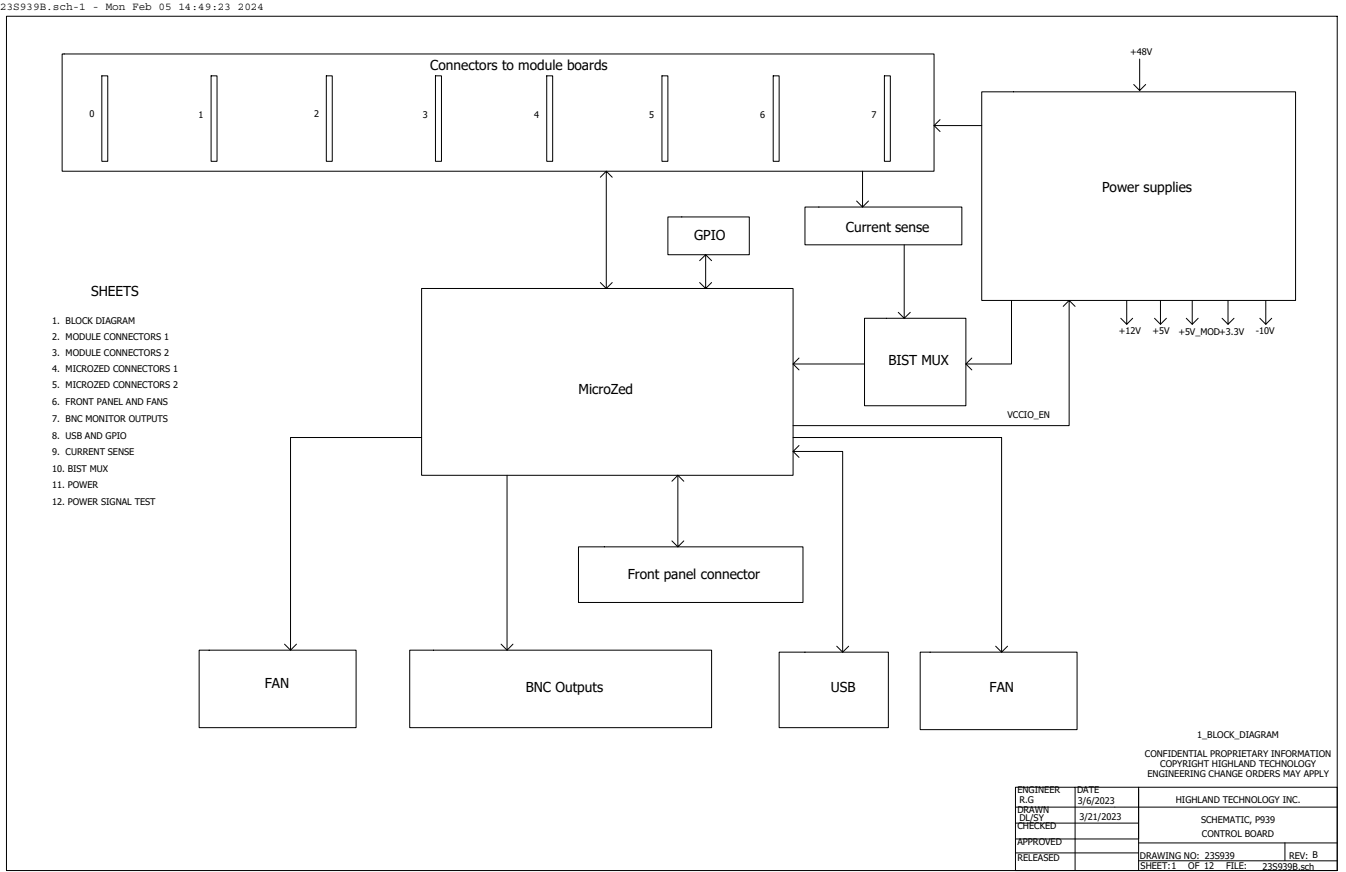
[picture p154: page 1]
23S939B.sch; 1_BLOCK_DIAGRAM; 1 OF 12 FILE:; DRAWING NO:; REV:; SHEET:; DRAWN; ENGINEER; DATE; CHECKED; FAN; BNC Outputs; USB; MicroZed; BIST MUX; Current sense; VCCIO_EN; +12V +5V +5V_MOD+3.3V -10V; SHEETS; GPIO

23S939B.sch-1 - Mon Feb 05 14:49:23 2024

1. BLOCK DIAGRAM
2. MODULE CONNECTORS 1
3. MODULE CONNECTORS 2
4. MICROZED CONNECTORS 1
5. MICROZED CONNECTORS 2
6. FRONT PANEL AND FANS
7. BNC MONITOR OUTPUTS
8. USB AND GPIO
9. CURRENT SENSE
10. BIST MUX
11. POWER
12. POWER SIGNAL TEST

Front panel connector

CONFIDENTIAL PROPRIETARY INFORMATION
COPYRIGHT HIGHLAND TECHNOLOGY
ENGINEERING CHANGE ORDERS MAY APPLY

HIGHLAND TECHNOLOGY INC.
SCHEMATIC, P939
CONTROL BOARD

APPROVED
RELEASED
