lizlarkin/highland/client/src/Components/ProductResources/assets/P350_B_BD.pdf

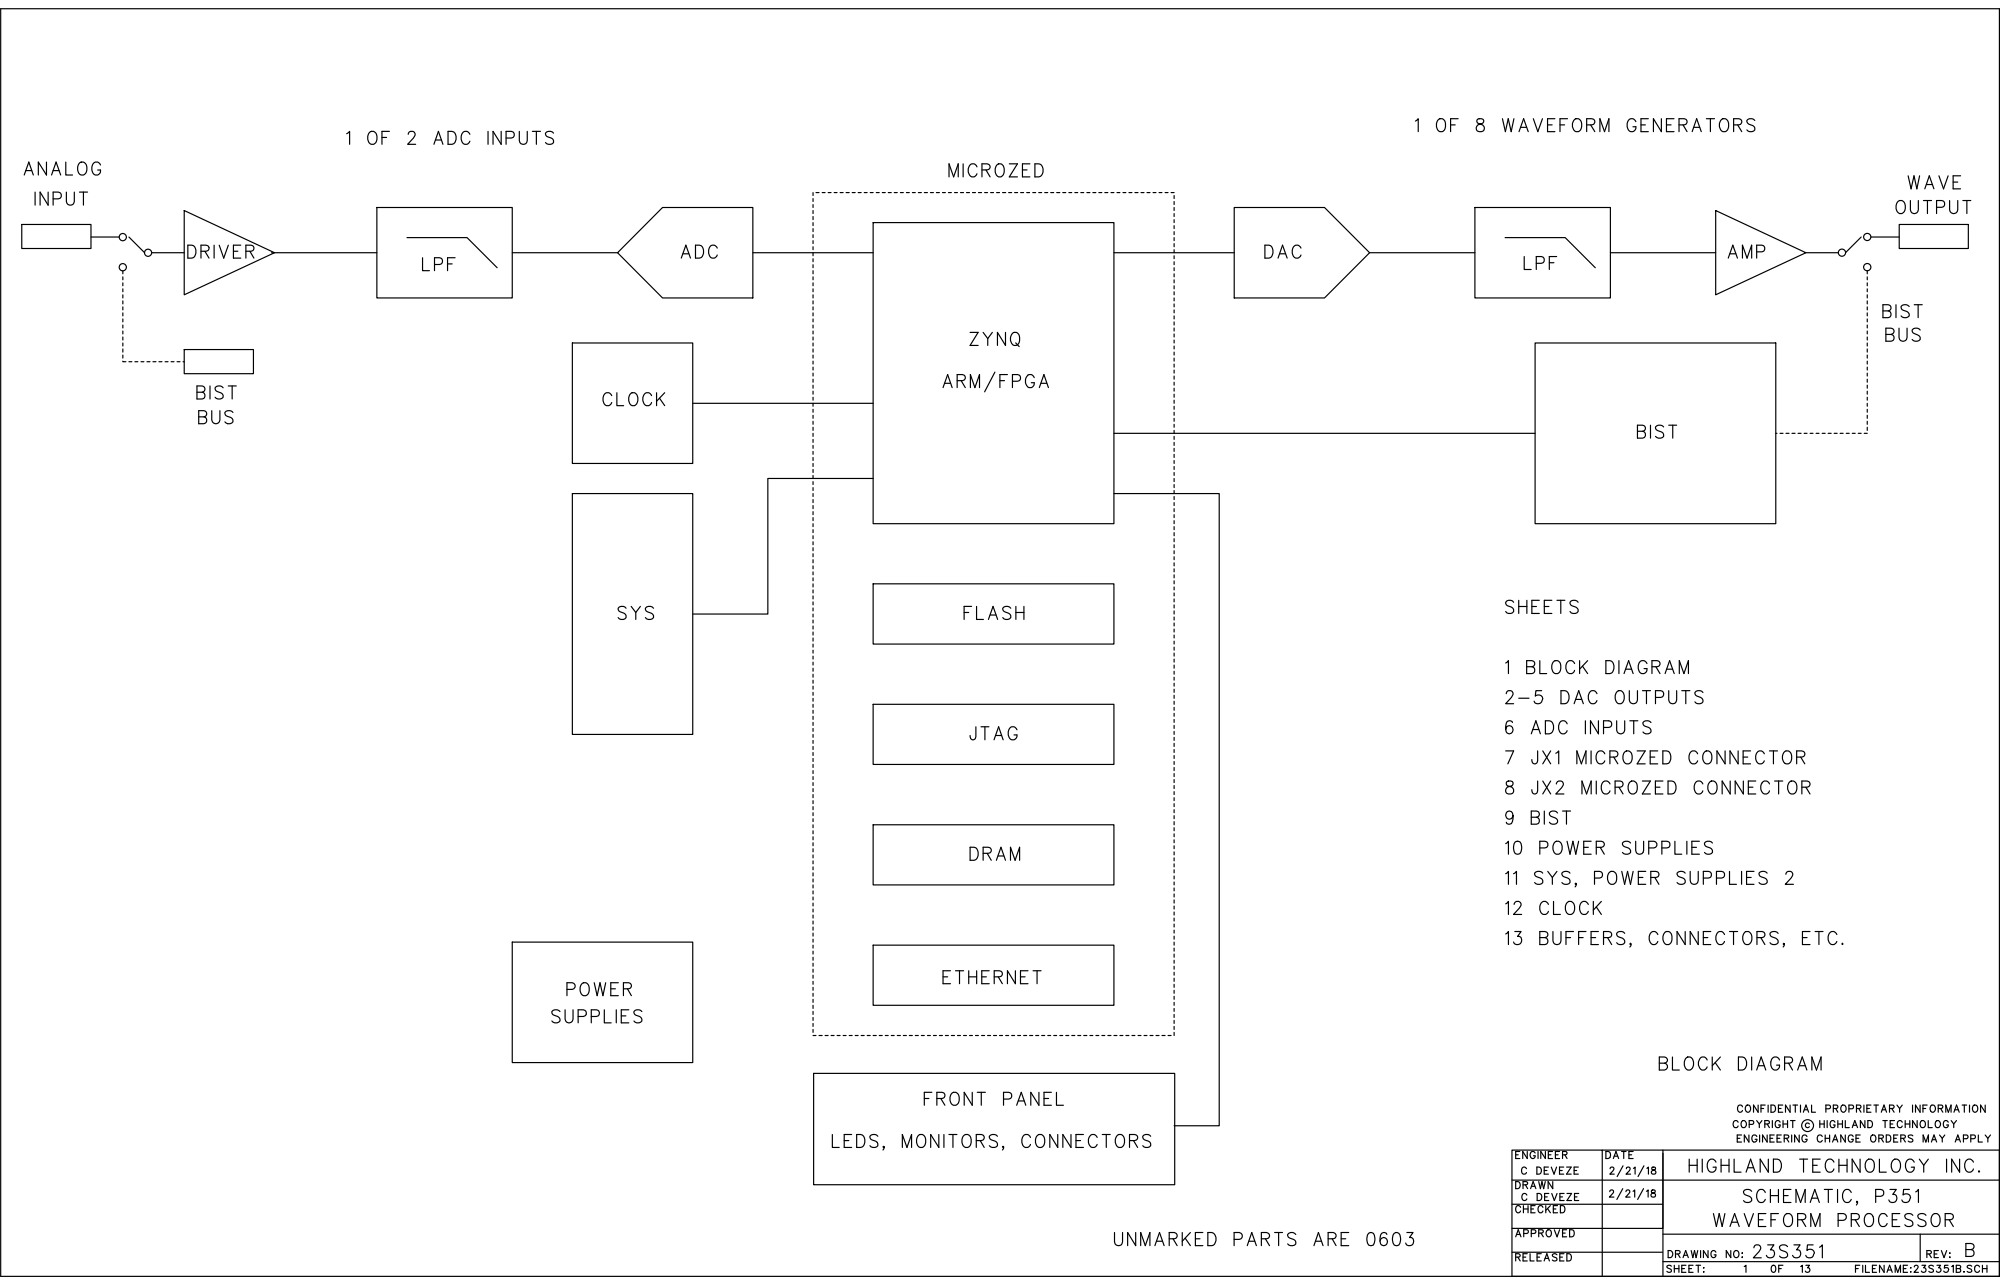
[picture p155: page 1]
