lizlarkin/highland/client/src/Components/ProductResources/assets/P400_F_BD.pdf

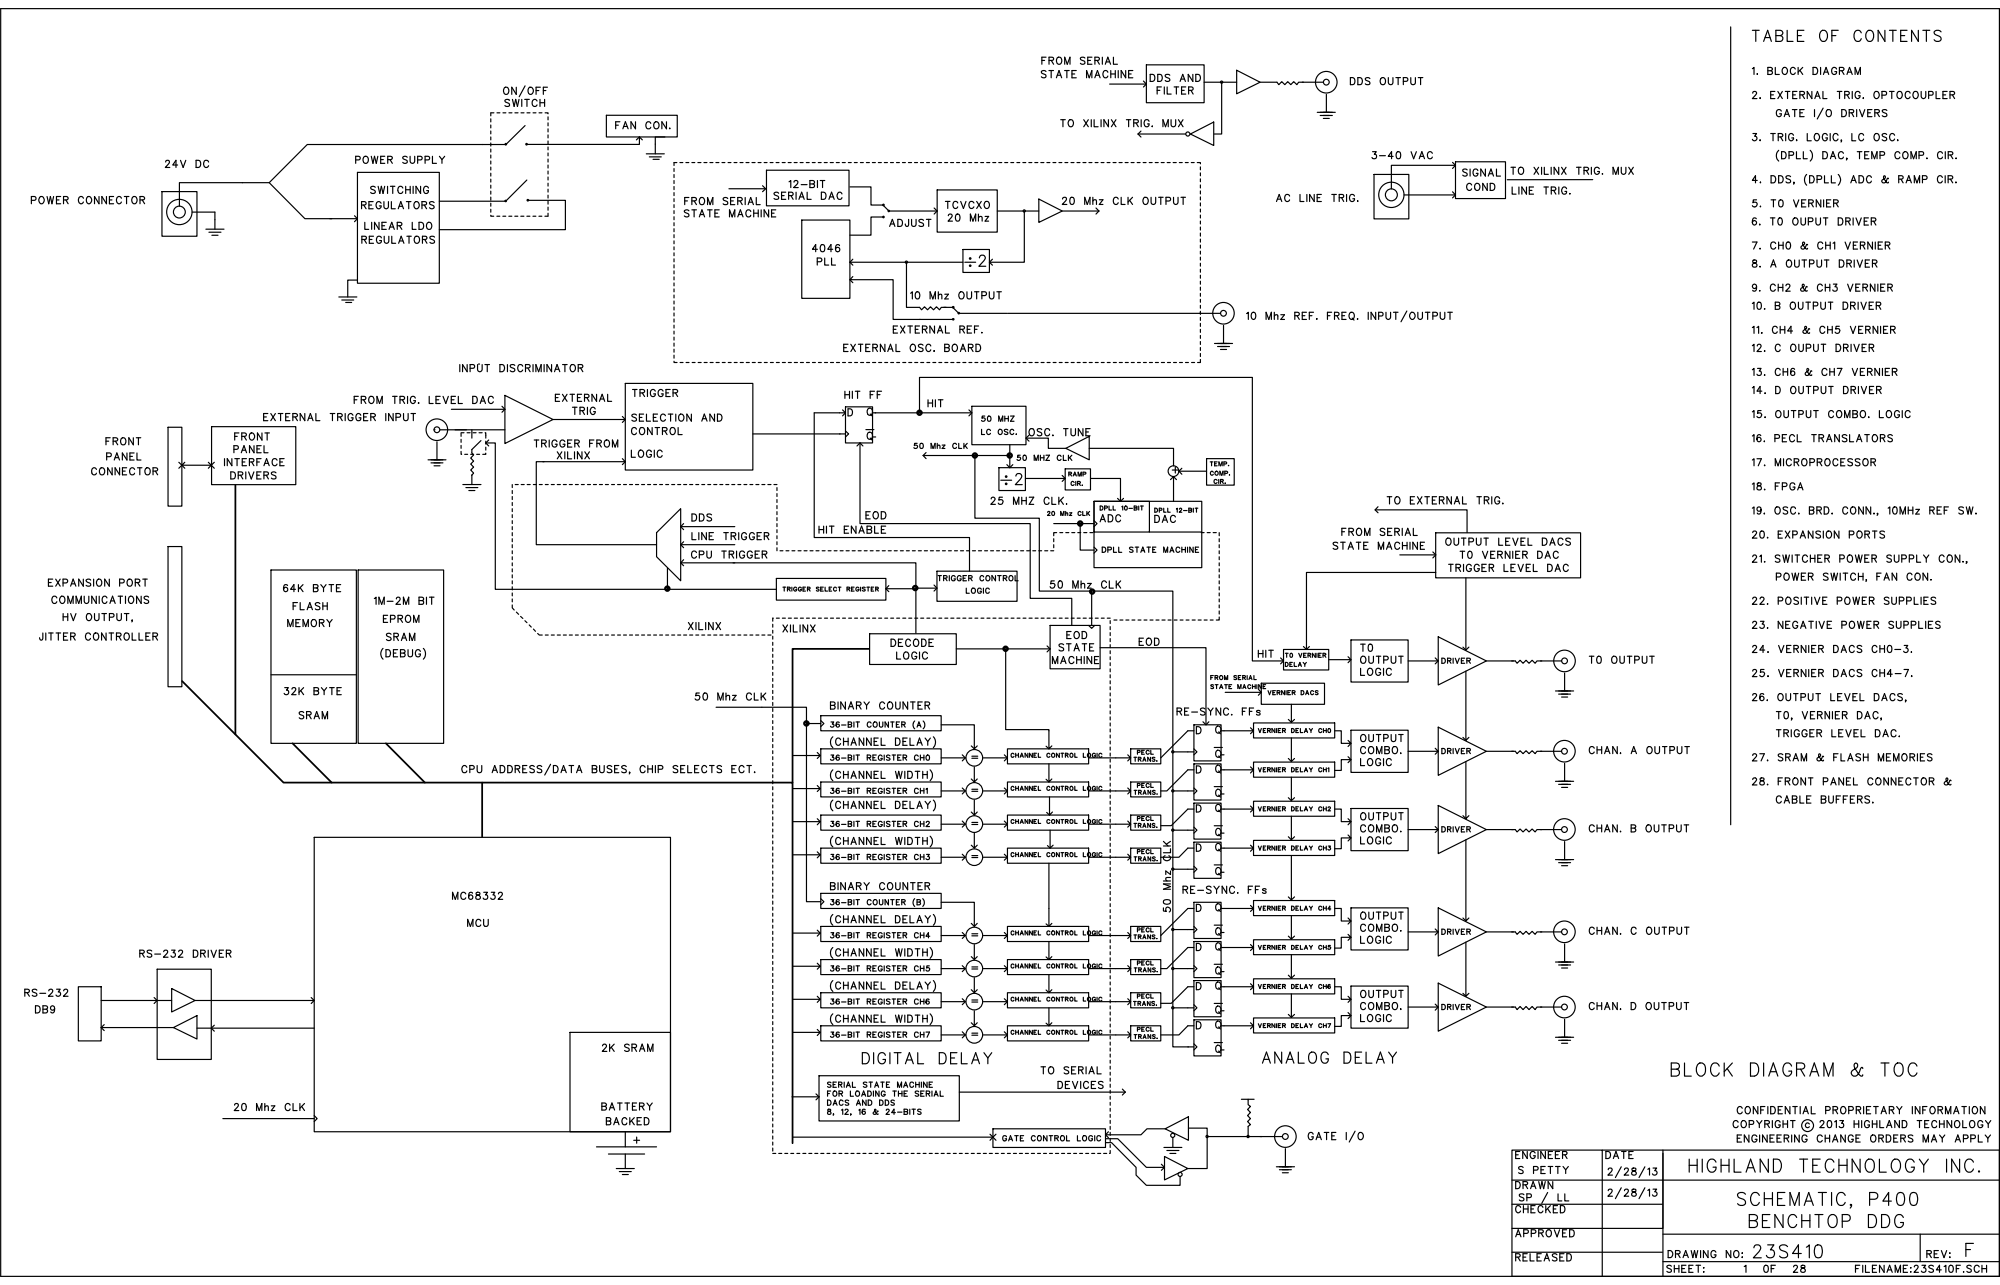
[picture p156: page 1]
