lizlarkin/highland/client/src/Components/ProductResources/assets/P730_D_BD.pdf

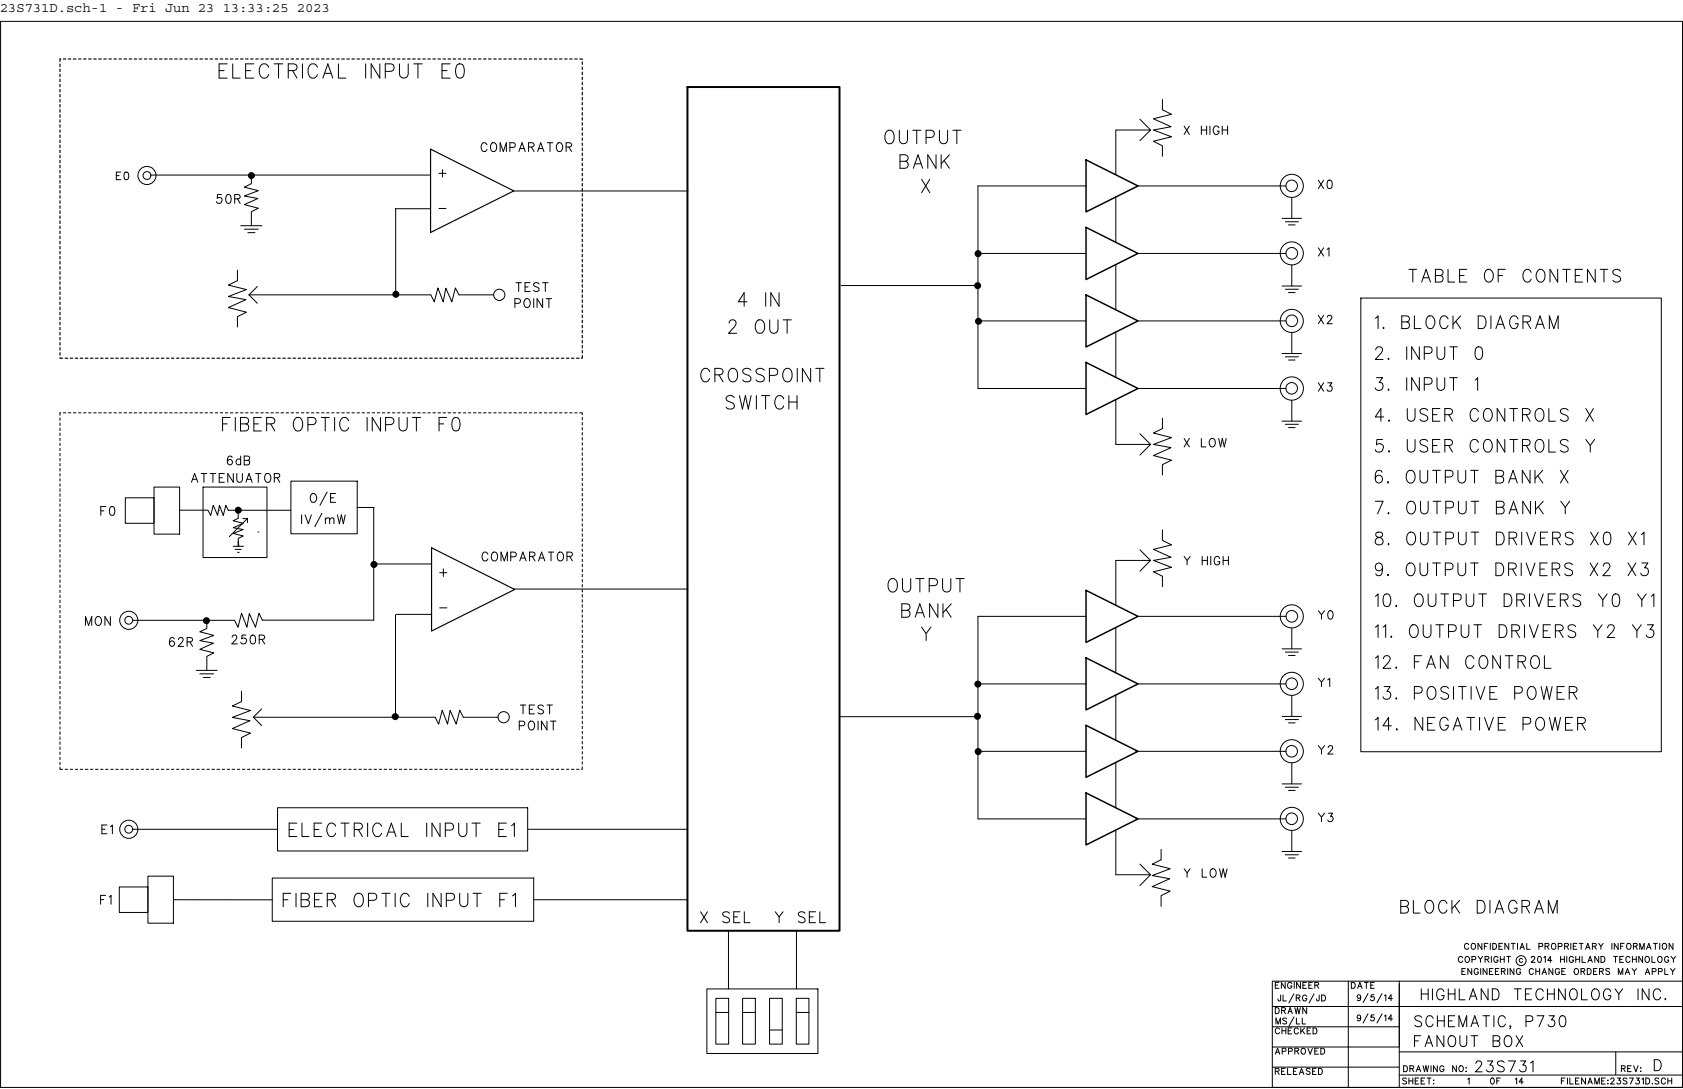
[picture p157: page 1]

23S731D.sch-1 - Fri Jun 23 13:33:25 2023
