lizlarkin/highland/(commit log)

2021-06-05 added props/mapping for specific product content to jumbotron, features, and description sections of product components
2021-07-09 cleaned up prop passing, passing only applicable nested objects rather than entire product object
2022-02-09 fixed some description overflow issues in quote and cart, cleaned up cart accessory quantites and word insertions for configuration details
2023-11-04 added Add More To Cart button from Cart page
2024-02-08 added large directories previously ignored
    [D100_17A100C.STEP, J240_J730_J750_21AXXXA_GENERIC_SILVER.STEP, J270_21a270a.STEP, J720_21M720H.STEP, J724_21A724D.STEP, P344_P348_P350_P730_23MXXXA_GENERIC_SMALL_.STEP, T124_T240_T340_T344_T346_T750_T760_T860_28AXXXA_GENERIC_SILVER.STEP, T560_T564_28A560C.STEP]
